ruralguru/ClockRadio_Motherboard/README.md

# ClockRadion_Motherboard
Clock Radio Power Audio Controller board
