ruralguru/ClockRadio_Motherboard/Documents/schematic_generation/Design_Tables.xlsx

Sheet: I2C_Addresses
Table Of I2C Addresses
UID | Priority (1:High) | Board | Ref Des | Purpose | Speed (kHz) | Addr Mask (8 bit) | Address (7 bit) / Hex
1 |  | Display | U301 | LED0 | 1000 | 1aaaaaaW | 1110111 | 77
2 |  | Display | U401 | LED1 | 1000 | 1aaaaaaW | 1111000 | 78
3 |  | Display | U501 | LED2 | 1000 | 1aaaaaaW | 1111010 | 7A
4 |  | Display | U601 | LED3 | 1000 | 1aaaaaaW | 1111011 | 7B
5 |  | Display | U701 | LED4 | 1000 | 1aaaaaaW | 1111100 | 7C
6 |  | Display | U801 | LED5 | 1000 | 1aaaaaaW | 1111101 | 7D
7 |  | Display | U201 | LEDDP | 1000 | 1aaaaaaW | 1111110 | 7E
8 |  | PhysInt | U2 | LEDPI | 1000 | 1aaaaaaW | 1111111 | 7F
9 |  | Amb | TBD | LUX | 400 | 0010100W | 0101001 | 29
10 |  | Amb | SHT35 | Humidity | 1000 | 100010aW | 1000101 | 45
11 |  | Amb | STS35 | Ambient Temp | 1000 | 100101aW | 1001011 | 4B
12 |  | Amb | ICP-10111 | Pressure | 400 | 1100011W | 1100011 | 63
13 |  | Amb | VCNL4200 | Proximity | 400 | 1010001W | 1010001 | 51
14 |  | Main | U25 | PCB Temperature | 3400 | 1001100W | 1001100 | 4C
15 |  | Main | U26 | RTC | 400 | 1101000W | 1101000 | 68
16 |  | Main | U28 | Amplifier | 400 | 001101aW | 0011010 | 1A
17 |  | Main | U301 | V6P0 PI Vsns | 2560 | 100aaaaW | 1000000 | 40
18 |  | Main | U701 | V6P0 Amb Vsns | 2560 | 100aaaaW | 1000001 | 41
19 |  | Main | U11 | V6P0 Disp Vsns | 2560 | 100aaaaW | 1000010 | 42
20 |  | Main | U14 | V12P0 Vsns | 2560 | 100aaaaW | 1000100 | 44
21 |  | Main | U17 | V3P3 I2C Vsvs | 2560 | 100aaaaW | 1000110 | 46
22 |  | Main | U19 | V3P3 Amp Vsns | 2560 | 100aaaaW | 1001000 | 48
23 |  | Main | U21 | VDD Amp Vsns | 2560 | 100aaaaW | 1001001 | 49
24 |  | Main | U23 | V3P3 BT Vsns | 2560 | 100aaaaW | 1001010 | 4A
25 |  | Main | U24 | IO Expander | 400 | a11xxxaW | 0111110 | 3E

Sheet: Physical_Interface_tether
Physical Interface Tether Visual ICD
Pin 1 | Pin 3 | Pin 5 | Pin 7
ANALOG. PI_POT | SYS_EN_N | STBY | GND
Pin 2 | Pin 4 | Pin 6 | Pin 8
I2C SCL | I2C SDA | ANALOG. PI_5WAY | V6P0_PI
Physical Interface Rev 2
Pin 1 | Pin 3 | Pin 5 | Pin 7 | Pin 9
STBY | GND | ANALOG. PI_5WAY | I2C SCL | DET. PI_N
Pin 2 | Pin 4 | Pin 6 | Pin 8 | Pin 10
V6P0_PI | GND | I2C SDA | SYS_EN_N | ANALOG. PI_POT
Visual ICD Legend
POWER | GND | Semi- Static
Data | Analog | CLK

Sheet: Display_tether
Display Tether Visual ICD
Pin 1 | Pin 3 | Pin 5 | Pin 7 | Pin 9
V6P0_DISP | GND | DISP_INT | I2C SCL | DET. DISP_N
Pin 2 | Pin 4 | Pin 6 | Pin 8 | Pin 10
V6P0_DISP | GND | I2C SDA | EN. DISP_OUT | CLK_DISP
Visual ICD Legend
POWER | GND | Semi- Static
Data | Analog | CLK

Sheet: Ambient_tether
Ambient Tether Visual ICD
Pin 1 | Pin 3 | Pin 5 | Pin 7 | Pin 9
V6P0_AMB | GND | INT. AMB_LUX_N | I2C SCL | DET. AMB_N
Pin 2 | Pin 4 | Pin 6 | Pin 8 | Pin 10
V6P0_AMB | GND | I2C SDA | INT. AMB_TEMP_N | INT. AMB_AIR_N
POWER | GND | Semi- Static
Data | Analog | CLK

Sheet: Power Estimates
V24P0 AMP Power Sense Estimates |  |  |  |  |  |  |  |  |  |  | V5P0 MCU Power Sense Estimates |  |  |  |  |  |  |  |  |  |  | V3P3 AMP Power Sense Estimates
Min OR Max | Input Voltage (V) | Output Voltage (V) | Resistor Voltage (V) | Input Current (A) | Load Current (A) | Supply Efficiency (%) | Sense Resistance (Ω) | Input Power (W) | Load Power (W) | Resistor Power (W) | Min OR Max | Input Voltage (V) | Output Voltage (V) | Resistor Voltage (V) | Input Current (A) | Load Current (A) | Supply Efficiency (%) | Sense Resistance (Ω) | Input Power (W) | Load Power (W) | Resistor Power (W) | Min OR Max | Input Voltage (V) | Output Voltage (V) | Resistor Voltage (V) | Input Current (A) | Load Current (A) | Supply Efficiency (%) | Sense Resistance (Ω) | Input Power (W) | Load Power (W) | Resistor Power (W)
Min | 30 | 24 | 0.001 | 0.020 | 0.01 | 40% | 0.10 | 0.60 | 0.24 | 1e-05 | Min | 12 | 5 | 0.00 | 0.104 | 0.10 | 40% | 0.00 | 1.25 | 0.50 | 0.00 | Min | 12 | 3.3 | 0.0001 | 0.0004583472222 | 0.001 | 60% | 0.10 | 0.01 | 0.0033 | 1e-07
Est | 30 | 24 | 0.29 | 2.539 | 2.92 | 93% | 0.10 | 76.18 | 70.00 | 0.851 | Est | 12 | 5 | 0.00 | 0.231 | 0.50 | 90% | 0.00 | 2.78 | 2.50 | 0.00 | Est | 12 | 3.3 | 0.008 | 0.026 | 0.08 | 85% | 0.10 | 0.31 | 0.26 | 0.001
Max | 30 | 24 | 0.54 | 4.80 | 5.40 | 92% | 0.10 | 144.04 | 129.60 | 2.92 | Max | 12 | 5 | 0.00 | 0.49 | 1.00 | 85% | 0.00 | 5.88 | 5.00 | 0.00 | Max | 12 | 3.3 | 0.010 | 0.03 | 0.10 | 90% | 0.10 | 0.37 | 0.33 | 0.001
V12P0 SYS Power Sense Estimates |  |  |  |  |  |  |  |  |  |  | V6P0 Disp Tether Power Sense Estimates |  |  |  |  |  |  |  |  |  |  | V3P3 I2C Power Sense Estimates
Min OR Max | Input Voltage (V) | Output Voltage (V) | Resistor Voltage (V) | Input Current (A) | Load Current (A) | Supply Efficiency (%) | Sense Resistance (Ω) | Input Power (W) | Load Power (W) | Resistor Power (W) | Min OR Max | Input Voltage (V) | Output Voltage (V) | Resistor Voltage (V) | Input Current (A) | Load Current (A) | Supply Efficiency (%) | Sense Resistance (Ω) | Input Power (W) | Load Power (W) | Resistor Power (W) | Min OR Max | Input Voltage (V) | Output Voltage (V) | Resistor Voltage (V) | Input Current (A) | Load Current (A) | Supply Efficiency (%) | Sense Resistance (Ω) | Input Power (W) | Load Power (W) | Resistor Power (W)
Min | 30 | 12 | 0.01 | 0.100 | 0.10 | 40% | 0.10 | 3.00 | 1.20 | 0.001 | Min | 12 | 6 | 0.01 | 0.125 | 0.10 | 40% | 0.10 | 1.50 | 0.60 | 0.001 | Min | 12 | 3.3 | 0.0001 | 0.0004583472222 | 0.001 | 60% | 0.10 | 0.01 | 0.0033 | 1e-07
Est | 30 | 12 | 0.15 | 0.688 | 1.53 | 90% | 0.10 | 20.63 | 18.34 | 0.233 | Est | 12 | 6 | 0.04 | 0.229 | 0.40 | 88% | 0.10 | 2.75 | 2.40 | 0.016 | Est | 12 | 3.3 | 0.008 | 0.026 | 0.08 | 85% | 0.10 | 0.31 | 0.26 | 0.001
Max | 30 | 12 | 0.54 | 2.56 | 5.40 | 88% | 0.10 | 76.95 | 64.80 | 2.92 | Max | 12 | 6 | 0.08 | 0.47 | 0.75 | 80% | 0.10 | 5.70 | 4.50 | 0.06 | Max | 12 | 3.3 | 0.010 | 0.03 | 0.10 | 90% | 0.10 | 0.37 | 0.33 | 0.001
V6P0 Disp Tether Power Sense Estimates |  |  |  |  |  |  |  |  |  |  | V6P0 Ambient Tether Power Sense Estimates |  |  |  |  |  |  |  |  |  |  | V3P3 Bluetooth Power Sense Estimates
Min OR Max | Input Voltage (V) | Output Voltage (V) | Resistor Voltage (V) | Input Current (A) | Load Current (A) | Supply Efficiency (%) | Sense Resistance (Ω) | Input Power (W) | Load Power (W) | Resistor Power (W) | Min OR Max | Input Voltage (V) | Output Voltage (V) | Resistor Voltage (V) | Input Current (A) | Load Current (A) | Supply Efficiency (%) | Sense Resistance (Ω) | Input Power (W) | Load Power (W) | Resistor Power (W) | Min OR Max | Input Voltage (V) | Output Voltage (V) | Resistor Voltage (V) | Input Current (A) | Load Current (A) | Supply Efficiency (%) | Sense Resistance (Ω) | Input Power (W) | Load Power (W) | Resistor Power (W)
Min | 12 | 6 | 0.01 | 0.125 | 0.10 | 40% | 0.10 | 1.50 | 0.60 | 0.001 | Min | 12 | 6 | 0.01 | 0.125 | 0.10 | 40% | 0.10 | 1.50 | 0.60 | 0.001 | Min | 12 | 3.3 | 0.0001 | 0.0004583472222 | 0.001 | 60% | 0.10 | 0.01 | 0.0033 | 1e-07
Est | 12 | 6 | 0.12 | 0.703 | 1.20 | 87% | 0.10 | 8.44 | 7.20 | 0.144 | Est | 12 | 6 | 0.05 | 0.286 | 0.50 | 88% | 0.10 | 3.44 | 3.00 | 0.025 | Est | 12 | 3.3 | 0.008 | 0.026 | 0.08 | 85% | 0.10 | 0.31 | 0.26 | 0.001
Max | 12 | 6 | 0.20 | 1.38 | 2.00 | 75% | 0.10 | 16.53 | 12.00 | 0.40 | Max | 12 | 6 | 0.08 | 0.47 | 0.75 | 80% | 0.10 | 5.70 | 4.50 | 0.06 | Max | 12 | 3.3 | 0.010 | 0.03 | 0.10 | 90% | 0.10 | 0.37 | 0.33 | 0.001
Input Power Estimates
Min Max | Input Voltage (V) |  | Input Current (A) |  | Input Power (W) |  | Input Resistance (Ω)
Min | 30 |  | 0.12 |  | 3.60 |  | 249.82
Est | 30 |  | 3.23 |  | 96.82 |  | 9.30
Max | 30 |  | 7.37 |  | 220.99 |  | 4.07
