ruralguru/ClockRadio_Motherboard/Documents/Block_Diagram/clockradio_main.pdf

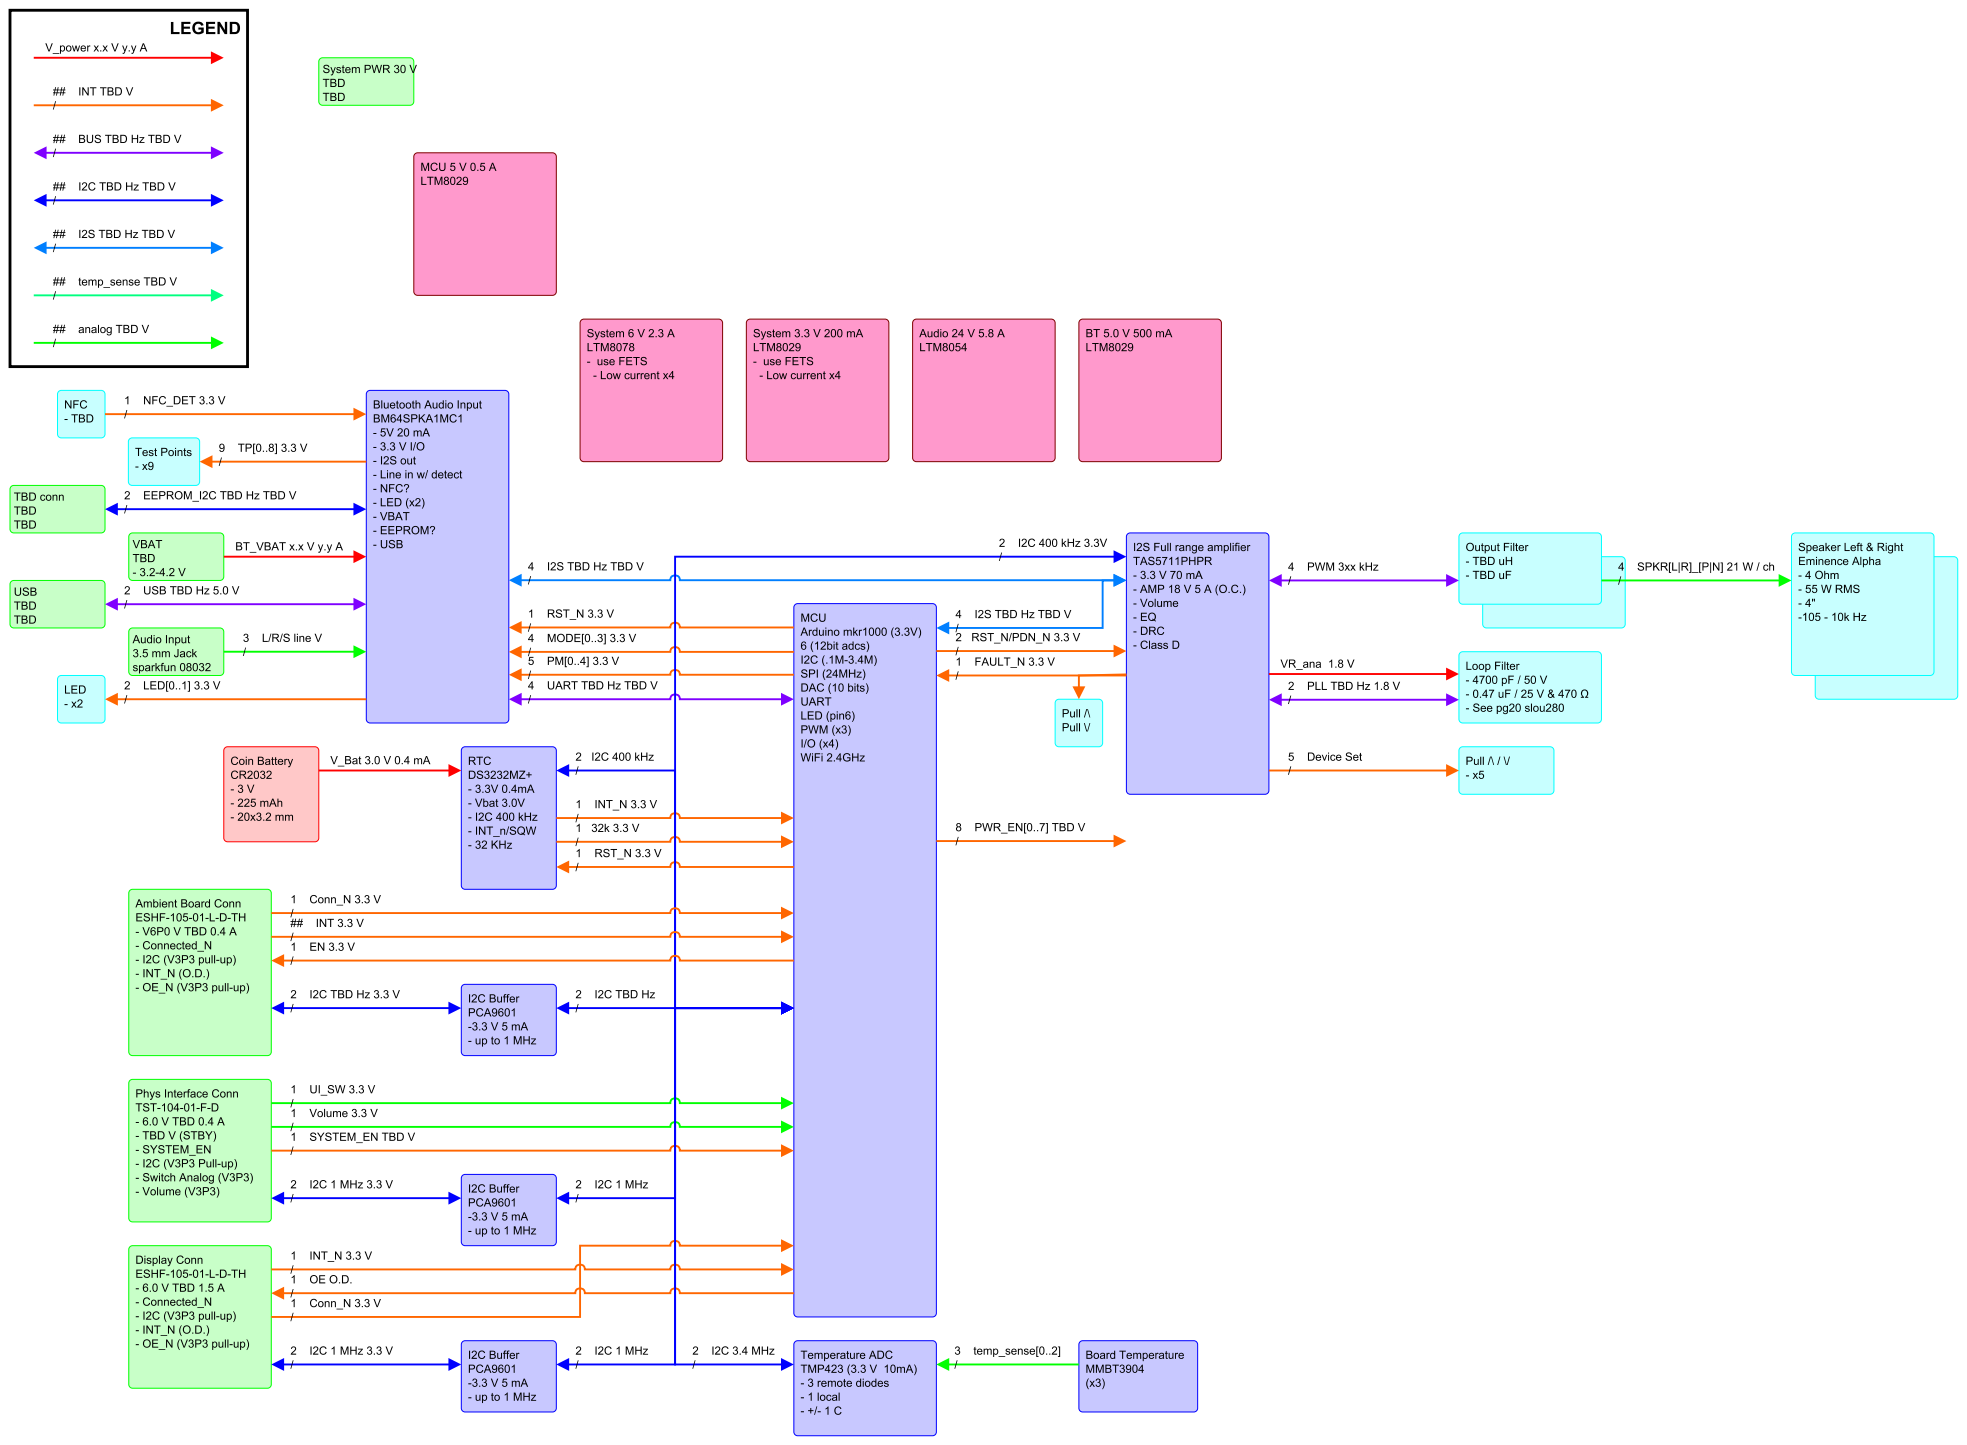
[picture p1: page 1]
