ruralguru/ClockRadio_Motherboard/3p5mm_jack.kicad_sch

## KiCad design 3p5mm_jack.kicad_sch (2022-05-10)

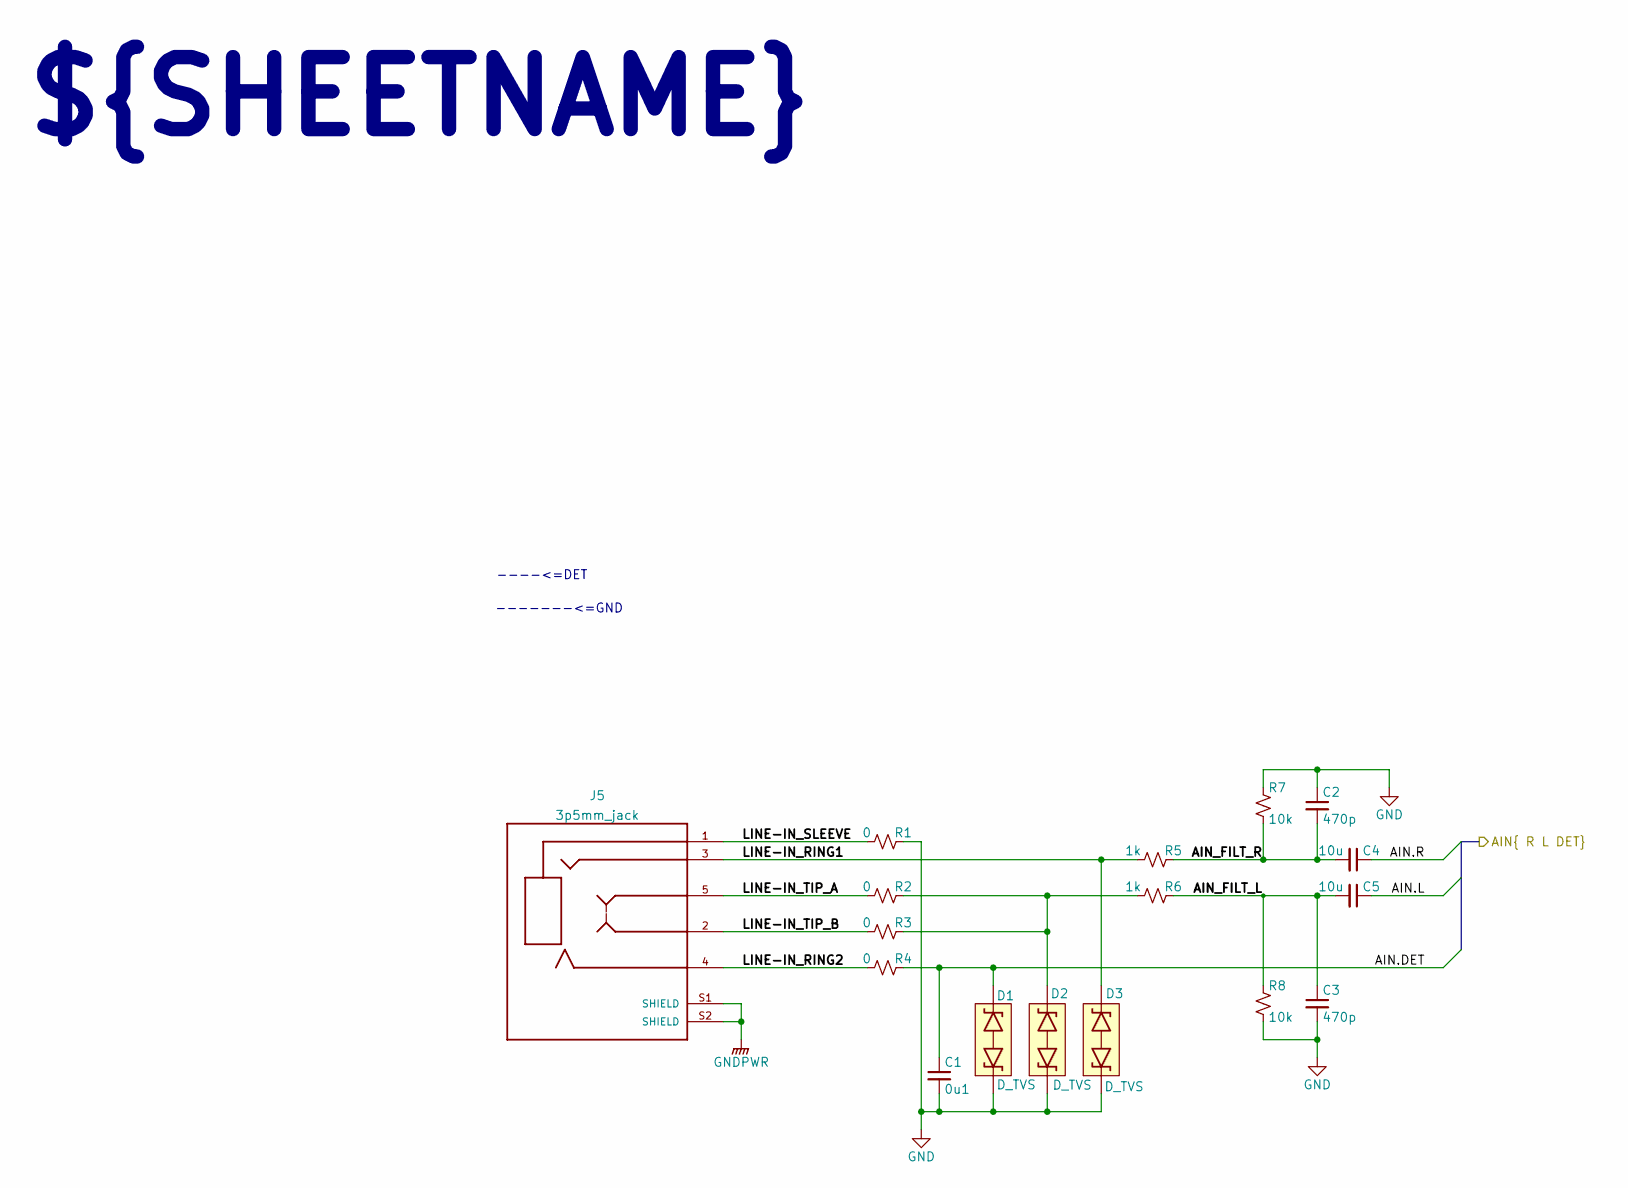
[picture p2: schematic 3p5mm_jack.kicad_sch]

Parts:
C1: 0u1; C_0603_1608Metric_Pad1.08x0.95mm_HandSolder; MPN C0603C104J5RACTU
C2, C3: 470p; C_0603_1608Metric_Pad1.08x0.95mm_HandSolder; MPN CC0603KPX7R9BB471
C4, C5: 10u; C_0805_2012Metric_Pad1.18x1.45mm_HandSolder; MPN EMK212BB7106KG-T
D1, D2, D3: D_TVS; D_SOD-962; MPN SPE0572
J5: 3p5mm_jack; CUI_SJ-3541AS-SMT-TR-67; MPN SJ-3541AS-SMT-TR-67
R1, R2, R3, R4: 0; R_0603_1608Metric_Pad0.98x0.95mm_HandSolder; MPN RC0603FR-130RL
R5, R6: 1k; R_0603_1608Metric_Pad0.98x0.95mm_HandSolder; MPN AC0603FR-101KL
R7, R8: 10k; R_0603_1608Metric_Pad0.98x0.95mm_HandSolder; MPN AC0603FR-1310KL

Connections:
AIN.DET: C1.1, D1.2 (A2), R4.1
AIN.L: C5.1
AIN.R: C4.1
AIN_FILT_L: C3.1, C5.2, R6.1, R8.1
AIN_FILT_R: C2.2, C4.2, R5.1, R7.2
GND: C1.2, C2.1, C3.2, D1.1 (A1), D2.1 (A1), D3.1 (A1), R1.1, R7.1, R8.2
GNDPWR: J5.S1 (SHIELD), J5.S2 (SHIELD)
LINE-IN_RING1: D3.2 (A2), J5.3, R5.2
LINE-IN_RING2: J5.4, R4.2
LINE-IN_SLEEVE: J5.1, R1.2
LINE-IN_TIP_A: J5.5, R2.2
LINE-IN_TIP_B: J5.2, R3.2
unnamed: D2.2 (A2), R2.1, R3.1, R6.2

Notes on the sheet:
-------<=GND
${SHEETNAME}
----<=DET
