ruralguru/ClockRadio_Motherboard/AMP_PWR_GND.kicad_sch

## KiCad design AMP_PWR_GND.kicad_sch (2022-05-10)

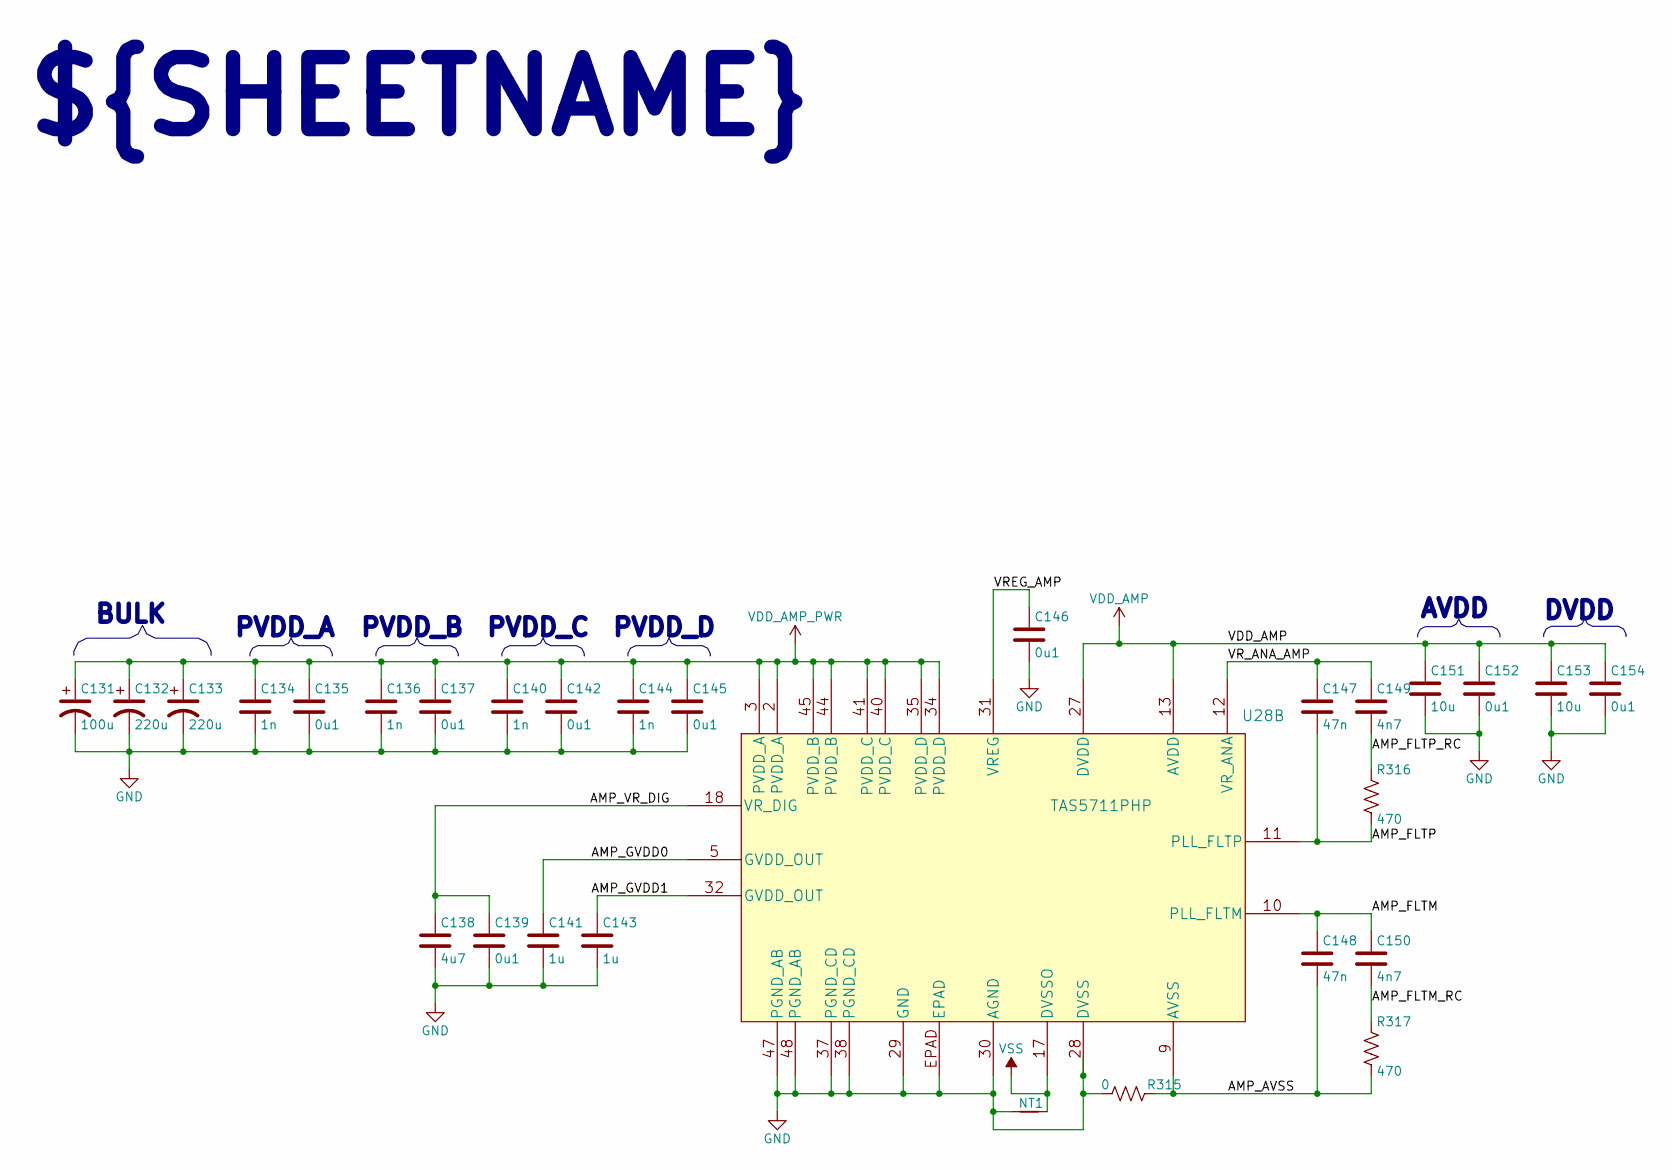
[picture p3: schematic AMP_PWR_GND.kicad_sch]

Parts:
C131: 100u; CP_Radial_D12.5mm_P5.00mm; MPN UPJ1J101MHD6
C132, C133: 220u; CP_Radial_D10.0mm_P5.00mm; MPN B41858C6227M
C134, C136, C140, C144: 1n; C_0603_1608Metric_Pad1.08x0.95mm_HandSolder; MPN C0603C102J5RACTU
C135, C137, C139, C142, C145, C146, C152, C154: 0u1; C_0603_1608Metric_Pad1.08x0.95mm_HandSolder; MPN C0603C104J5RACTU
C138: 4u7; C_1206_3216Metric_Pad1.33x1.80mm_HandSolder; MPN CL31B475KBHNFNE
C141, C143: 1u; C_0805_2012Metric_Pad1.18x1.45mm_HandSolder; MPN CL21B105KBFNFNE
C147, C148: 47n; C_0603_1608Metric_Pad1.08x0.95mm_HandSolder; MPN CL10B473KB8NNNL
C149, C150: 4n7; C_0603_1608Metric_Pad1.08x0.95mm_HandSolder; MPN CC0603KRX7R9BB472
C151, C153: 10u; C_0805_2012Metric_Pad1.18x1.45mm_HandSolder; MPN EMK212BB7106KG-T
NT1: VSSO; NetTie-2_SMD_Pad2.0mm
R315: 0; R_0603_1608Metric_Pad0.98x0.95mm_HandSolder; MPN RC0603FR-130RL
R316, R317: 470; R_0603_1608Metric_Pad0.98x0.95mm_HandSolder; MPN RC0603FR-07470RL
U28: TAS5711PHP; QFP48_EP; MPN TAS5711PHPR

Connections:
AMP_AVSS: C148.2, R315.1, R317.1, U28.9 (AVSS)
AMP_FLTM: C148.1, C150.1, U28.10 (PLL_FLTM)
AMP_FLTM_RC: C150.2, R317.2
AMP_FLTP: C147.2, R316.1, U28.11 (PLL_FLTP)
AMP_FLTP_RC: C149.2, R316.2
AMP_GVDD0: C141.1, U28.5 (GVDD_OUT)
AMP_GVDD1: C143.1, U28.32 (GVDD_OUT)
AMP_VR_DIG: C138.1, C139.1, U28.18 (VR_DIG)
GND: C131.2, C132.2, C133.2, C134.2, C135.2, C136.2, C137.2, C138.2, C139.2, C140.2, C141.2, C142.2, C143.2, C144.2, C145.2, C146.2, C151.2, C152.2, C153.2, C154.2, NT1.1, R315.2, U28.28 (DVSS), U28.29 (GND), U28.30 (AGND), U28.37 (PGND_CD), U28.38 (PGND_CD), U28.47 (PGND_AB), U28.48 (PGND_AB), U28.EPAD
VDD_AMP: C151.1, C152.1, C153.1, C154.1, U28.13 (AVDD), U28.27 (DVDD)
VDD_AMP_PWR: C131.1, C132.1, C133.1, C134.1, C135.1, C136.1, C137.1, C140.1, C142.1, C144.1, C145.1, U28.2 (PVDD_A), U28.3 (PVDD_A), U28.34 (PVDD_D), U28.35 (PVDD_D), U28.40 (PVDD_C), U28.41 (PVDD_C), U28.44 (PVDD_B), U28.45 (PVDD_B)
VREG_AMP: C146.1, U28.31 (VREG)
VR_ANA_AMP: C147.1, C149.1, U28.12 (VR_ANA)
VSS: NT1.2, U28.17 (DVSSO)

Notes on the sheet:
BULK
PVDD_D
PVDD_A
${SHEETNAME}
PVDD_C
PVDD_B
AVDD
DVDD
