ruralguru/ClockRadio_Motherboard/Amplifier.kicad_sch

## KiCad design Amplifier.kicad_sch (2022-05-10)

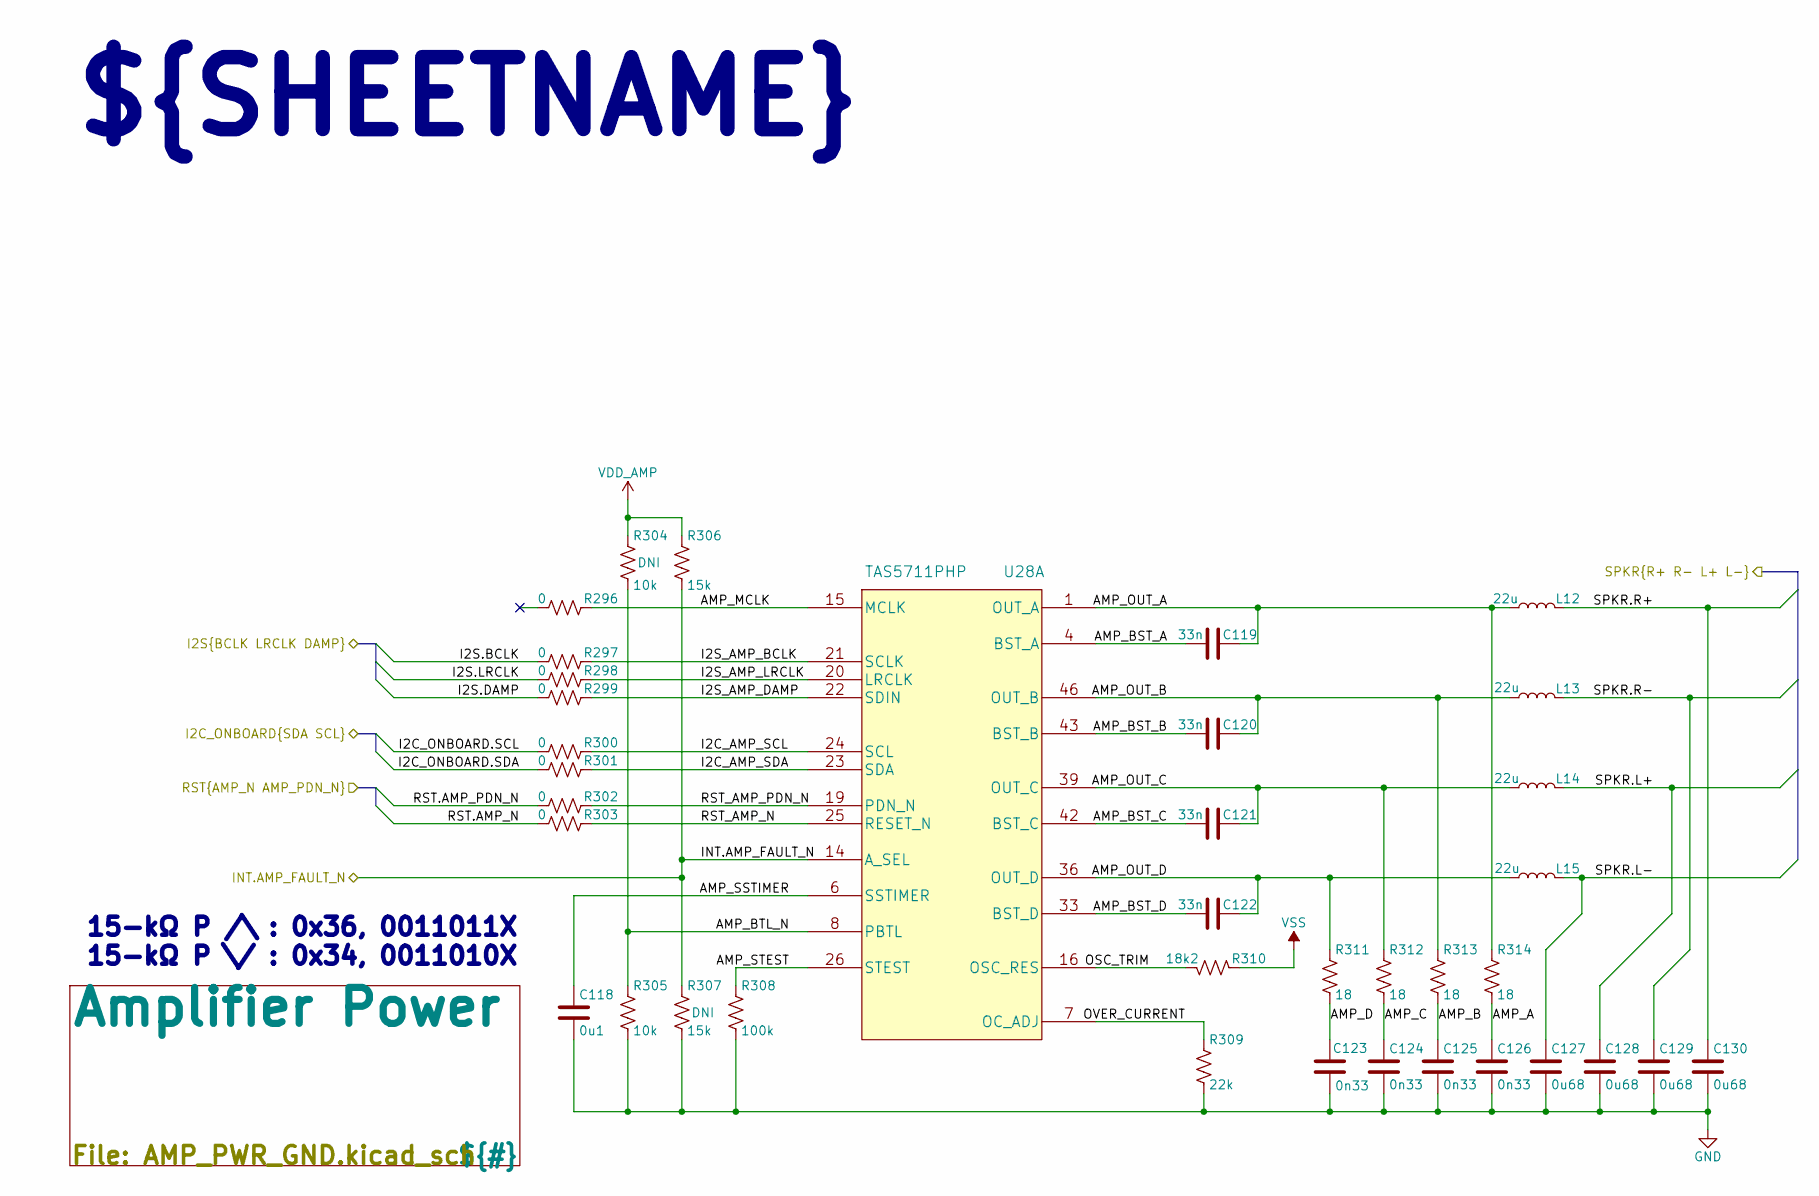
[picture p4: schematic Amplifier.kicad_sch]

Parts:
C118: 0u1; C_0603_1608Metric_Pad1.08x0.95mm_HandSolder; MPN C0603C104J5RACTU
C119, C120, C121, C122: 33n; C_0603_1608Metric_Pad1.08x0.95mm_HandSolder; MPN CC0603JRX7R9BB333
C123, C124, C125, C126: 0n33; C_0805_2012Metric_Pad1.18x1.45mm_HandSolder; MPN C0805C331G5GACTU
C127, C128, C129, C130: 0u68; C_1206_3216Metric_Pad1.33x1.80mm_HandSolder; MPN C1206C684K5RACTU
L12, L13, L14, L15: 22u; L_Radial_D7.5mm_P3.50mm_Fastron_07P; MPN DR0608-223L
R296, R297, R298, R299, R300, R301, R302, R303: 0; R_0603_1608Metric_Pad0.98x0.95mm_HandSolder; MPN RC0603FR-130RL
R304, R305: 10k; R_0603_1608Metric_Pad0.98x0.95mm_HandSolder; MPN AC0603FR-1310KL
R306, R307: 15k; R_0603_1608Metric_Pad0.98x0.95mm_HandSolder; MPN RC0603FR-1015KL
R308: 100k; R_0603_1608Metric_Pad0.98x0.95mm_HandSolder; MPN RC0603FR-10100KL
R309: 22k; R_0603_1608Metric_Pad0.98x0.95mm_HandSolder; MPN RT0603FRE1322KL
R310: 18k2; R_0603_1608Metric_Pad0.98x0.95mm_HandSolder; MPN AC0603FR-134K99L
R311, R312, R313, R314: 18; R_0603_1608Metric_Pad0.98x0.95mm_HandSolder; MPN AC0603FR-0718RL
U28: TAS5711PHP; QFP48_EP; MPN TAS5711PHPR

Connections:
AMP_A: C126.1, R314.1
AMP_B: C125.1, R313.1
AMP_BST_A: C119.2, U28.4 (BST_A)
AMP_BST_B: C120.2, U28.43 (BST_B)
AMP_BST_C: C121.2, U28.42 (BST_C)
AMP_BST_D: C122.2, U28.33 (BST_D)
AMP_BTL_N: R304.1, R305.2, U28.8 (PBTL)
AMP_C: C124.1, R312.1
AMP_D: C123.1, R311.1
AMP_MCLK: R296.2, U28.15 (MCLK)
AMP_OUT_A: C119.1, L12.1, R314.2, U28.1 (OUT_A)
AMP_OUT_B: C120.1, L13.1, R313.2, U28.46 (OUT_B)
AMP_OUT_C: C121.1, L14.1, R312.2, U28.39 (OUT_C)
AMP_OUT_D: C122.1, L15.1, R311.2, U28.36 (OUT_D)
AMP_SSTIMER: C118.1, U28.6 (SSTIMER)
AMP_STEST: R308.2, U28.26 (STEST)
GND: C118.2, C123.2, C124.2, C125.2, C126.2, C127.2, C128.2, C129.2, C130.2, R305.1, R307.1, R308.1, R309.1
I2C_AMP_SCL: R300.2, U28.24 (SCL)
I2C_AMP_SDA: R301.2, U28.23 (SDA)
I2C_ONBOARD.SCL: R300.1
I2C_ONBOARD.SDA: R301.1
I2S.BCLK: R297.1
I2S.DAMP: R299.1
I2S.LRCLK: R298.1
I2S_AMP_BCLK: R297.2, U28.21 (SCLK)
I2S_AMP_DAMP: R299.2, U28.22 (SDIN)
I2S_AMP_LRCLK: R298.2, U28.20 (LRCLK)
INT.AMP_FAULT_N: R306.1, R307.2, U28.14 (A_SEL)
OSC_TRIM: R310.1, U28.16 (OSC_RES)
OVER_CURRENT: R309.2, U28.7 (OC_ADJ)
RST.AMP_N: R303.1
RST.AMP_PDN_N: R302.1
RST_AMP_N: R303.2, U28.25 (RESET_N)
RST_AMP_PDN_N: R302.2, U28.19 (PDN_N)
SPKR.L+: C128.1, L14.2
SPKR.L-: C127.1, L15.2
SPKR.R+: C130.1, L12.2
SPKR.R-: C129.1, L13.2
VDD_AMP: R304.2, R306.2
VSS: R310.2

Notes on the sheet:
${SHEETNAME}
15-kΩ P /\ : 0x36, 0011011X 15-kΩ P \/ : 0x34, 0011010X
