ruralguru/ClockRadio_Motherboard/Bluetooth.kicad_sch

## KiCad design Bluetooth.kicad_sch (2022-05-10)

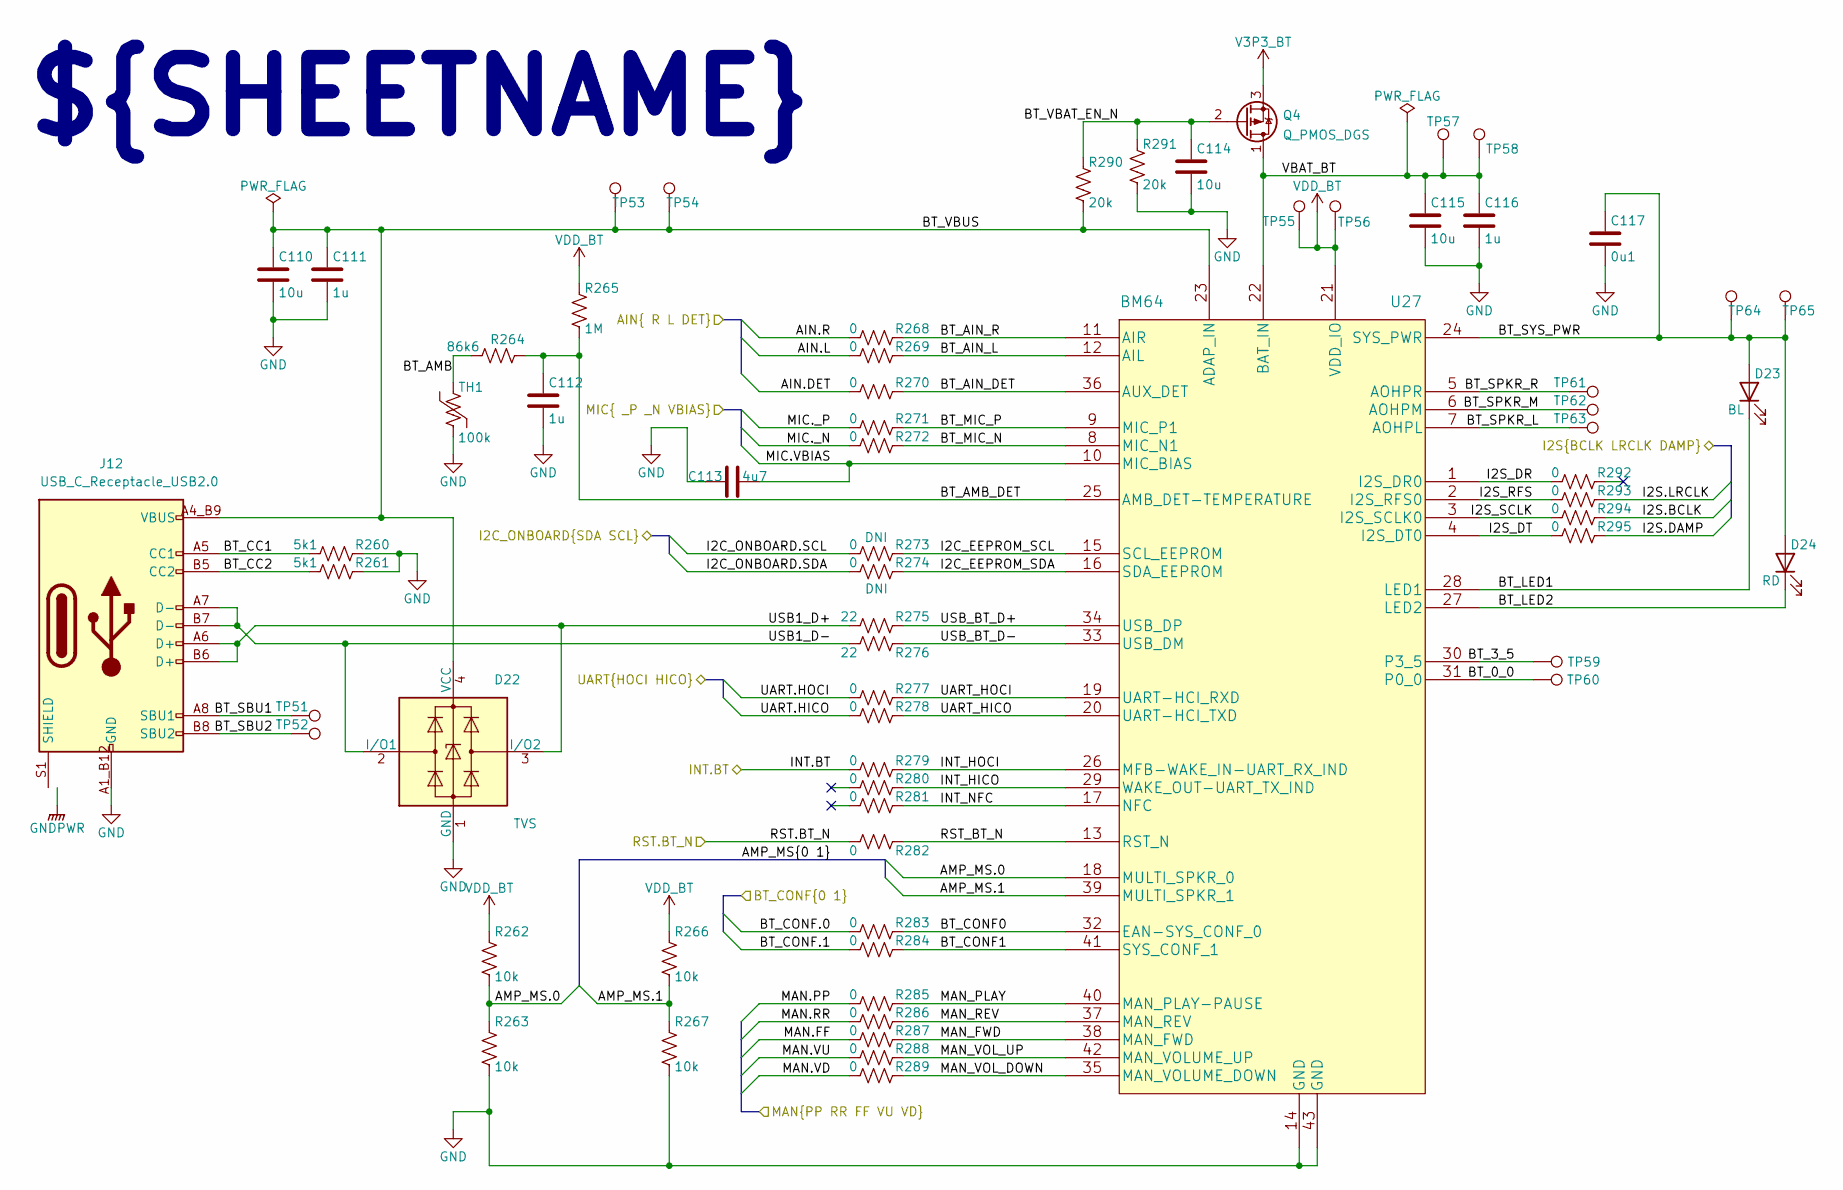
[picture p5: schematic Bluetooth.kicad_sch]

Parts:
C110, C114, C115: 10u; C_0805_2012Metric_Pad1.18x1.45mm_HandSolder; MPN EMK212BB7106KG-T
C111, C112, C116: 1u; C_0805_2012Metric_Pad1.18x1.45mm_HandSolder; MPN CL21B105KBFNFNE
C113: 4u7; C_1206_3216Metric_Pad1.33x1.80mm_HandSolder; MPN CL31B475KBHNFNE
C117: 0u1; C_0603_1608Metric_Pad1.08x0.95mm_HandSolder; MPN C0603C104J5RACTU
D22: TVS; SOT-143; MPN PRTR5V0U2X,215
D23: BL; LED_0603_1608Metric_Pad1.05x0.95mm_HandSolder; MPN 150060BS75000
D24: RD; LED_0603_1608Metric_Pad1.05x0.95mm_HandSolder; MPN 150060SS75000
J12: USB_C_Receptacle_USB2.0; GCT_USB4500-03-1; MPN USB4500-03-1-A
Q4: Q_PMOS_DGS; SOT-23; MPN PMV50UPE,215
R260, R261: 5k1; R_0603_1608Metric_Pad0.98x0.95mm_HandSolder; MPN AC0603FR-075K1L
R262, R263, R266, R267: 10k; R_0603_1608Metric_Pad0.98x0.95mm_HandSolder; MPN AC0603FR-1310KL
R264: 86k6; R_0603_1608Metric_Pad0.98x0.95mm_HandSolder; MPN AC0603FR-0786K6L
R265: 1M; R_0603_1608Metric_Pad0.98x0.95mm_HandSolder; MPN RC0603FR-101ML
R268, R269, R270, R271, R272, R273, R274, R277, R278, R279, R280, R281, R282, R283, R284, R285, R286, R287, R288, R289, R292, R293, R294, R295: 0; R_0603_1608Metric_Pad0.98x0.95mm_HandSolder; MPN RC0603FR-130RL
R275, R276: 22; R_0603_1608Metric_Pad0.98x0.95mm_HandSolder; MPN RC0603FR-1322RL
R290, R291: 20k; R_0603_1608Metric_Pad0.98x0.95mm_HandSolder; MPN RC0603FR-0720KL
TH1: 100k; R_0402_1005Metric_Pad0.72x0.64mm_HandSolder; MPN NCP15WF104F03RC
TP51, TP52, TP53, TP54, TP55, TP56, TP57, TP58, TP59, TP60, TP61, TP62, TP63, TP64, TP65: TestPoint; TestPoint_Pad_D2.0mm
U27: BM64; MPN BM64SPKA1MC1-0001AA

Connections:
AIN.DET: R270.1
AIN.L: R269.1
AIN.R: R268.1
AMP_MS.0: R262.1, R263.2, U27.18 (MULTI_SPKR_0)
AMP_MS.1: R266.1, R267.2, U27.39 (MULTI_SPKR_1)
BT_0_0: TP60.1, U27.31 (P0_0)
BT_3_5: TP59.1, U27.30 (P3_5)
BT_AIN_DET: R270.2, U27.36 (AUX_DET)
BT_AIN_L: R269.2, U27.12 (AIL)
BT_AIN_R: R268.2, U27.11 (AIR)
BT_AMB: R264.1, TH1.1
BT_AMB_DET: C112.1, R264.2, R265.1, U27.25 (AMB_DET-TEMPERATURE)
BT_CC1: J12.A5 (CC1), R260.1
BT_CC2: J12.B5 (CC2), R261.1
BT_CONF0: R283.2, U27.32 (EAN-SYS_CONF_0)
BT_CONF1: R284.2, U27.41 (SYS_CONF_1)
BT_CONF.0: R283.1
BT_CONF.1: R284.1
BT_LED1: D23.1 (K), U27.28 (LED1)
BT_LED2: D24.1 (K), U27.27 (LED2)
BT_MIC_N: R272.2, U27.8 (MIC_N1)
BT_MIC_P: R271.2, U27.9 (MIC_P1)
BT_SBU1: J12.A8 (SBU1), TP51.1
BT_SBU2: J12.B8 (SBU2), TP52.1
BT_SPKR_L: TP63.1, U27.7 (AOHPL)
BT_SPKR_M: TP62.1, U27.6 (AOHPM)
BT_SPKR_R: TP61.1, U27.5 (AOHPR)
BT_SYS_PWR: C117.1, D23.2 (A), D24.2 (A), TP64.1, TP65.1, U27.24 (SYS_PWR)
BT_VBAT_EN_N: C114.1, Q4.2 (G), R290.2, R291.2
BT_VBUS: C110.1, C111.1, D22.4 (VCC), J12.A4_B9 (VBUS), J12.B4_A9 (VBUS), R290.1, TP53.1, TP54.1, U27.23 (ADAP_IN)
GND: C110.2, C111.2, C112.2, C113.1, C114.2, C115.2, C116.2, C117.2, D22.1 (GND), J12.A1_B12 (GND), J12.B1_A12 (GND), R260.2, R261.2, R263.1, R267.1, R291.1, TH1.2, U27.14 (GND), U27.43 (GND)
I2C_EEPROM_SCL: R273.2, U27.15 (SCL_EEPROM)
I2C_EEPROM_SDA: R274.2, U27.16 (SDA_EEPROM)
I2C_ONBOARD.SCL: R273.1
I2C_ONBOARD.SDA: R274.1
I2S.BCLK: R294.2
I2S.DAMP: R295.2
I2S.LRCLK: R293.2
I2S_DR: R292.1, U27.1 (I2S_DR0)
I2S_DT: R295.1, U27.4 (I2S_DT0)
I2S_RFS: R293.1, U27.2 (I2S_RFS0)
I2S_SCLK: R294.1, U27.3 (I2S_SCLK0)
INT.BT: R279.1
INT_HICO: R280.2, U27.29 (WAKE_OUT-UART_TX_IND)
INT_HOCI: R279.2, U27.26 (MFB-WAKE_IN-UART_RX_IND)
INT_NFC: R281.2, U27.17 (NFC)
MAN.FF: R287.1
MAN.PP: R285.1
MAN.RR: R286.1
MAN.VD: R289.1
MAN.VU: R288.1
MAN_FWD: R287.2, U27.38 (MAN_FWD)
MAN_PLAY: R285.2, U27.40 (MAN_PLAY-PAUSE)
MAN_REV: R286.2, U27.37 (MAN_REV)
MAN_VOL_DOWN: R289.2, U27.35 (MAN_VOLUME_DOWN)
MAN_VOL_UP: R288.2, U27.42 (MAN_VOLUME_UP)
MIC.VBIAS: C113.2, U27.10 (MIC_BIAS)
MIC._N: R272.1
MIC._P: R271.1
unnamed: J12.S1 (SHIELD), J12.S2 (SHIELD), J12.S3 (SHIELD), J12.S4 (SHIELD)
RST.BT_N: R282.1
RST_BT_N: R282.2, U27.13 (RST_N)
UART.HICO: R278.1
UART.HOCI: R277.1
UART_HICO: R278.2, U27.20 (UART-HCI_TXD)
UART_HOCI: R277.2, U27.19 (UART-HCI_RXD)
USB1_D+: D22.3 (I/O2), J12.A6 (D+), J12.B6 (D+), R275.1
USB1_D-: D22.2 (I/O1), J12.A7 (D-), J12.B7 (D-), R276.1
USB_BT_D+: R275.2, U27.34 (USB_DP)
USB_BT_D-: R276.2, U27.33 (USB_DM)
V3P3_BT: Q4.3 (S)
VBAT_BT: C115.1, C116.1, Q4.1 (D), TP57.1, TP58.1, U27.22 (BAT_IN)
VDD_BT: R262.2, R265.2, R266.2, TP55.1, TP56.1, U27.21 (VDD_IO)

Notes on the sheet:
${SHEETNAME}
