ruralguru/ClockRadio_Motherboard/Conn_Top.kicad_sch

## KiCad design Conn_Top.kicad_sch (2022-05-10)

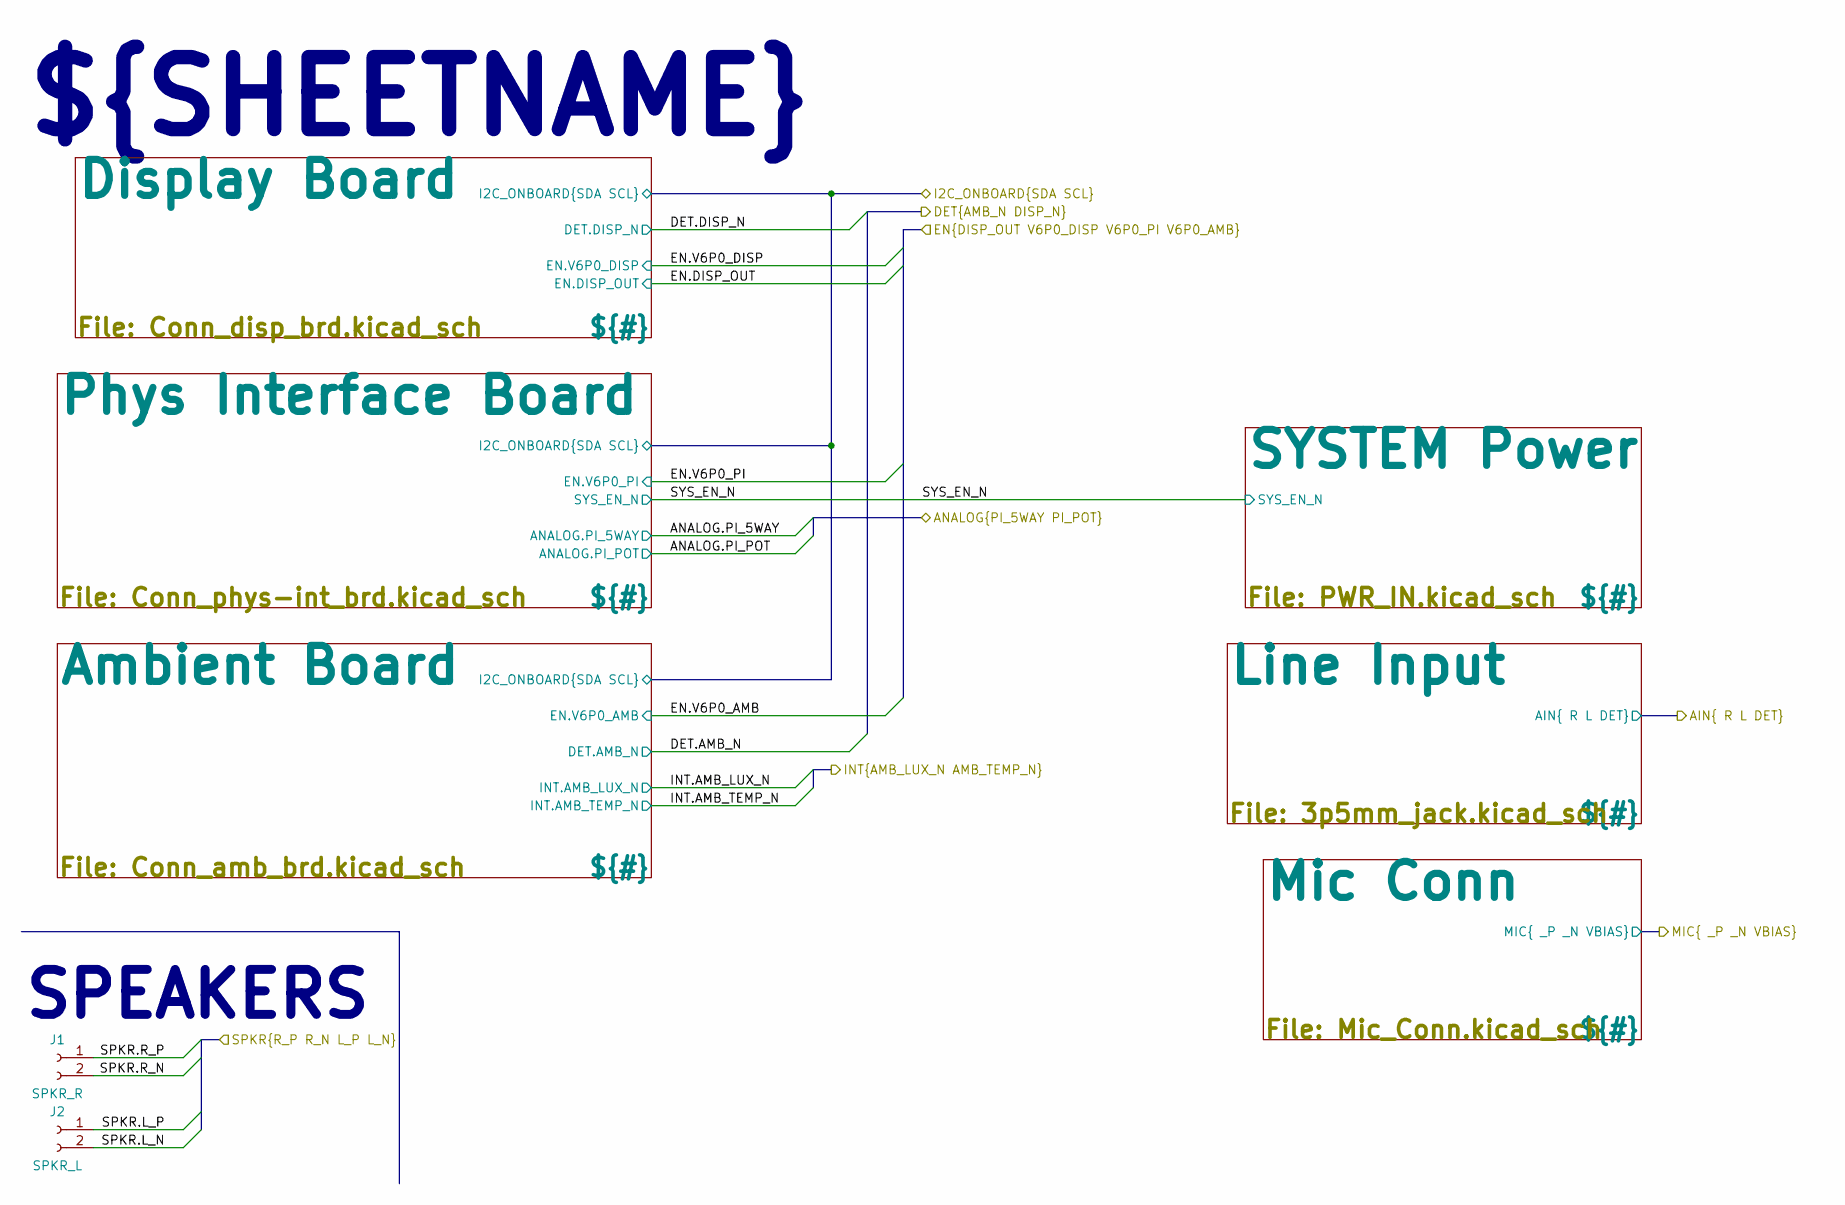
[picture p6: schematic Conn_Top.kicad_sch]

Parts:
J1: SPKR_R; PinHeader_1x02_P2.54mm_Vertical
J2: SPKR_L; PinHeader_1x02_P2.54mm_Vertical

Connections:
SPKR.L_N: J2.2
SPKR.L_P: J2.1
SPKR.R_N: J1.2
SPKR.R_P: J1.1

Notes on the sheet:
${SHEETNAME}
SPEAKERS
