ruralguru/ClockRadio_Motherboard/Conn_amb_brd.kicad_sch

## KiCad design Conn_amb_brd.kicad_sch (2022-05-10)

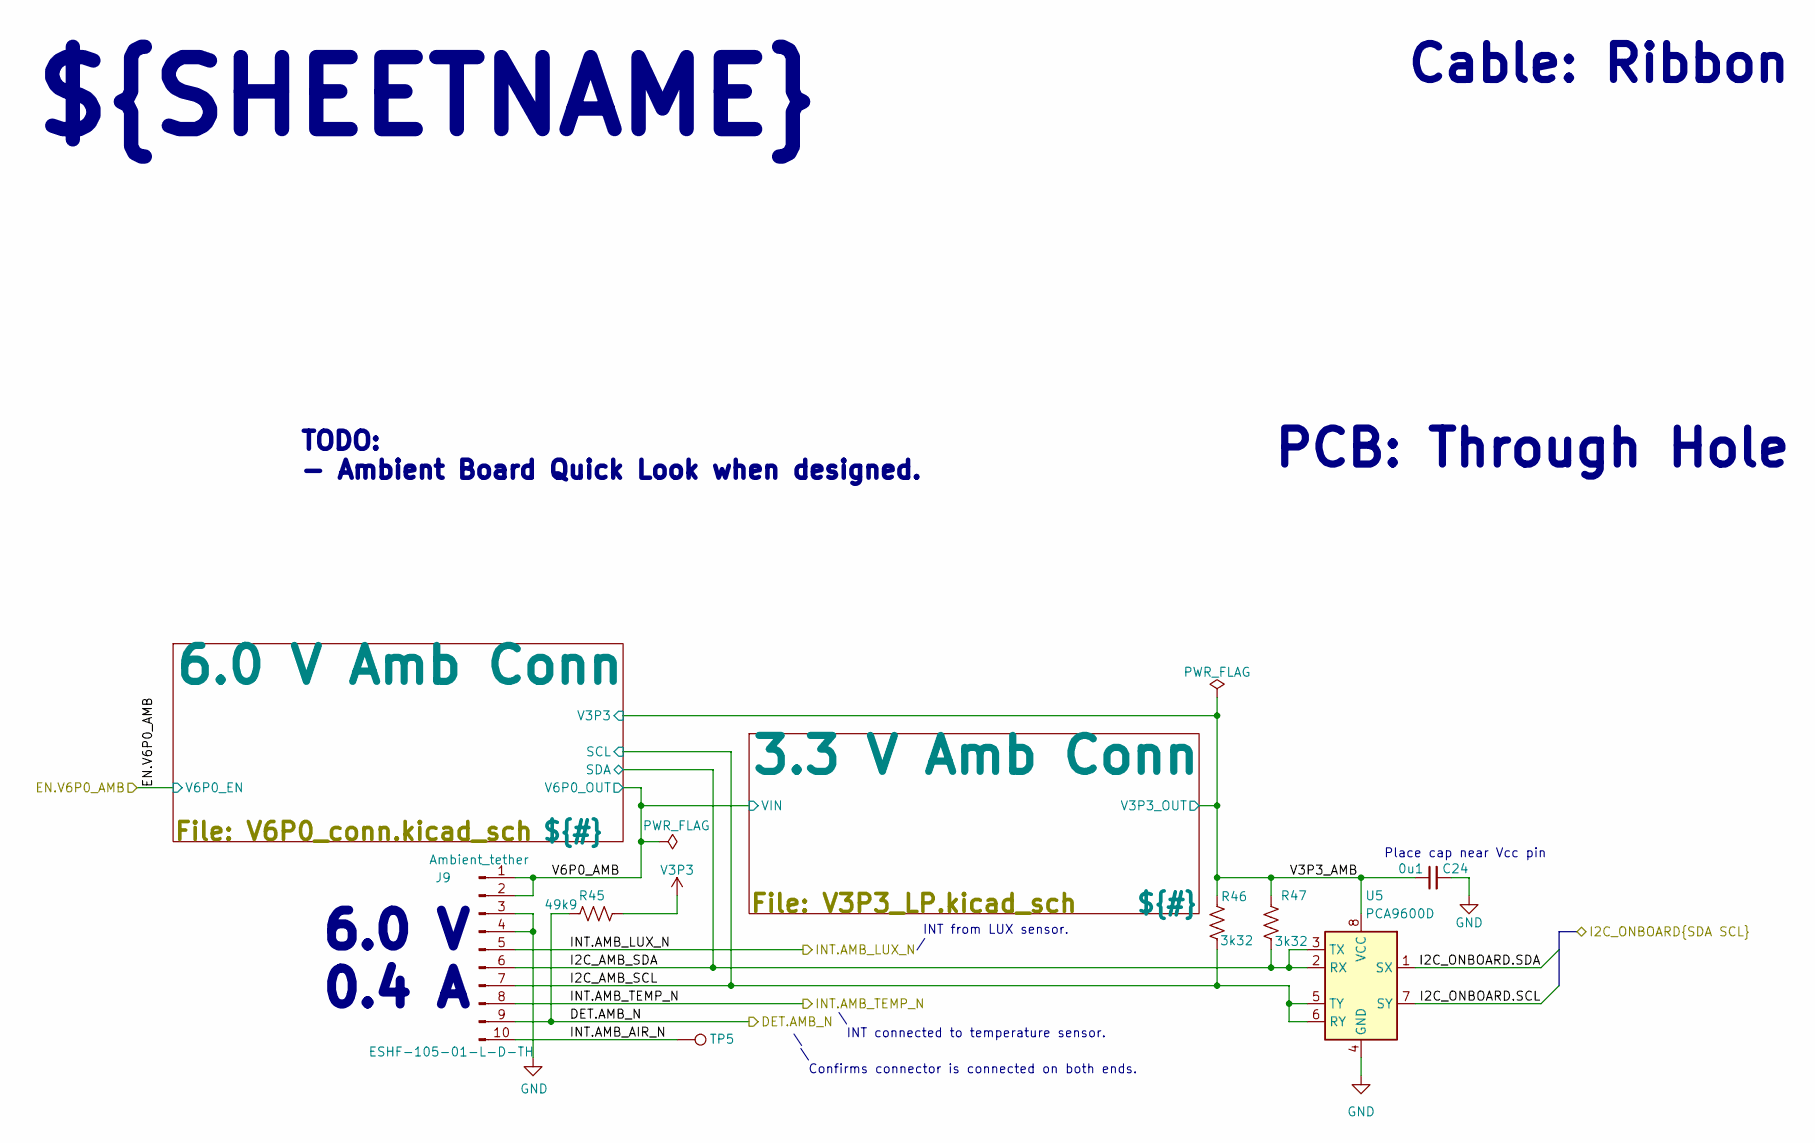
[picture p7: schematic Conn_amb_brd.kicad_sch]

Parts:
C24: 0u1; C_0603_1608Metric_Pad1.08x0.95mm_HandSolder; MPN C0603C104J5RACTU
J9: Ambient_tether; ESHF-105-01-L-D; MPN ESHF-105-01-L-D-TH
R45: 49k9; R_0603_1608Metric_Pad0.98x0.95mm_HandSolder; MPN CRCW060349K9FKEB
R46, R47: 3k32; R_0603_1608Metric_Pad0.98x0.95mm_HandSolder; MPN AC0603FR-073K32L
TP5: TestPoint; TestPoint_Pad_D2.0mm
U5: PCA9600D; SO-8_3.9x4.9mm_P1.27mm; MPN PCA9600D,118

Connections:
DET.AMB_N: J9.9, R45.1
GND: C24.2, J9.3, J9.4, U5.4 (GND)
I2C_AMB_SCL: J9.7, R46.1, U5.5 (TY), U5.6 (RY)
I2C_AMB_SDA: J9.6, R47.1, U5.2 (RX), U5.3 (TX)
I2C_ONBOARD.SCL: U5.7 (SY)
I2C_ONBOARD.SDA: U5.1 (SX)
INT.AMB_AIR_N: J9.10, TP5.1
INT.AMB_LUX_N: J9.5
INT.AMB_TEMP_N: J9.8
V3P3: R45.2
V3P3_AMB: C24.1, R46.2, R47.2, U5.8 (VCC)
V6P0_AMB: J9.1, J9.2

Notes on the sheet:
\ \ Confirms connector is connected on both ends.
Cable: Ribbon
PCB: Through Hole
Place cap near Vcc pin
6.0 V 0.4 A
${SHEETNAME}
INT from LUX sensor. /
\ INT connected to temperature sensor.
TODO: - Ambient Board Quick Look when designed.
