ruralguru/ClockRadio_Motherboard/Conn_disp_brd.kicad_sch

## KiCad design Conn_disp_brd.kicad_sch (2022-05-10)

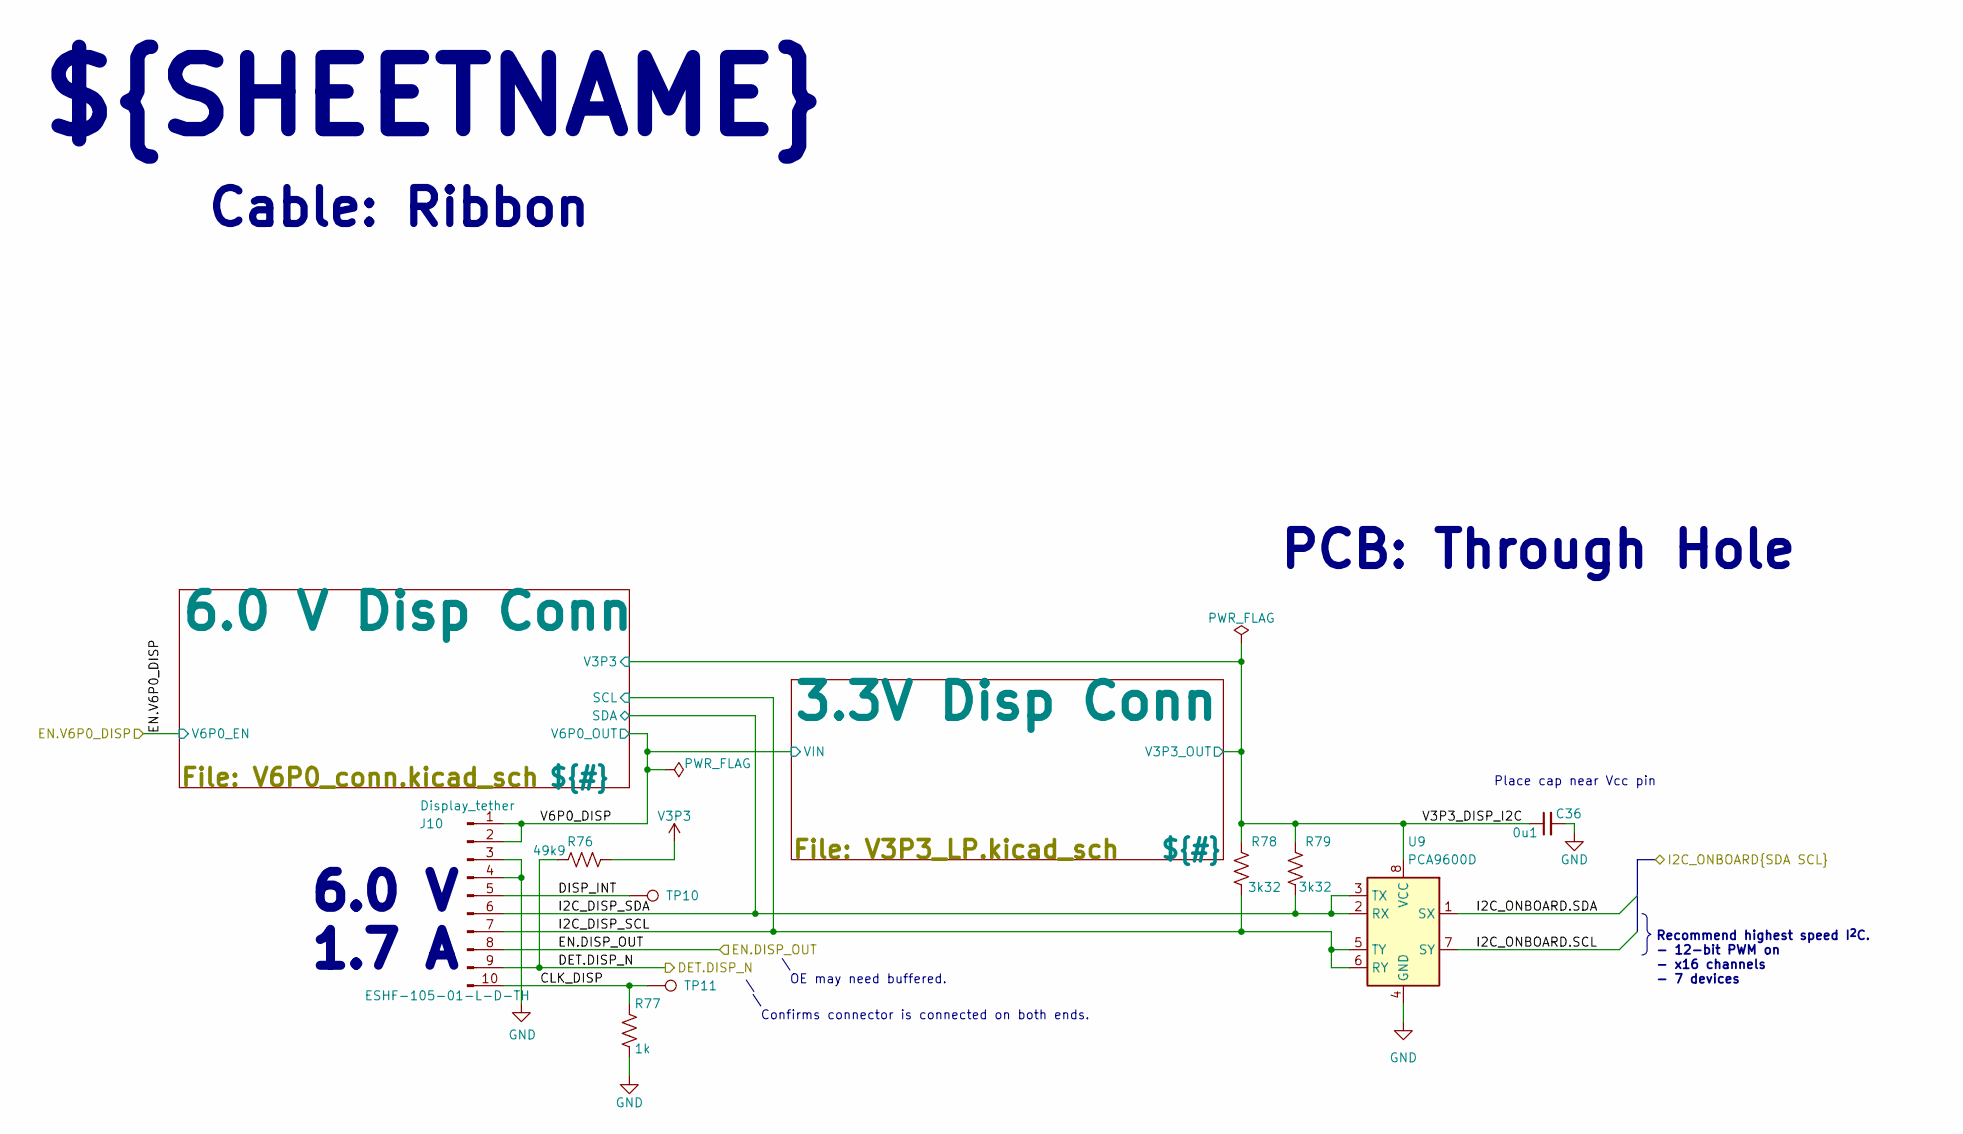
[picture p8: schematic Conn_disp_brd.kicad_sch]

Parts:
C36: 0u1; C_0603_1608Metric_Pad1.08x0.95mm_HandSolder; MPN C0603C104J5RACTU
J10: Display_tether; ESHF-105-01-L-D; MPN ESHF-105-01-L-D-TH
R76: 49k9; R_0603_1608Metric_Pad0.98x0.95mm_HandSolder; MPN CRCW060349K9FKEB
R77: 1k; R_0603_1608Metric_Pad0.98x0.95mm_HandSolder; MPN AC0603FR-101KL
R78, R79: 3k32; R_0603_1608Metric_Pad0.98x0.95mm_HandSolder; MPN AC0603FR-073K32L
TP10, TP11: TestPoint; TestPoint_Pad_D2.0mm
U9: PCA9600D; SO-8_3.9x4.9mm_P1.27mm; MPN PCA9600D,118

Connections:
CLK_DISP: J10.10, R77.2, TP11.1
DET.DISP_N: J10.9, R76.1
DISP_INT: J10.5, TP10.1
EN.DISP_OUT: J10.8
GND: C36.2, J10.3, J10.4, R77.1, U9.4 (GND)
I2C_DISP_SCL: J10.7, R78.1, U9.5 (TY), U9.6 (RY)
I2C_DISP_SDA: J10.6, R79.1, U9.2 (RX), U9.3 (TX)
I2C_ONBOARD.SCL: U9.7 (SY)
I2C_ONBOARD.SDA: U9.1 (SX)
V3P3: R76.2
V3P3_DISP_I2C: C36.1, R78.2, R79.2, U9.8 (VCC)
V6P0_DISP: J10.1, J10.2

Notes on the sheet:
Place cap near Vcc pin
Recommend highest speed I^{2}C. - 12-bit PWM on - x16 channels - 7 devices
${SHEETNAME}
\ OE may need buffered.
Cable: Ribbon
6.0 V 1.7 A
PCB: Through Hole
\ \ Confirms connector is connected on both ends.
