ruralguru/ClockRadio_Motherboard/Conn_phys-int_brd.kicad_sch

## KiCad design Conn_phys-int_brd.kicad_sch (2022-05-10)

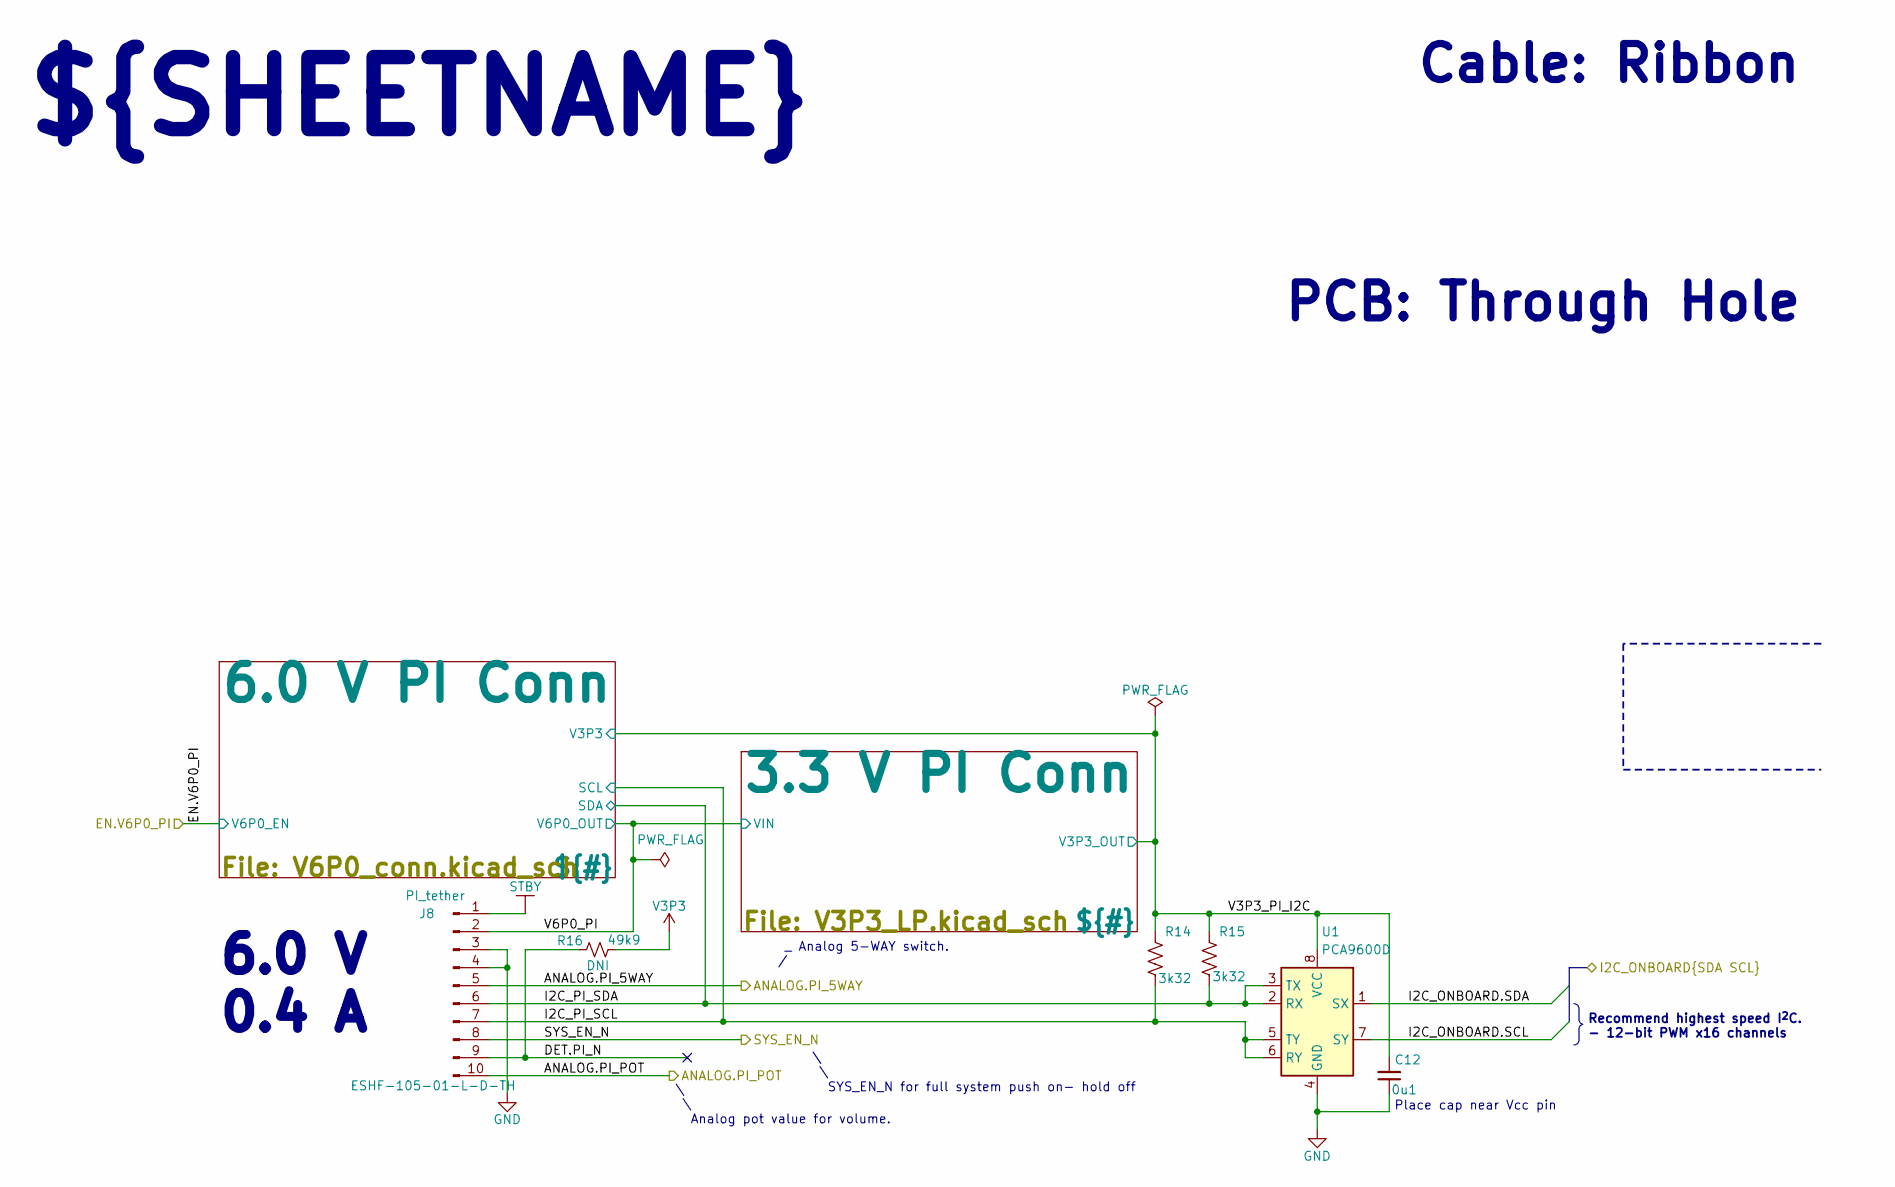
[picture p9: schematic Conn_phys-int_brd.kicad_sch]

Parts:
C12: 0u1; C_0603_1608Metric_Pad1.08x0.95mm_HandSolder; MPN C0603C104J5RACTU
J8: PI_tether; ESHF-105-01-L-D; MPN ESHF-105-01-L-D-TH
R14, R15: 3k32; R_0603_1608Metric_Pad0.98x0.95mm_HandSolder; MPN AC0603FR-073K32L
R16: 49k9; R_0603_1608Metric_Pad0.98x0.95mm_HandSolder; MPN RC0603FR-130RL
U1: PCA9600D; SO-8_3.9x4.9mm_P1.27mm; MPN PCA9600D,118

Connections:
ANALOG.PI_5WAY: J8.5
ANALOG.PI_POT: J8.10
DET.PI_N: J8.9, R16.1
GND: C12.1, J8.3, J8.4, U1.4 (GND)
I2C_ONBOARD.SCL: U1.7 (SY)
I2C_ONBOARD.SDA: U1.1 (SX)
I2C_PI_SCL: J8.7, R14.1, U1.5 (TY), U1.6 (RY)
I2C_PI_SDA: J8.6, R15.1, U1.2 (RX), U1.3 (TX)
STBY: J8.1
SYS_EN_N: J8.8
V3P3: R16.2
V3P3_PI_I2C: C12.2, R14.2, R15.2, U1.8 (VCC)
V6P0_PI: J8.2

Notes on the sheet:
${SHEETNAME}
_ Analog 5-WAY switch. /
6.0 V 0.4 A
Place cap near Vcc pin
Cable: Ribbon
\ \ SYS_EN_N for full system push on- hold off
\ \ Analog pot value for volume.
PCB: Through Hole
Recommend highest speed I^{2}C. - 12-bit PWM x16 channels
