ruralguru/ClockRadio_Motherboard/IO.kicad_sch

## KiCad design IO.kicad_sch (2022-05-10)

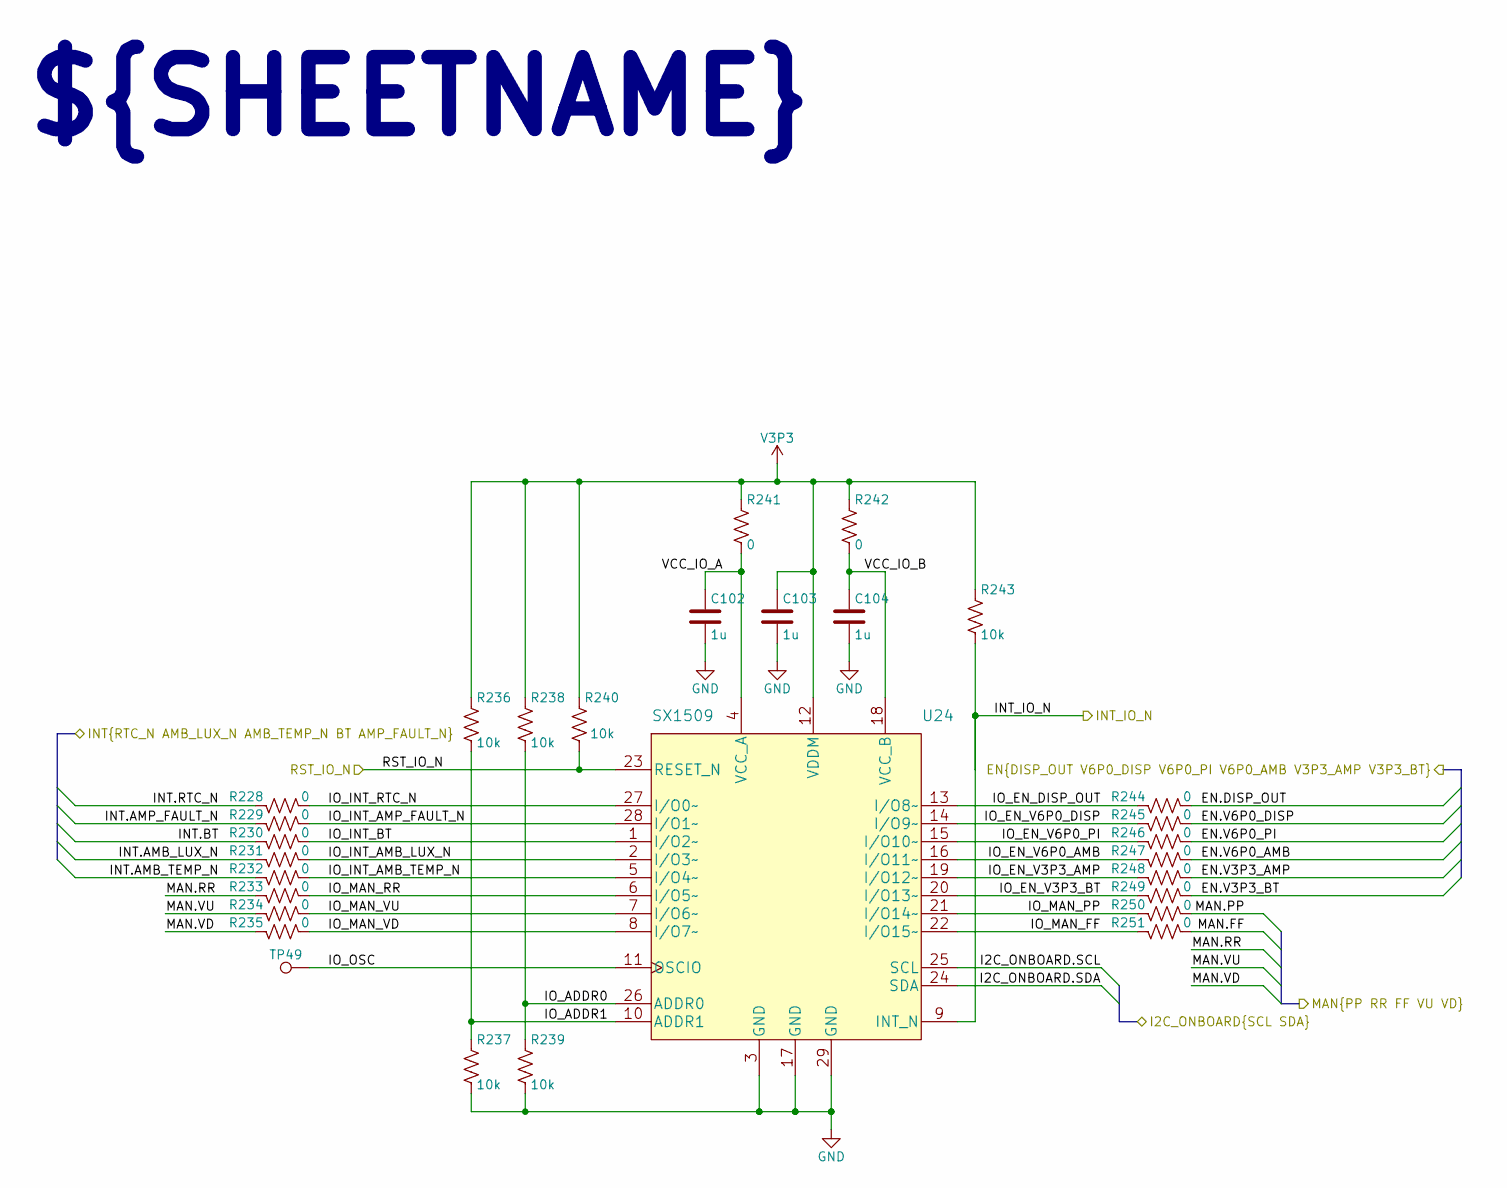
[picture p10: schematic IO.kicad_sch]

Parts:
C102, C103, C104: 1u; C_0805_2012Metric_Pad1.18x1.45mm_HandSolder; MPN CL21B105KBFNFNE
R228, R229, R230, R231, R232, R233, R234, R235, R241, R242, R244, R245, R246, R247, R248, R249, R250, R251: 0; R_0603_1608Metric_Pad0.98x0.95mm_HandSolder; MPN RC0603FR-130RL
R236, R237, R238, R239, R240, R243: 10k; R_0603_1608Metric_Pad0.98x0.95mm_HandSolder; MPN AC0603FR-1310KL
TP49: TestPoint; TestPoint_Pad_D2.0mm
U24: SX1509; QFN-28; MPN SX1509QBIULTRT

Connections:
EN.DISP_OUT: R244.1
EN.V3P3_AMP: R248.1
EN.V3P3_BT: R249.1
EN.V6P0_AMB: R247.1
EN.V6P0_DISP: R245.1
EN.V6P0_PI: R246.1
GND: C102.2, C103.2, C104.2, R237.1, R239.1, U24.3 (GND), U24.17 (GND), U24.29 (GND)
I2C_ONBOARD.SCL: U24.25 (SCL)
I2C_ONBOARD.SDA: U24.24 (SDA)
INT.AMB_LUX_N: R231.2
INT.AMB_TEMP_N: R232.2
INT.AMP_FAULT_N: R229.2
INT.BT: R230.2
INT.RTC_N: R228.2
INT_IO_N: R243.1, U24.9 (INT_N)
IO_ADDR0: R238.1, R239.2, U24.26 (ADDR0)
IO_ADDR1: R236.1, R237.2, U24.10 (ADDR1)
IO_EN_DISP_OUT: R244.2, U24.13 (I/O8~)
IO_EN_V3P3_AMP: R248.2, U24.19 (I/O12~)
IO_EN_V3P3_BT: R249.2, U24.20 (I/O13~)
IO_EN_V6P0_AMB: R247.2, U24.16 (I/O11~)
IO_EN_V6P0_DISP: R245.2, U24.14 (I/O9~)
IO_EN_V6P0_PI: R246.2, U24.15 (I/O10~)
IO_INT_AMB_LUX_N: R231.1, U24.2 (I/O3~)
IO_INT_AMB_TEMP_N: R232.1, U24.5 (I/O4~)
IO_INT_AMP_FAULT_N: R229.1, U24.28 (I/O1~)
IO_INT_BT: R230.1, U24.1 (I/O2~)
IO_INT_RTC_N: R228.1, U24.27 (I/O0~)
IO_MAN_FF: R251.2, U24.22 (I/O15~)
IO_MAN_PP: R250.2, U24.21 (I/O14~)
IO_MAN_RR: R233.1, U24.6 (I/O5~)
IO_MAN_VD: R235.1, U24.8 (I/O7~)
IO_MAN_VU: R234.1, U24.7 (I/O6~)
IO_OSC: TP49.1, U24.11 (OSCIO)
MAN.FF: R251.1
MAN.PP: R250.1
MAN.RR: R233.2
MAN.VD: R235.2
MAN.VU: R234.2
RST_IO_N: R240.1, U24.23 (RESET_N)
V3P3: C103.1, R236.2, R238.2, R240.2, R241.2, R242.2, R243.2, U24.12 (VDDM)
VCC_IO_A: C102.1, R241.1, U24.4 (VCC_A)
VCC_IO_B: C104.1, R242.1, U24.18 (VCC_B)

Notes on the sheet:
${SHEETNAME}
