ruralguru/ClockRadio_Motherboard/MCU.kicad_sch

## KiCad design MCU.kicad_sch (2022-05-10)

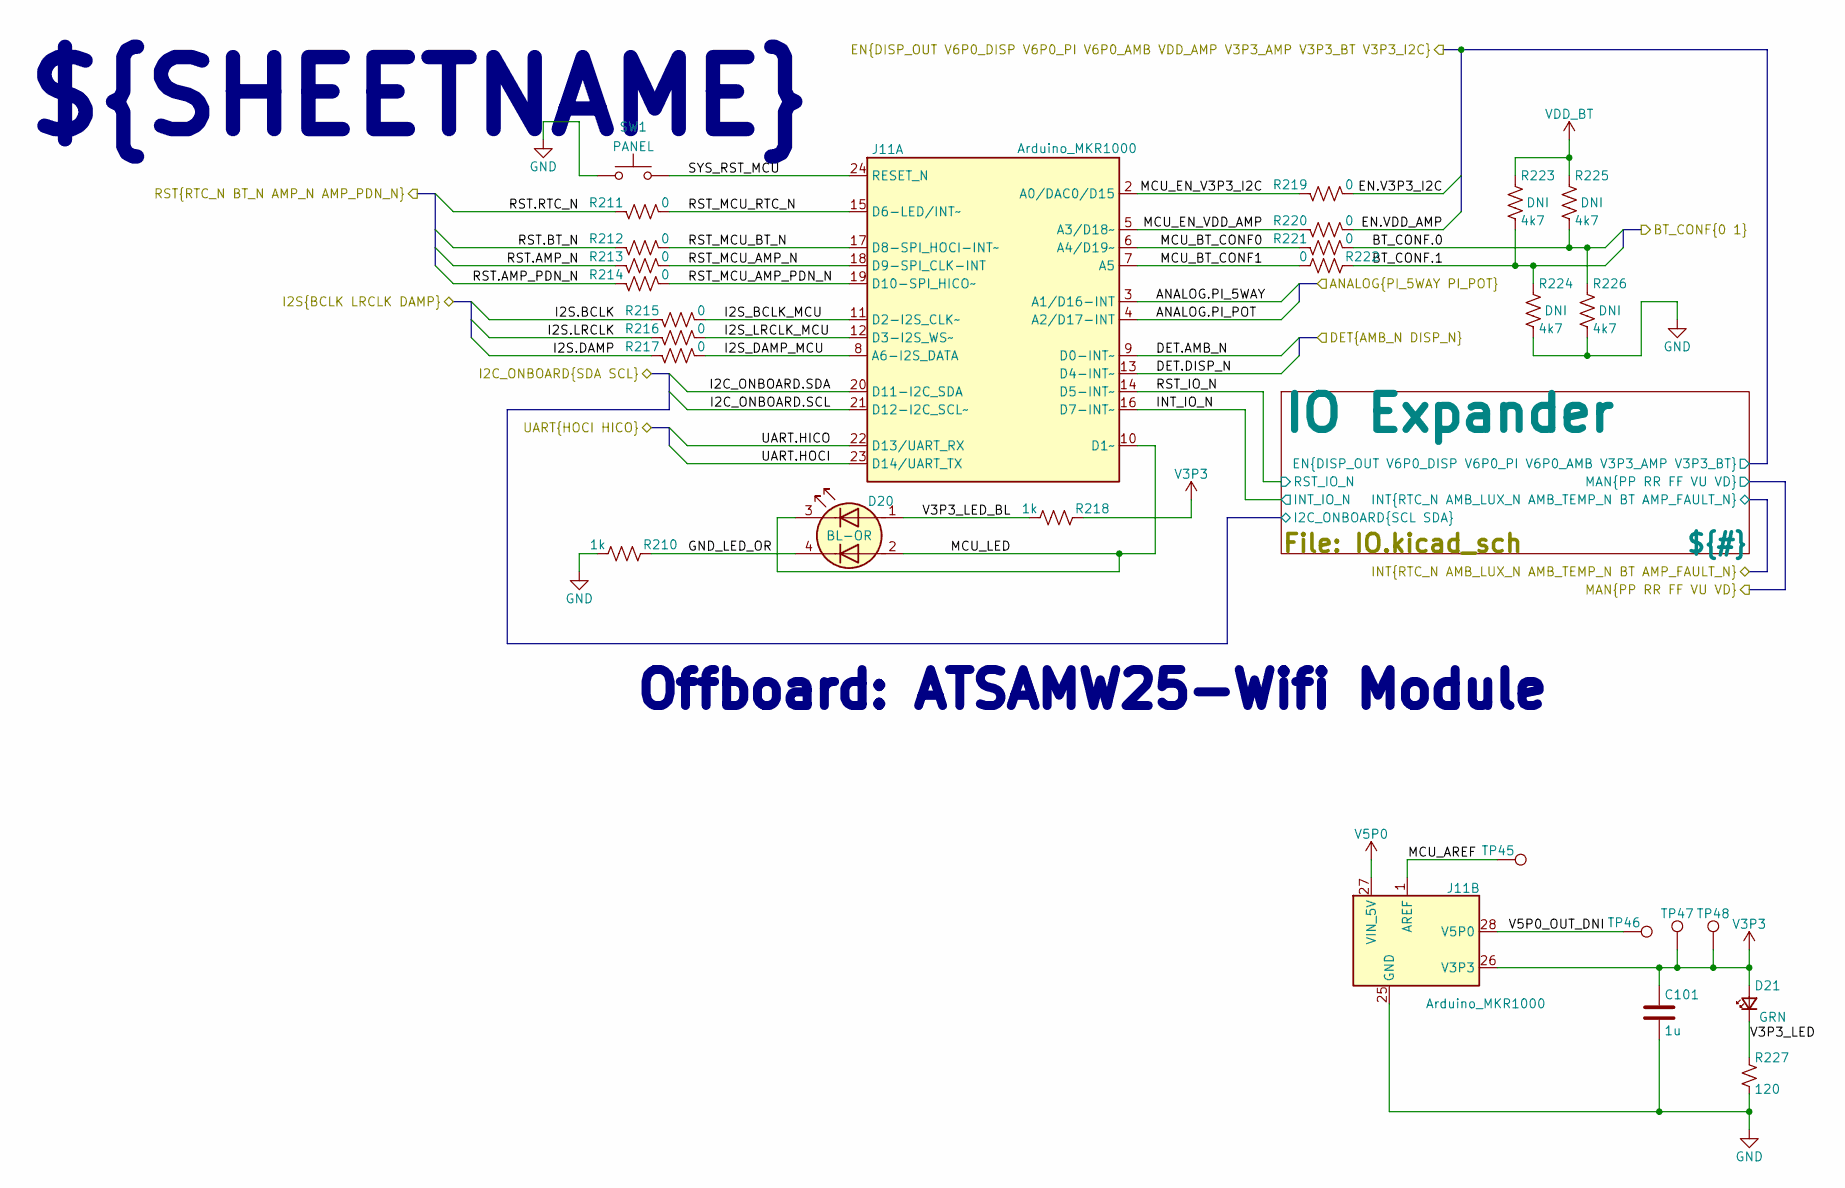
[picture p11: schematic MCU.kicad_sch]

Parts:
C101: 1u; C_0805_2012Metric_Pad1.18x1.45mm_HandSolder; MPN CL21B105KBFNFNE
D20: BL-OR; Double_LED_0603_1608Metric_Castellated; MPN LTST-C195TBKFKT
D21: GRN; LED_0603_1608Metric_Pad1.05x0.95mm_HandSolder; MPN 150060VS55040
J11: Arduino_MKR1000; MKR1000
R210, R218: 1k; R_0603_1608Metric_Pad0.98x0.95mm_HandSolder; MPN AC0603FR-101KL
R211, R212, R213, R214, R215, R216, R217, R219, R220, R221, R222: 0; R_0603_1608Metric_Pad0.98x0.95mm_HandSolder; MPN RC0603FR-130RL
R223, R224, R225, R226: 4k7; R_0603_1608Metric_Pad0.98x0.95mm_HandSolder; MPN AC0603FR-104K7L
R227: 120; R_0603_1608Metric_Pad0.98x0.95mm_HandSolder; MPN RC0603FR-10120RL
SW1: PANEL; SW_SPST_EVQ9P; MPN EVQ-9P701P
TP45, TP46, TP47, TP48: TestPoint; TestPoint_Pad_D2.0mm

Connections:
ANALOG.PI_5WAY: J11.3 (A1/D16-INT)
ANALOG.PI_POT: J11.4 (A2/D17-INT)
BT_CONF.0: R221.1, R225.1, R226.2
BT_CONF.1: R222.2, R223.1, R224.2
DET.AMB_N: J11.9 (D0-INT~)
DET.DISP_N: J11.13 (D4-INT~)
EN.V3P3_I2C: R219.1
EN.VDD_AMP: R220.1
GND: C101.2, J11.25 (GND), R210.1, R224.1, R226.1, R227.2, SW1.1
GND_LED_OR: D20.4 (K2), R210.2
I2C_ONBOARD.SCL: J11.21 (D12-I2C_SCL~)
I2C_ONBOARD.SDA: J11.20 (D11-I2C_SDA)
I2S.BCLK: R215.2
I2S.DAMP: R217.2
I2S.LRCLK: R216.2
I2S_BCLK_MCU: J11.11 (D2-I2S_CLK~), R215.1
I2S_DAMP_MCU: J11.8 (A6-I2S_DATA), R217.1
I2S_LRCLK_MCU: J11.12 (D3-I2S_WS~), R216.1
INT_IO_N: J11.16 (D7-INT~)
MCU_AREF: J11.1 (AREF), TP45.1
MCU_BT_CONF0: J11.6 (A4/D19~), R221.2
MCU_BT_CONF1: J11.7 (A5), R222.1
MCU_EN_V3P3_I2C: J11.2 (A0/DAC0/D15), R219.2
MCU_EN_VDD_AMP: J11.5 (A3/D18~), R220.2
MCU_LED: D20.2 (A2), D20.3 (K1), J11.10 (D1~)
RST.AMP_N: R213.2
RST.AMP_PDN_N: R214.2
RST.BT_N: R212.2
RST.RTC_N: R211.2
RST_IO_N: J11.14 (D5-INT~)
RST_MCU_AMP_N: J11.18 (D9-SPI_CLK-INT), R213.1
RST_MCU_AMP_PDN_N: J11.19 (D10-SPI_HICO~), R214.1
RST_MCU_BT_N: J11.17 (D8-SPI_HOCI-INT~), R212.1
RST_MCU_RTC_N: J11.15 (D6-LED/INT~), R211.1
SYS_RST_MCU: J11.24 (RESET_N), SW1.2
UART.HICO: J11.22 (D13/UART_RX)
UART.HOCI: J11.23 (D14/UART_TX)
V3P3: C101.1, D21.2 (A), J11.26 (V3P3), R218.2, TP47.1, TP48.1
V3P3_LED: D21.1 (K), R227.1
V3P3_LED_BL: D20.1 (A1), R218.1
V5P0: J11.27 (VIN_5V)
V5P0_OUT_DNI: J11.28 (V5P0), TP46.1
VDD_BT: R223.2, R225.2

Notes on the sheet:
Offboard: ATSAMW25-Wifi Module
${SHEETNAME}
