ruralguru/ClockRadio_Motherboard/MECH_GRAPHIC.kicad_sch

## KiCad design MECH_GRAPHIC.kicad_sch (2022-05-10)

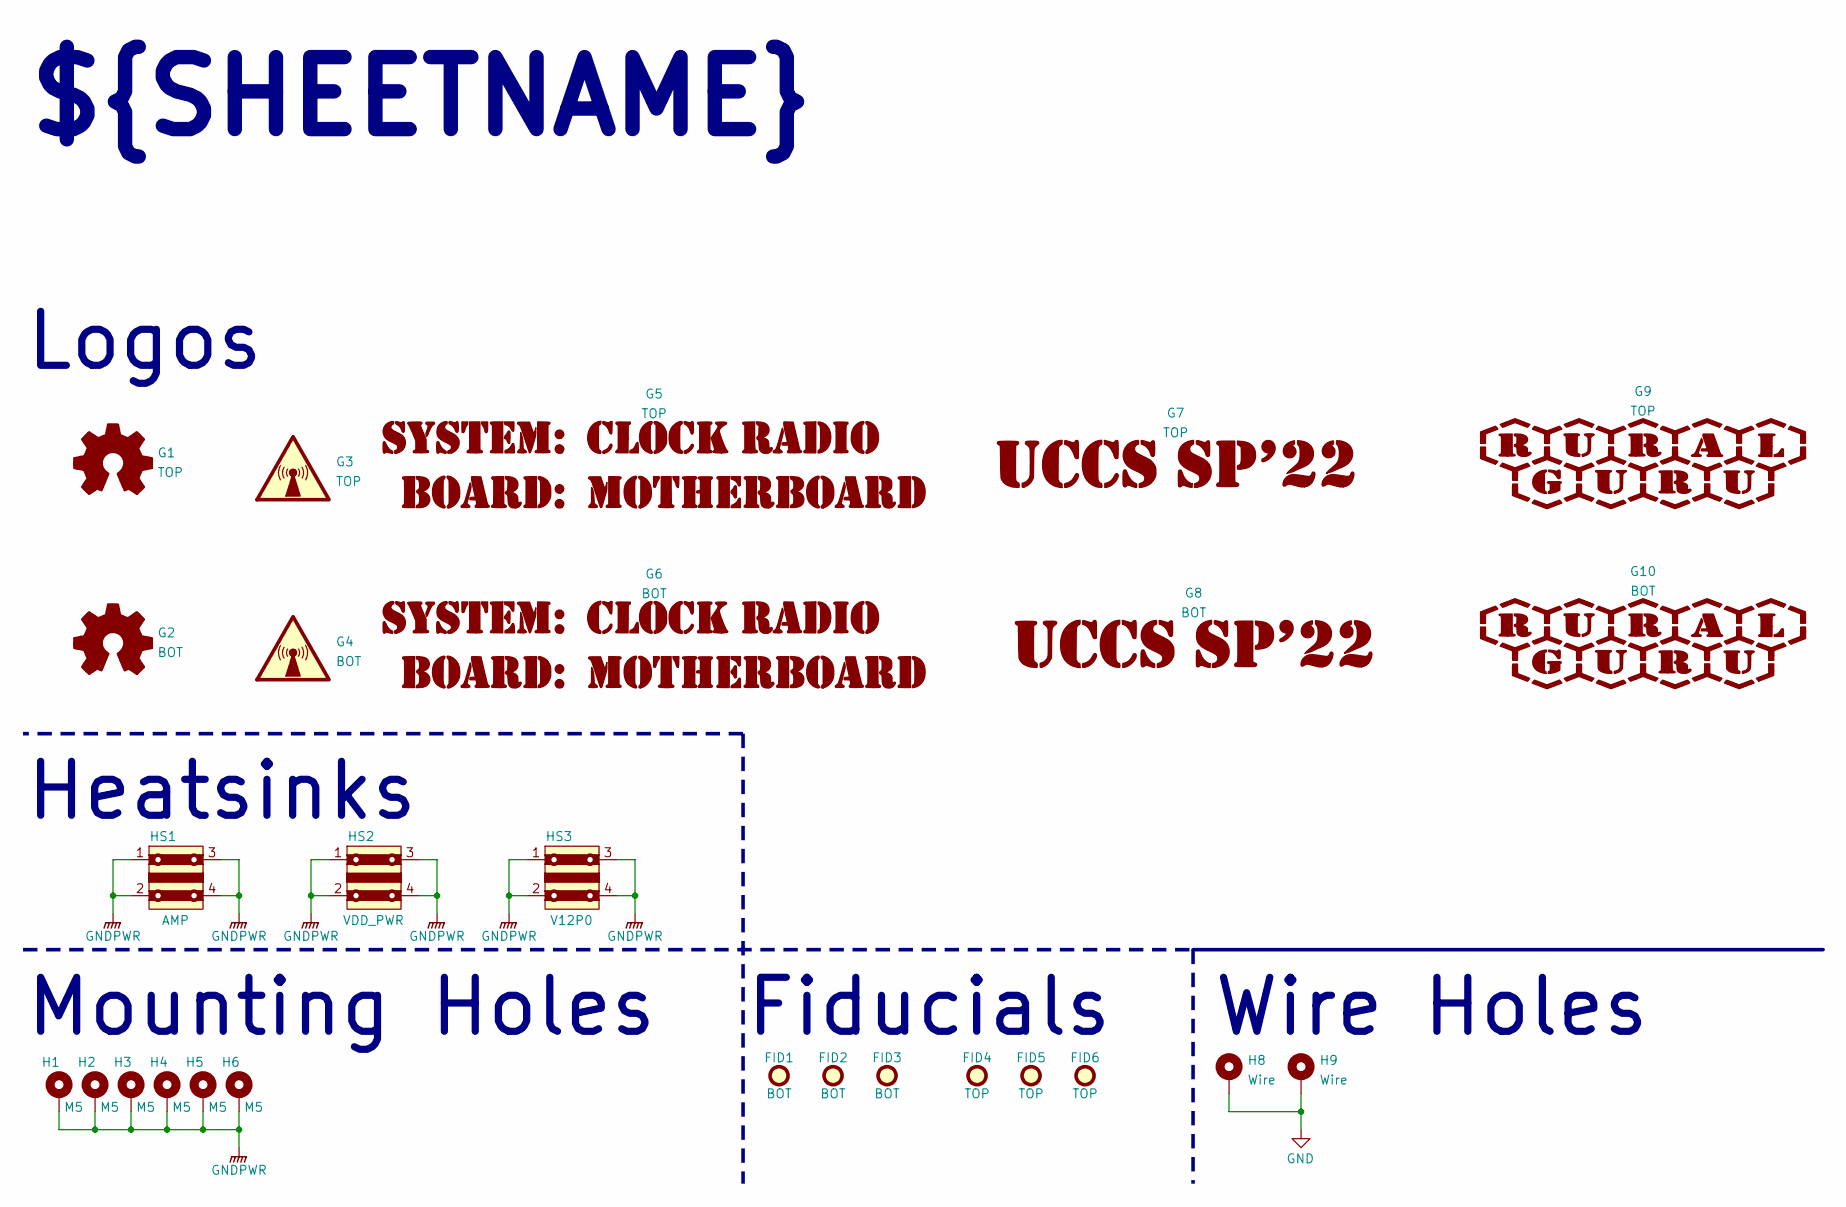
[picture p12: schematic MECH_GRAPHIC.kicad_sch]

Parts:
FID1, FID2, FID3: BOT; Fiducial_0.5mm_Mask1mm
FID4, FID5, FID6: TOP; Fiducial_0.5mm_Mask1mm
G1: TOP; OSHW-Symbol_8.9x8mm_SilkScreen
G2: BOT; OSHW-Symbol_8.9x8mm_SilkScreen
G3: TOP; RF_0p5
G4: BOT; RF_0p5
G5: TOP; ACR_Motherboard_2xp33
G6: BOT; ACR_Motherboard_2xp33
G7: TOP; UCCS_1
G8: BOT; UCCS_1
G9: TOP; RuralguruProjects_HEX_1500
G10: BOT; RuralguruProjects_HEX_1500
H1, H2, H3, H4, H5, H6: M5; MountingHole_5.3mm_M5_Pad_Via
H8, H9: Wire; MountingHole_2.2mm_M2_Pad
HS1: AMP; -; MPN LTN20069
HS2: VDD_PWR; -; MPN LTN20069
HS3: V12P0; -; MPN LTN20069

Connections:
GND: H8.1, H9.1
GNDPWR: H1.1, H2.1, H3.1, H4.1, H5.1, H6.1, HS1.1, HS1.2, HS1.3, HS1.4, HS2.1, HS2.2, HS2.3, HS2.4, HS3.1, HS3.2, HS3.3, HS3.4

Notes on the sheet:
${SHEETNAME}
Mounting Holes
Fiducials
Wire Holes
Heatsinks
Logos
