ruralguru/ClockRadio_Motherboard/Mic_Conn.kicad_sch

## KiCad design Mic_Conn.kicad_sch (2022-05-10)

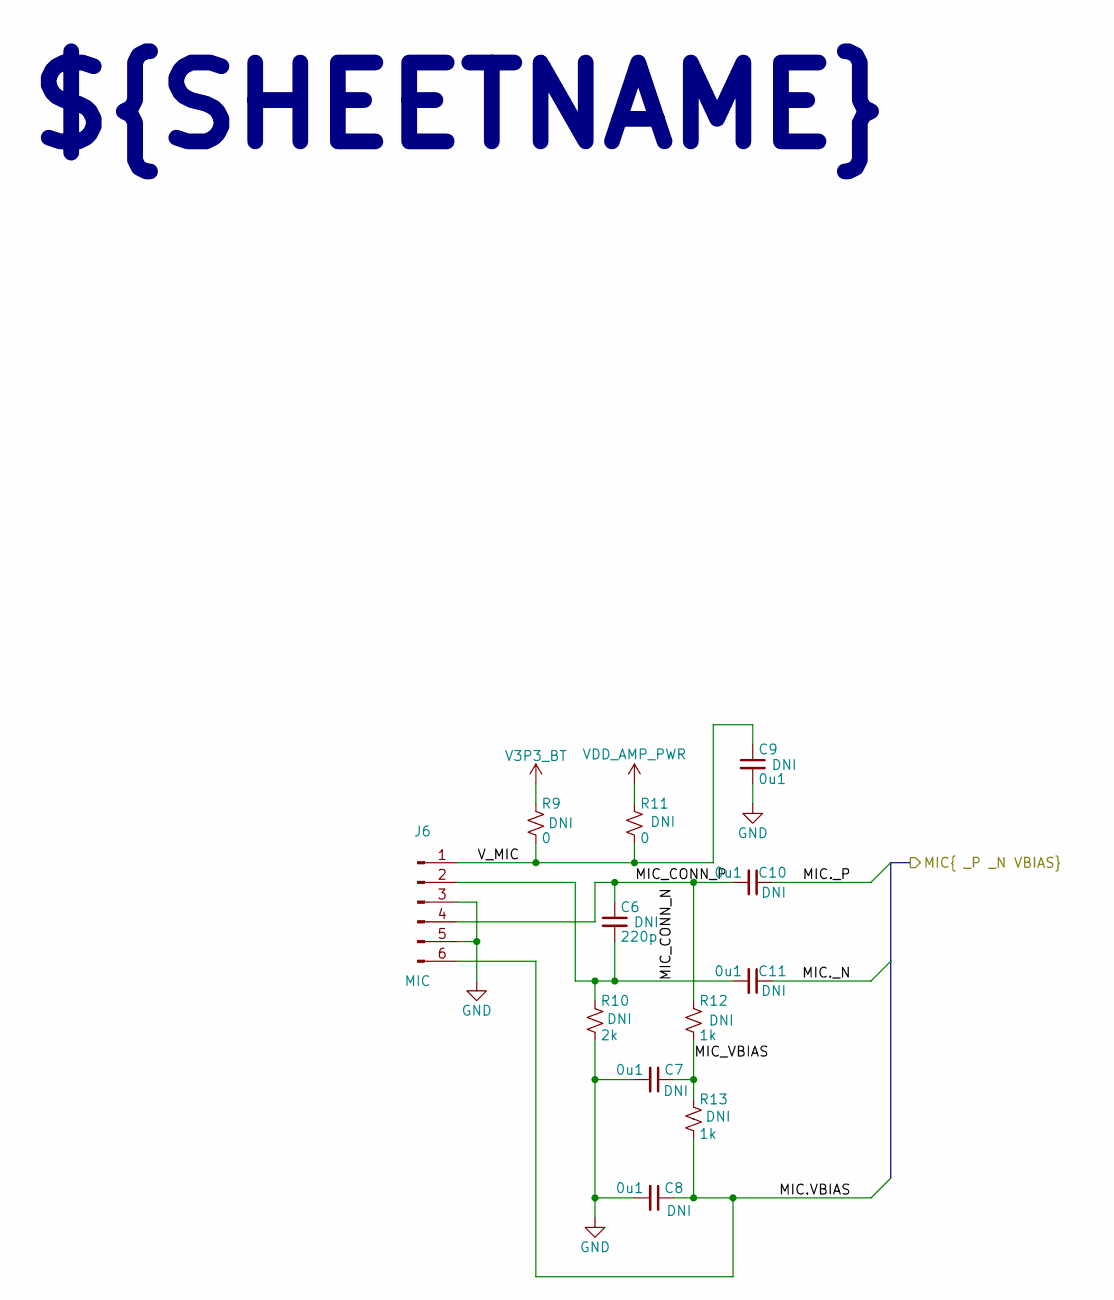
[picture p13: schematic Mic_Conn.kicad_sch]

Parts:
C6: 220p; C_0603_1608Metric_Pad1.08x0.95mm_HandSolder; MPN C0603C221K5RAC
C7, C8, C9, C10, C11: 0u1; C_0603_1608Metric_Pad1.08x0.95mm_HandSolder; MPN C0603C104J5RACTU
J6: MIC; PinHeader_2x03_P2.00mm_Vertical; MPN TMMH-103-01-T-D
R9, R11: 0; R_0603_1608Metric_Pad0.98x0.95mm_HandSolder; MPN RC0603FR-130RL
R10: 2k; R_0603_1608Metric_Pad0.98x0.95mm_HandSolder; MPN RC0603FR-072KL
R12, R13: 1k; R_0603_1608Metric_Pad0.98x0.95mm_HandSolder; MPN AC0603FR-101KL

Connections:
GND: C7.2, C8.2, C9.2, J6.3, J6.5, R10.2
MIC.VBIAS: C8.1, J6.6, R13.2
MIC._N: C11.1
MIC._P: C10.1
MIC_CONN_N: C6.2, C11.2, J6.2, R10.1
MIC_CONN_P: C6.1, C10.2, J6.4, R12.1
MIC_VBIAS: C7.1, R12.2, R13.1
V3P3_BT: R9.1
VDD_AMP_PWR: R11.1
V_MIC: C9.1, J6.1, R9.2, R11.2

Notes on the sheet:
${SHEETNAME}
