ruralguru/ClockRadio_Motherboard/PWR_IN.kicad_sch

## KiCad design PWR_IN.kicad_sch (2022-05-10)

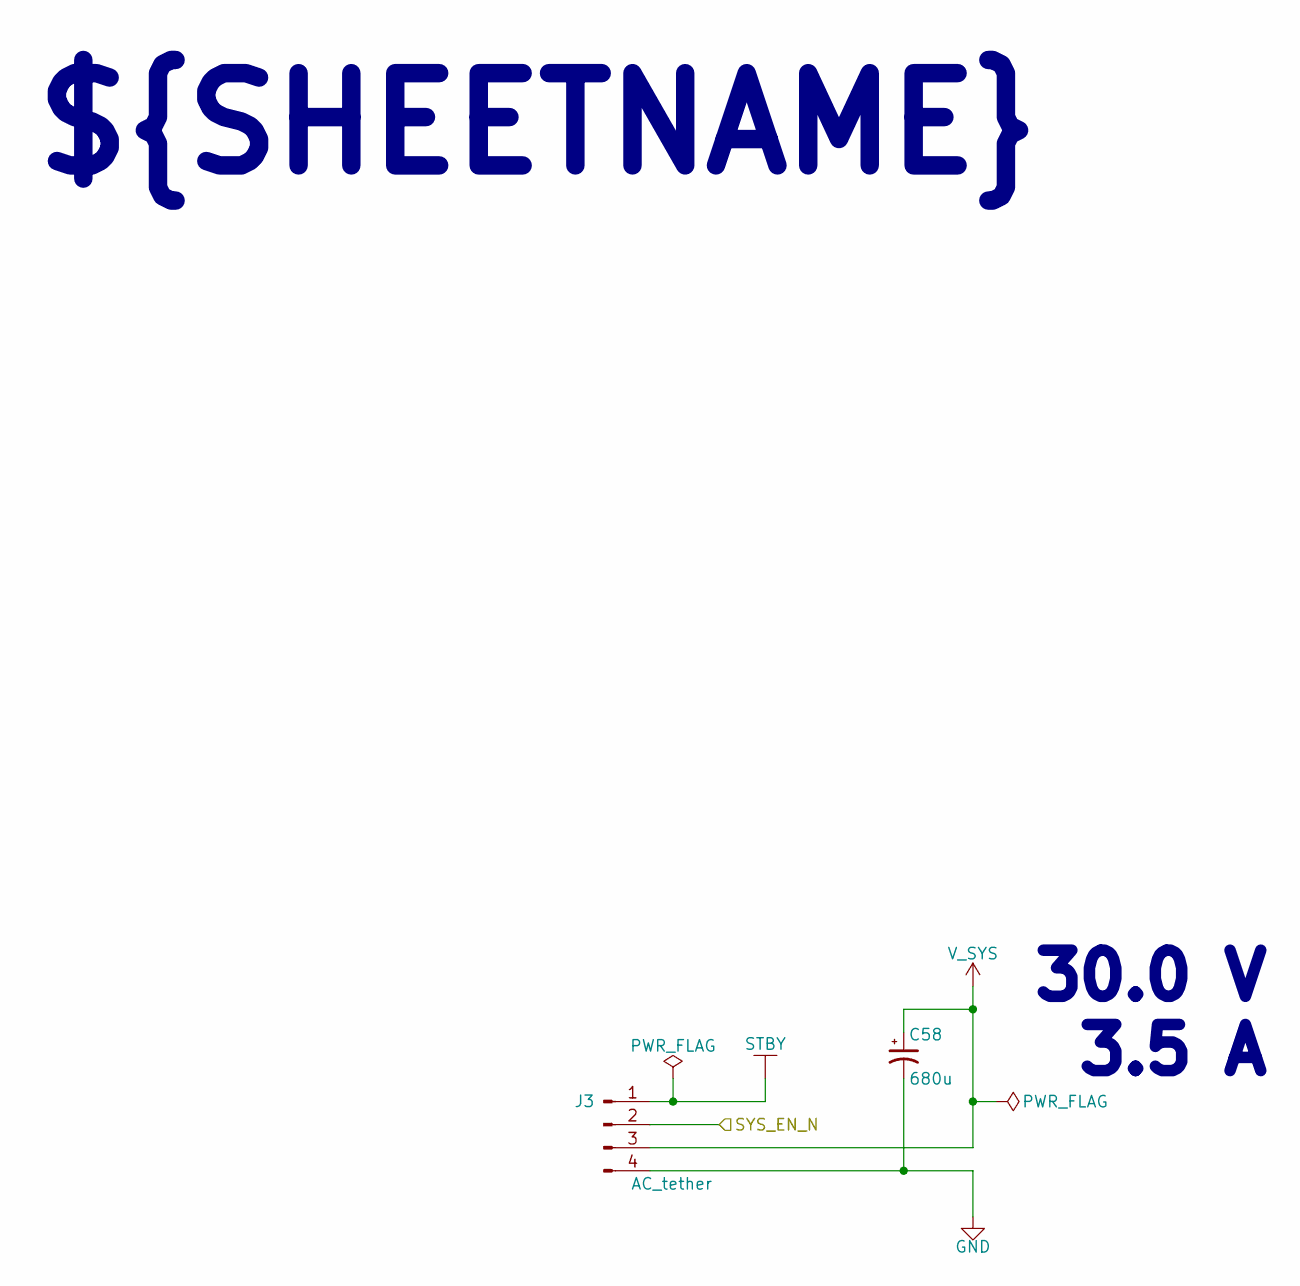
[picture p14: schematic PWR_IN.kicad_sch]

Parts:
C58: 680u; CP_Radial_D12.5mm_P5.00mm; MPN UPW1H681MHD
J3: AC_tether; UMPT-04-12.5-x-V-S-W-xR; MPN UMPT-04-12.5-L-V-S-W-TR

Connections:
GND: C58.2, J3.4
STBY: J3.1
SYS_EN_N: J3.2
V_SYS: C58.1, J3.3

Notes on the sheet:
${SHEETNAME}
30.0 V 3.5 A
