ruralguru/ClockRadio_Motherboard/Power_top.kicad_sch

## KiCad design Power_top.kicad_sch (2022-05-10)

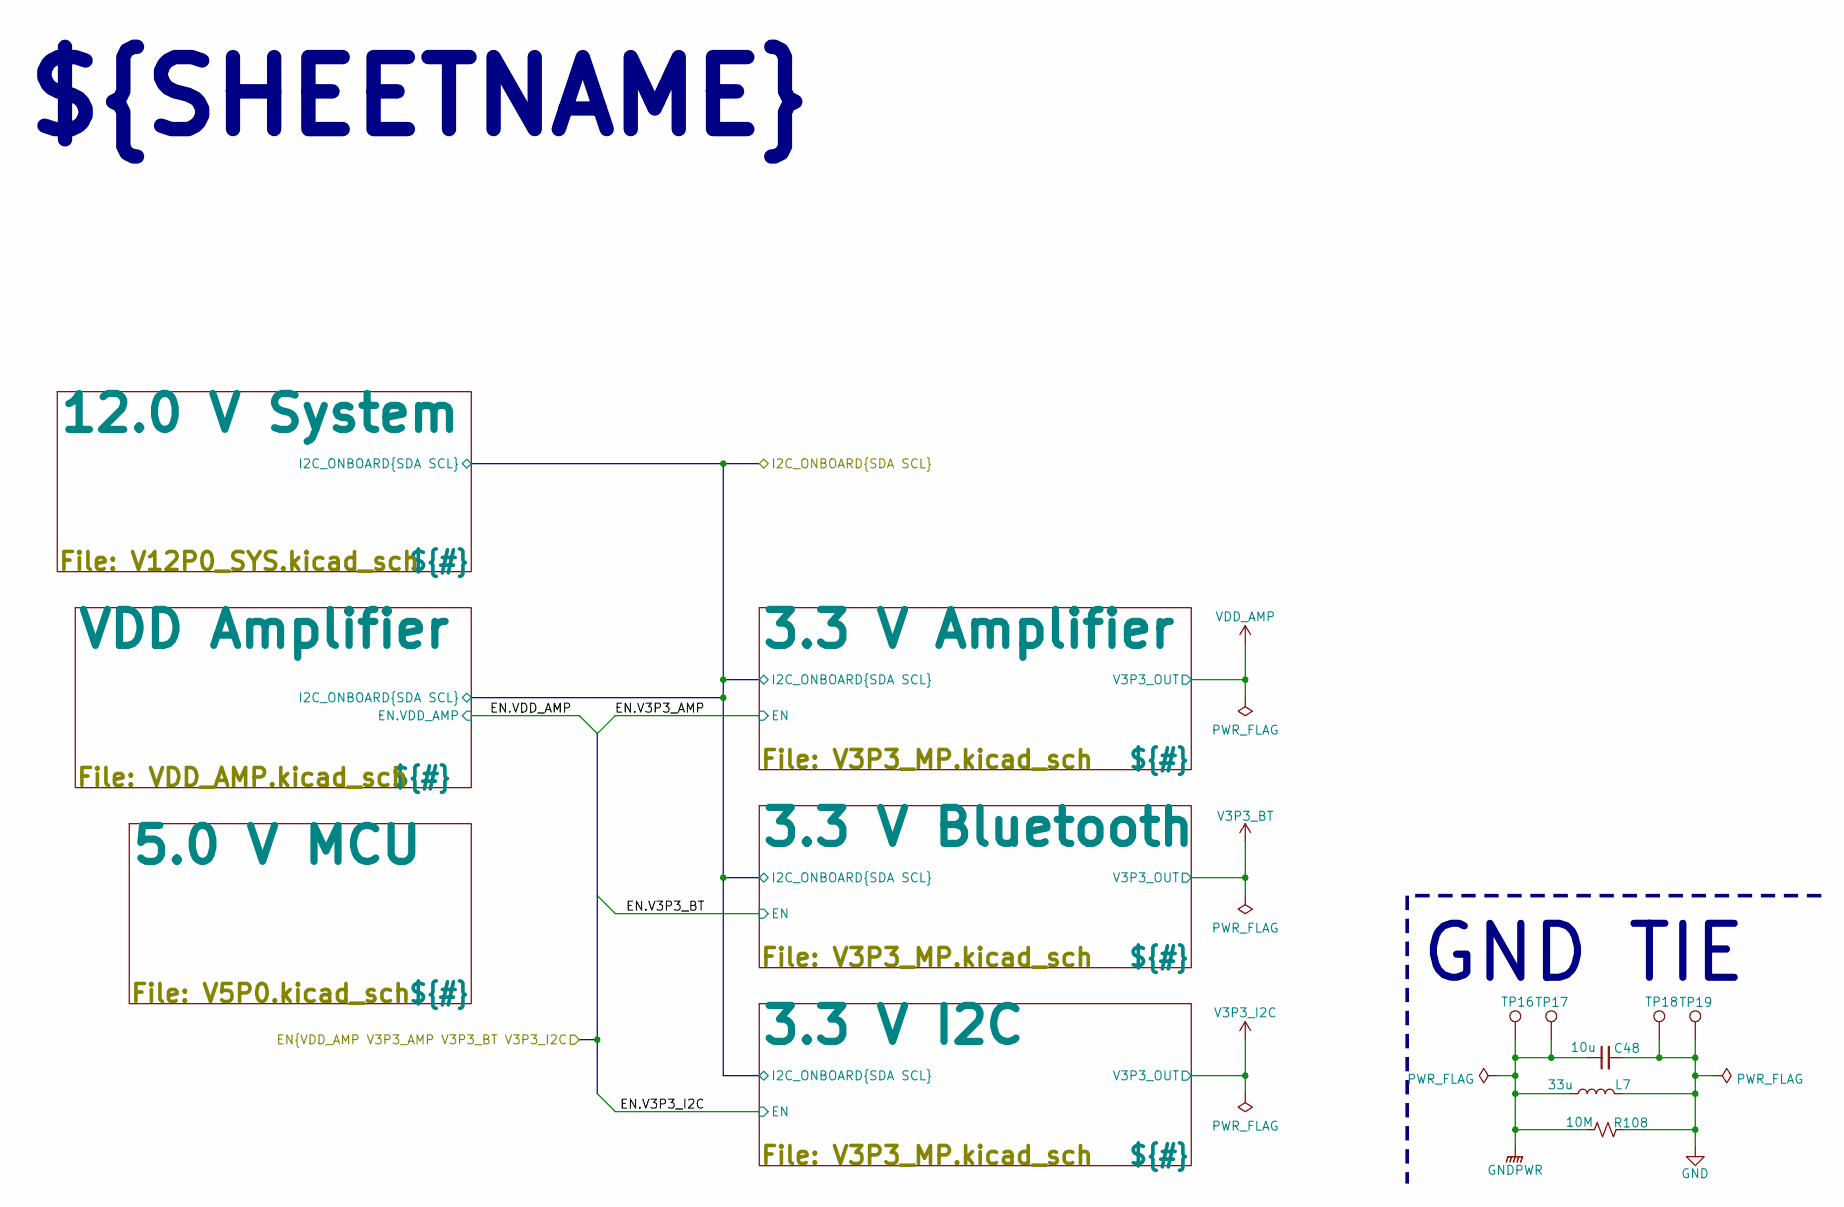
[picture p15: schematic Power_top.kicad_sch]

Parts:
C48: 10u; C_0805_2012Metric_Pad1.18x1.45mm_HandSolder; MPN EMK212BB7106KG-T
L7: 33u; L_Coilcraft_LPS5030; MPN LPS5030-333MRC
R108: 10M; R_0603_1608Metric_Pad0.98x0.95mm_HandSolder; MPN RC0603FR-1010ML
TP16, TP17, TP18, TP19: TestPoint; TestPoint_Pad_D2.0mm

Connections:
GND: C48.2, L7.2, R108.1, TP18.1, TP19.1
GNDPWR: C48.1, L7.1, R108.2, TP16.1, TP17.1

Notes on the sheet:
${SHEETNAME}
GND TIE
