ruralguru/ClockRadio_Motherboard/RTC.kicad_sch

## KiCad design RTC.kicad_sch (2022-05-10)

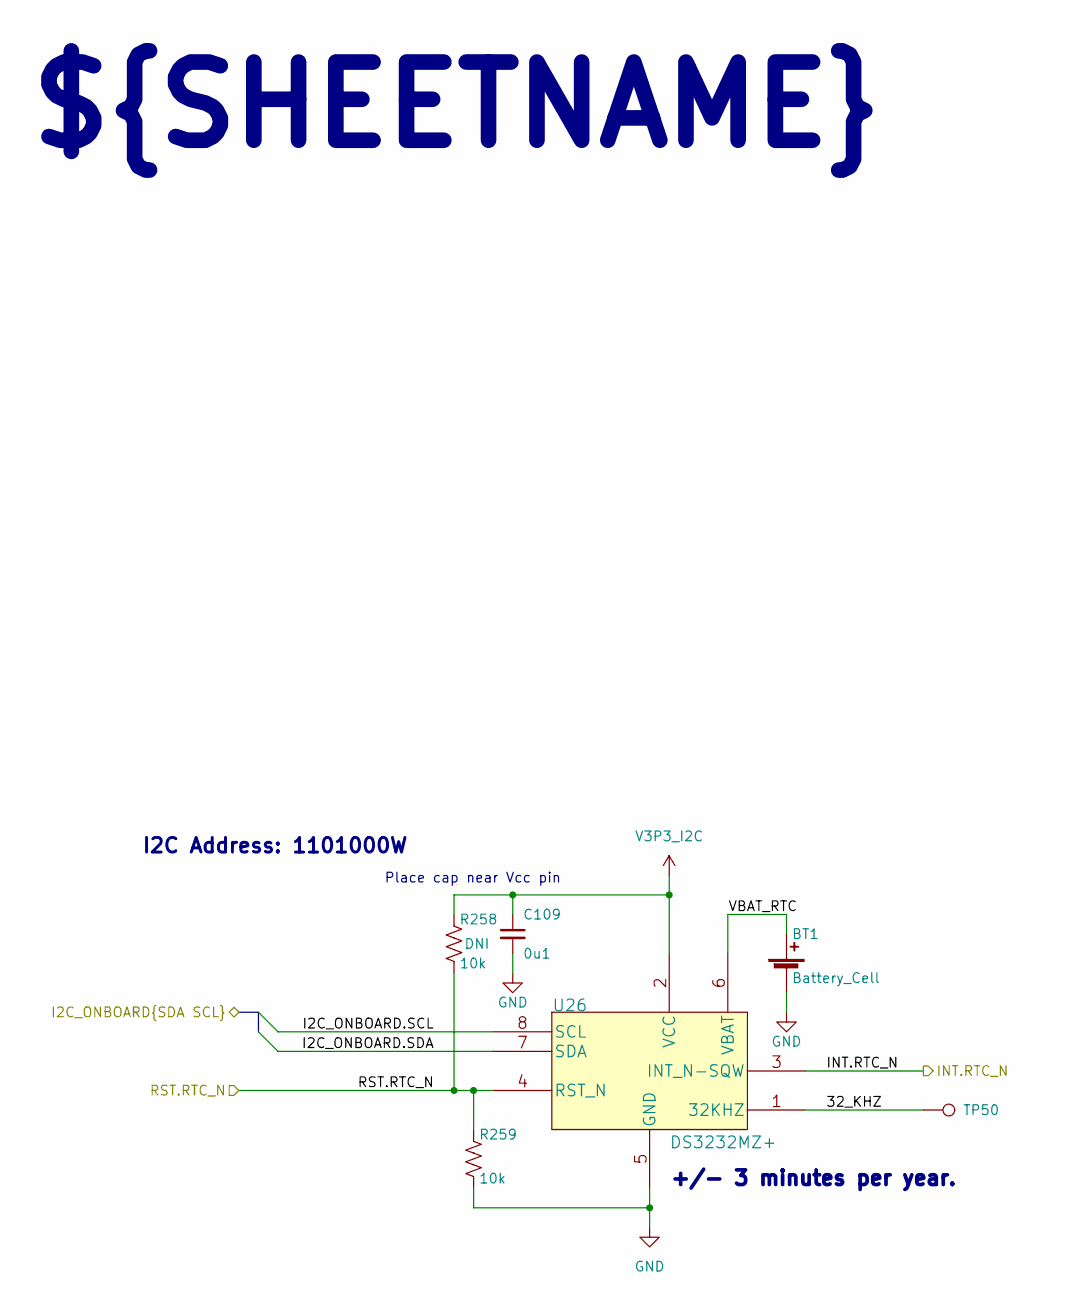
[picture p16: schematic RTC.kicad_sch]

Parts:
BT1: Battery_Cell; BatteryHolder_MPD_BC2003_1x2032; MPN BAT-HLD-001
C109: 0u1; C_0603_1608Metric_Pad1.08x0.95mm_HandSolder; MPN C0603C104J5RACTU
R258, R259: 10k; R_0603_1608Metric_Pad0.98x0.95mm_HandSolder; MPN AC0603FR-1310KL
TP50: TestPoint; TestPoint_Pad_D2.0mm
U26: DS3232MZ+; SO-8_3.9x4.9mm_P1.27mm; MPN DS3232MZ+

Connections:
32_KHZ: TP50.1, U26.1 (32KHZ)
GND: BT1.2 (-), C109.2, R259.1, U26.5 (GND)
I2C_ONBOARD.SCL: U26.8 (SCL)
I2C_ONBOARD.SDA: U26.7 (SDA)
INT.RTC_N: U26.3 (INT_N-SQW)
RST.RTC_N: R258.1, R259.2, U26.4 (RST_N)
V3P3_I2C: C109.1, R258.2, U26.2 (VCC)
VBAT_RTC: BT1.1 (+), U26.6 (VBAT)

Notes on the sheet:
${SHEETNAME}
Place cap near Vcc pin
+/- 3 minutes per year.
I2C Address: 1101000W
