ruralguru/ClockRadio_Motherboard/Tsns.kicad_sch

## KiCad design Tsns.kicad_sch (2022-05-10)

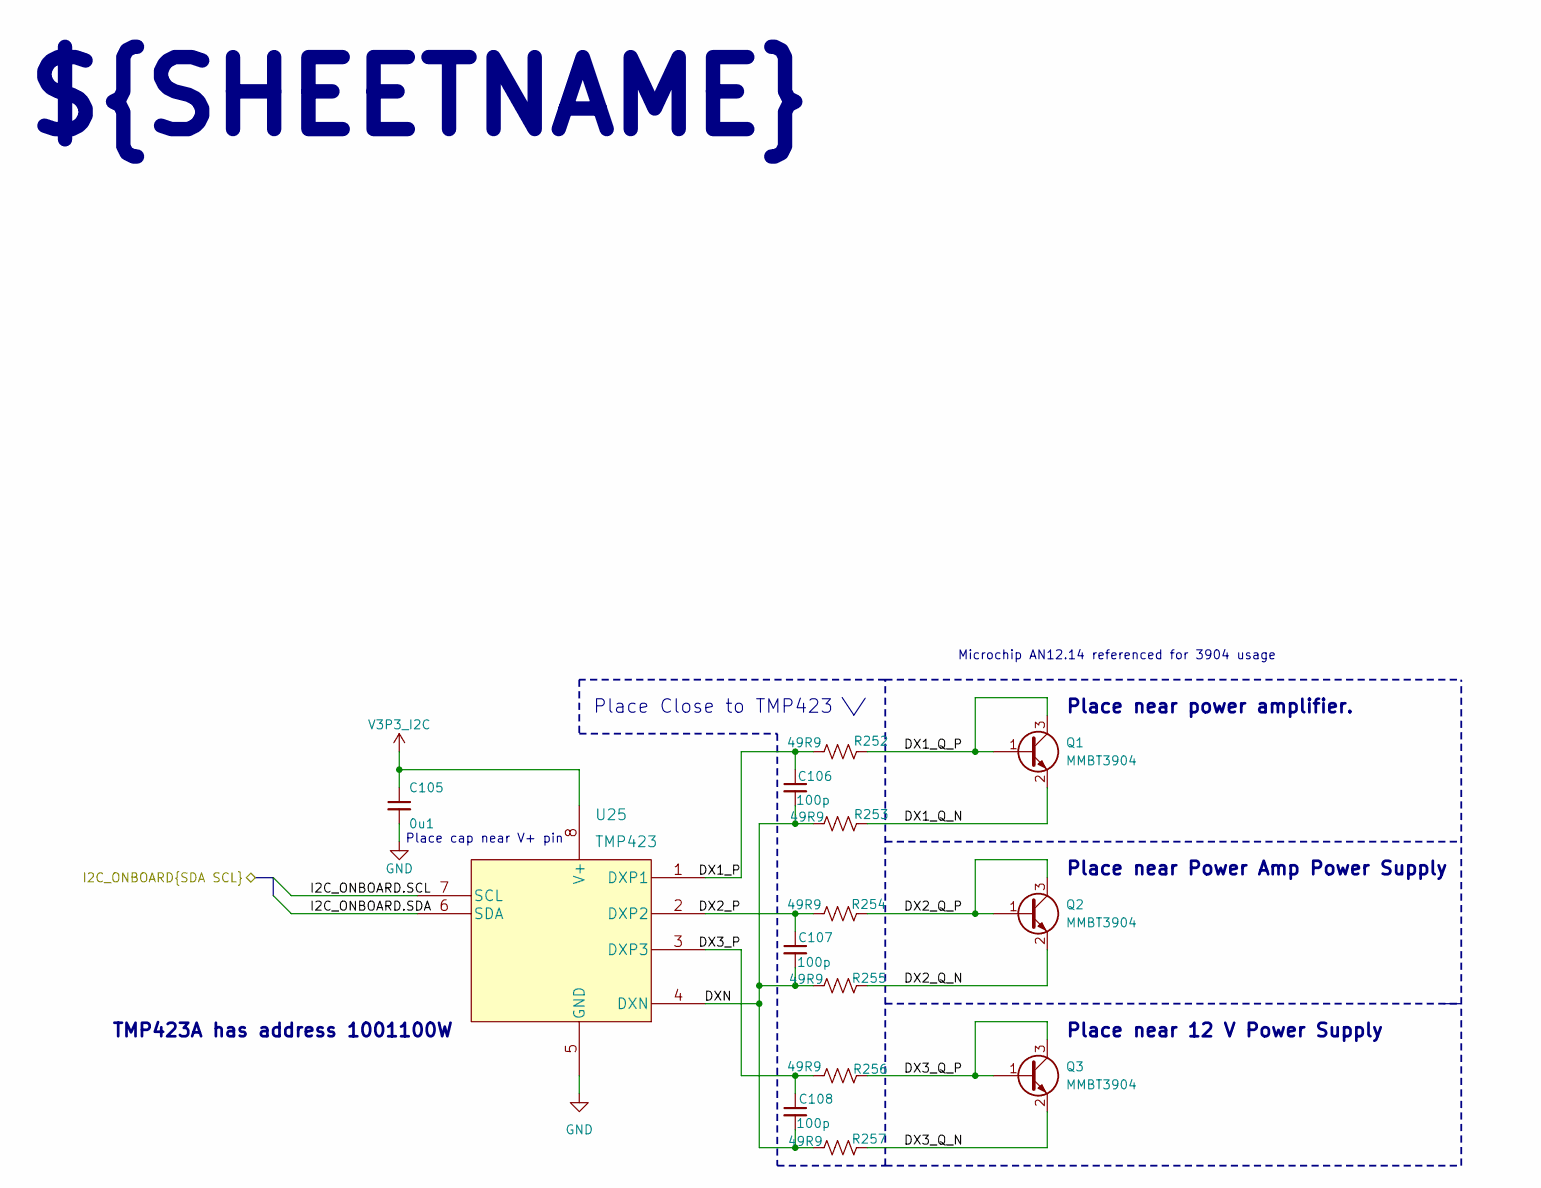
[picture p17: schematic Tsns.kicad_sch]

Parts:
C105: 0u1; C_0603_1608Metric_Pad1.08x0.95mm_HandSolder; MPN C0603C104J5RACTU
C106, C107, C108: 100p; C_0603_1608Metric_Pad1.08x0.95mm_HandSolder; MPN CC0603JRNPO7BN101
Q1, Q2, Q3: MMBT3904; DFN-3; MPN MMBT3904LP-7B
R252, R253, R254, R255, R256, R257: 49R9; R_0603_1608Metric_Pad0.98x0.95mm_HandSolder; MPN RT0603DRE0749R9L
U25: TMP423; SO-8_3x3mm_P0.65mm; MPN TMP423AQDCNTQ1

Connections:
DX1_P: C106.1, R252.1, U25.1 (DXP1)
DX1_Q_N: Q1.2 (E), R253.2
DX1_Q_P: Q1.1 (B), Q1.3 (C), R252.2
DX2_P: C107.1, R254.1, U25.2 (DXP2)
DX2_Q_N: Q2.2 (E), R255.2
DX2_Q_P: Q2.1 (B), Q2.3 (C), R254.2
DX3_P: C108.1, R256.1, U25.3 (DXP3)
DX3_Q_N: Q3.2 (E), R257.2
DX3_Q_P: Q3.1 (B), Q3.3 (C), R256.2
DXN: C106.2, C107.2, C108.2, R253.1, R255.1, R257.1, U25.4 (DXN)
GND: C105.2, U25.5 (GND)
I2C_ONBOARD.SCL: U25.7 (SCL)
I2C_ONBOARD.SDA: U25.6 (SDA)
V3P3_I2C: C105.1, U25.8 (V+)

Notes on the sheet:
Place cap near V+ pin
${SHEETNAME}
Place near 12 V Power Supply
Place near Power Amp Power Supply
Microchip AN12.14 referenced for 3904 usage
TMP423A has address 1001100W
Place near power amplifier.
Place Close to TMP423 \/
