ruralguru/ClockRadio_Motherboard/V3P3_LP.kicad_sch

## KiCad design V3P3_LP.kicad_sch (2022-05-10)

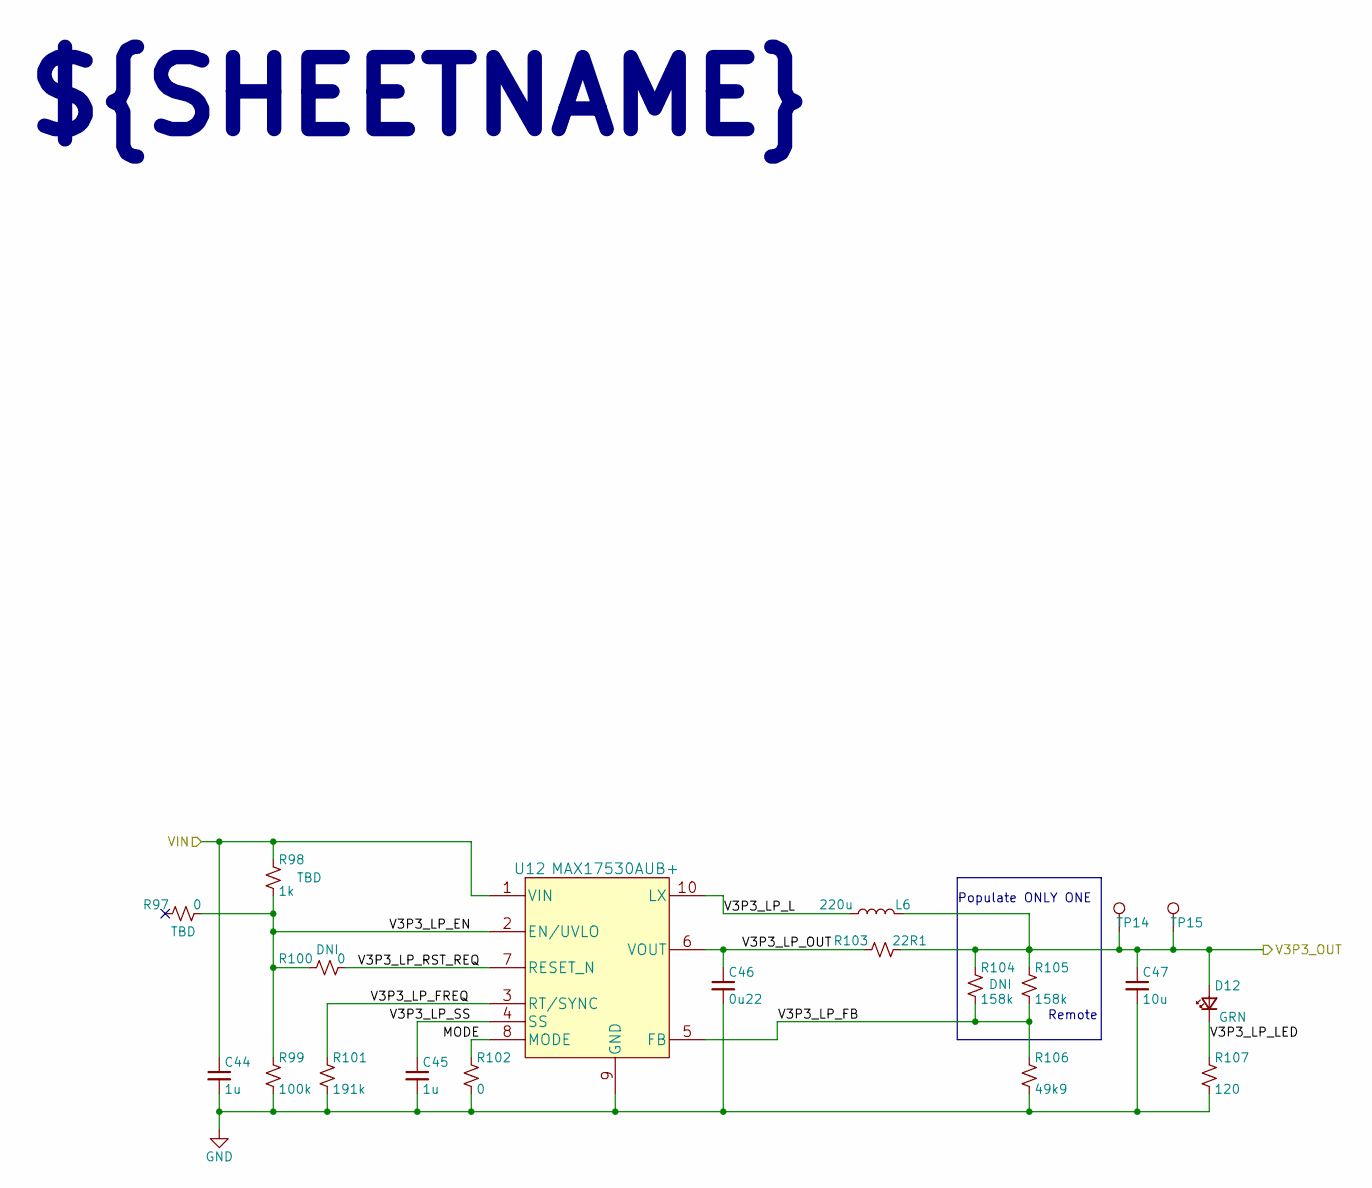
[picture p18: schematic V3P3_LP.kicad_sch]

Parts:
C44, C45: 1u; C_0805_2012Metric_Pad1.18x1.45mm_HandSolder; MPN CL21B105KBFNFNE
C46: 0u22; C_0603_1608Metric_Pad1.08x0.95mm_HandSolder; MPN CL10B224KO8NFNC
C47: 10u; C_0805_2012Metric_Pad1.18x1.45mm_HandSolder; MPN EMK212BB7106KG-T
D12: GRN; LED_0603_1608Metric_Pad1.05x0.95mm_HandSolder; MPN 150060VS55040
L6: 220u; L_Coilcraft_LPS3314; MPN LPS3314-224MRC
R97, R100, R102: 0; R_0603_1608Metric_Pad0.98x0.95mm_HandSolder; MPN RC0603FR-130RL
R98: 1k; R_0603_1608Metric_Pad0.98x0.95mm_HandSolder; MPN AC0603FR-101KL
R99: 100k; R_0603_1608Metric_Pad0.98x0.95mm_HandSolder; MPN RC0603FR-10100KL
R101: 191k; R_0603_1608Metric_Pad0.98x0.95mm_HandSolder; MPN AC0603FR-07191KL
R103: 22R1; R_0603_1608Metric_Pad0.98x0.95mm_HandSolder; MPN RC0603FR-0722R1L
R104, R105: 158k; R_0603_1608Metric_Pad0.98x0.95mm_HandSolder; MPN AC0603FR-07158KL
R106: 49k9; R_0603_1608Metric_Pad0.98x0.95mm_HandSolder; MPN CRCW060349K9FKEB
R107: 120; R_0603_1608Metric_Pad0.98x0.95mm_HandSolder; MPN RC0603FR-10120RL
TP14, TP15: TestPoint; TestPoint_Pad_D2.0mm
U12: MAX17530AUB+; uMAX; MPN MAX17530AUB+

Connections:
GND: C44.2, C45.2, C46.2, C47.2, R99.2, R101.2, R102.2, R106.2, R107.2, U12.9 (GND)
MODE: R102.1, U12.8 (MODE)
V3P3_LP_EN: R97.2, R98.2, R99.1, R100.1, U12.2 (EN/UVLO)
V3P3_LP_FB: R104.2, R105.2, R106.1, U12.5 (FB)
V3P3_LP_FREQ: R101.1, U12.3 (RT/SYNC)
V3P3_LP_L: L6.1, U12.10 (LX)
V3P3_LP_LED: D12.1 (K), R107.1
V3P3_LP_OUT: C46.1, R103.1, U12.6 (VOUT)
V3P3_LP_RST_REQ: R100.2, U12.7 (RESET_N)
V3P3_LP_SS: C45.1, U12.4 (SS)
V3P3_OUT: C47.1, D12.2 (A), L6.2, R103.2, R104.1, R105.1, TP14.1, TP15.1
VIN: C44.1, R98.1, U12.1 (VIN)

Notes on the sheet:
${SHEETNAME}
Populate ONLY ONE
Remote
