ruralguru/ClockRadio_Motherboard/V3P3_MP.kicad_sch

## KiCad design V3P3_MP.kicad_sch (2022-05-10)

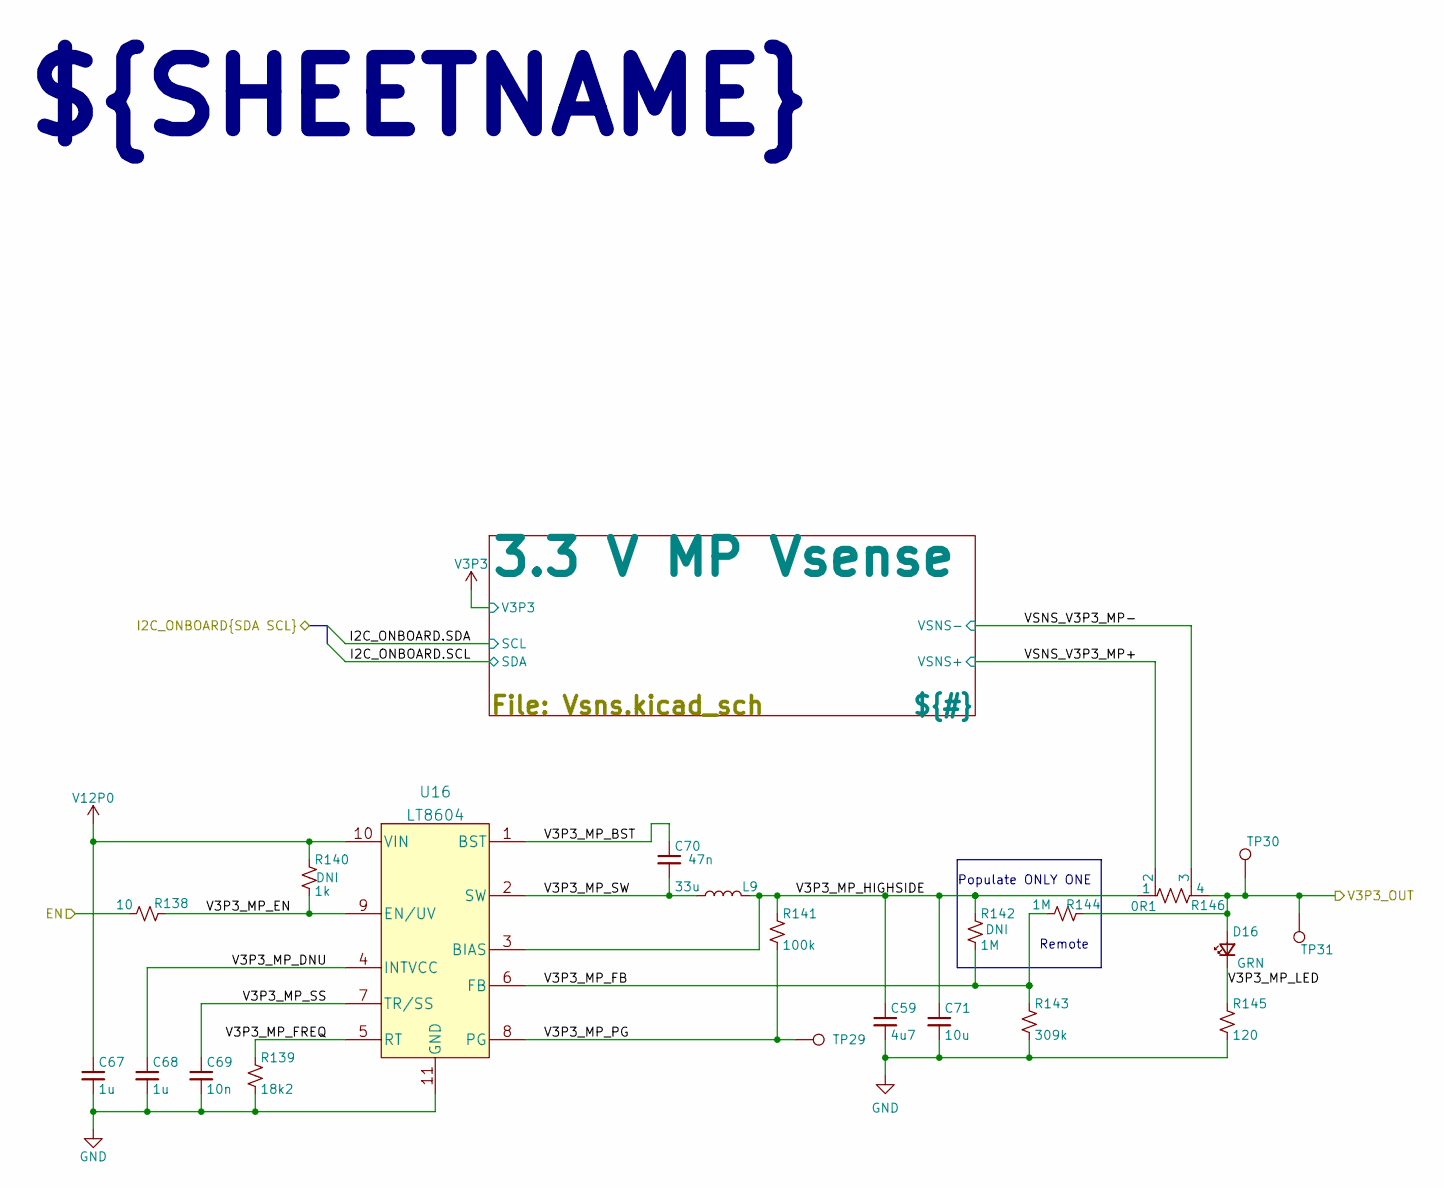
[picture p19: schematic V3P3_MP.kicad_sch]

Parts:
C59: 4u7; C_1206_3216Metric_Pad1.33x1.80mm_HandSolder; MPN CL31B475KBHNFNE
C67, C68: 1u; C_0805_2012Metric_Pad1.18x1.45mm_HandSolder; MPN CL21B105KBFNFNE
C69: 10n; C_0603_1608Metric_Pad1.08x0.95mm_HandSolder; MPN CC0603KRX7R8BB103
C70: 47n; C_0603_1608Metric_Pad1.08x0.95mm_HandSolder; MPN CL10B473KB8NNNL
C71: 10u; C_0805_2012Metric_Pad1.18x1.45mm_HandSolder; MPN EMK212BB7106KG-T
D16: GRN; LED_0603_1608Metric_Pad1.05x0.95mm_HandSolder; MPN 150060VS55040
L9: 33u; L_Coilcraft_LPS5030; MPN LPS5030-333MRC
R138: 10; R_0603_1608Metric_Pad0.98x0.95mm_HandSolder; MPN CR0603-FX-10R0ELF
R139: 18k2; R_0603_1608Metric_Pad0.98x0.95mm_HandSolder; MPN AC0603FR-134K99L
R140: 1k; R_0603_1608Metric_Pad0.98x0.95mm_HandSolder; MPN AC0603FR-101KL
R141: 100k; R_0603_1608Metric_Pad0.98x0.95mm_HandSolder; MPN RC0603FR-10100KL
R142, R144: 1M; R_0603_1608Metric_Pad0.98x0.95mm_HandSolder; MPN RC0603FR-101ML
R143: 309k; R_0603_1608Metric_Pad0.98x0.95mm_HandSolder; MPN RC0603FR-07309KL
R145: 120; R_0603_1608Metric_Pad0.98x0.95mm_HandSolder; MPN RC0603FR-10120RL
R146: 0R1; WSL3637
TP29, TP30, TP31: TestPoint; TestPoint_Pad_D2.0mm
U16: LT8604; DFN300x200x75; MPN LT8604EDDBM#TRPBF

Connections:
EN: R138.2
GND: C59.2, C67.2, C68.2, C69.2, C71.2, R139.2, R143.2, R145.2, U16.11 (GND)
V3P3_MP_BST: C70.1, U16.1 (BST)
V3P3_MP_DNU: C68.1, U16.4 (INTVCC)
V3P3_MP_EN: R138.1, R140.2, U16.9 (EN/UV)
V3P3_MP_FB: R142.2, R143.1, R144.2, U16.6 (FB)
V3P3_MP_FREQ: R139.1, U16.5 (RT)
V3P3_MP_HIGHSIDE: C59.1, C71.1, L9.2, R141.1, R142.1, R146.1, U16.3 (BIAS)
V3P3_MP_LED: D16.1 (K), R145.1
V3P3_MP_PG: R141.2, TP29.1, U16.8 (PG)
V3P3_MP_SS: C69.1, U16.7 (TR/SS)
V3P3_MP_SW: C70.2, L9.1, U16.2 (SW)
V3P3_OUT: D16.2 (A), R144.1, R146.4, TP30.1, TP31.1
V12P0: C67.1, R140.1, U16.10 (VIN)
VSNS_V3P3_MP+: R146.2
VSNS_V3P3_MP-: R146.3

Notes on the sheet:
${SHEETNAME}
Remote
Populate ONLY ONE
