ruralguru/ClockRadio_Motherboard/V5P0.kicad_sch

## KiCad design V5P0.kicad_sch (2022-05-10)

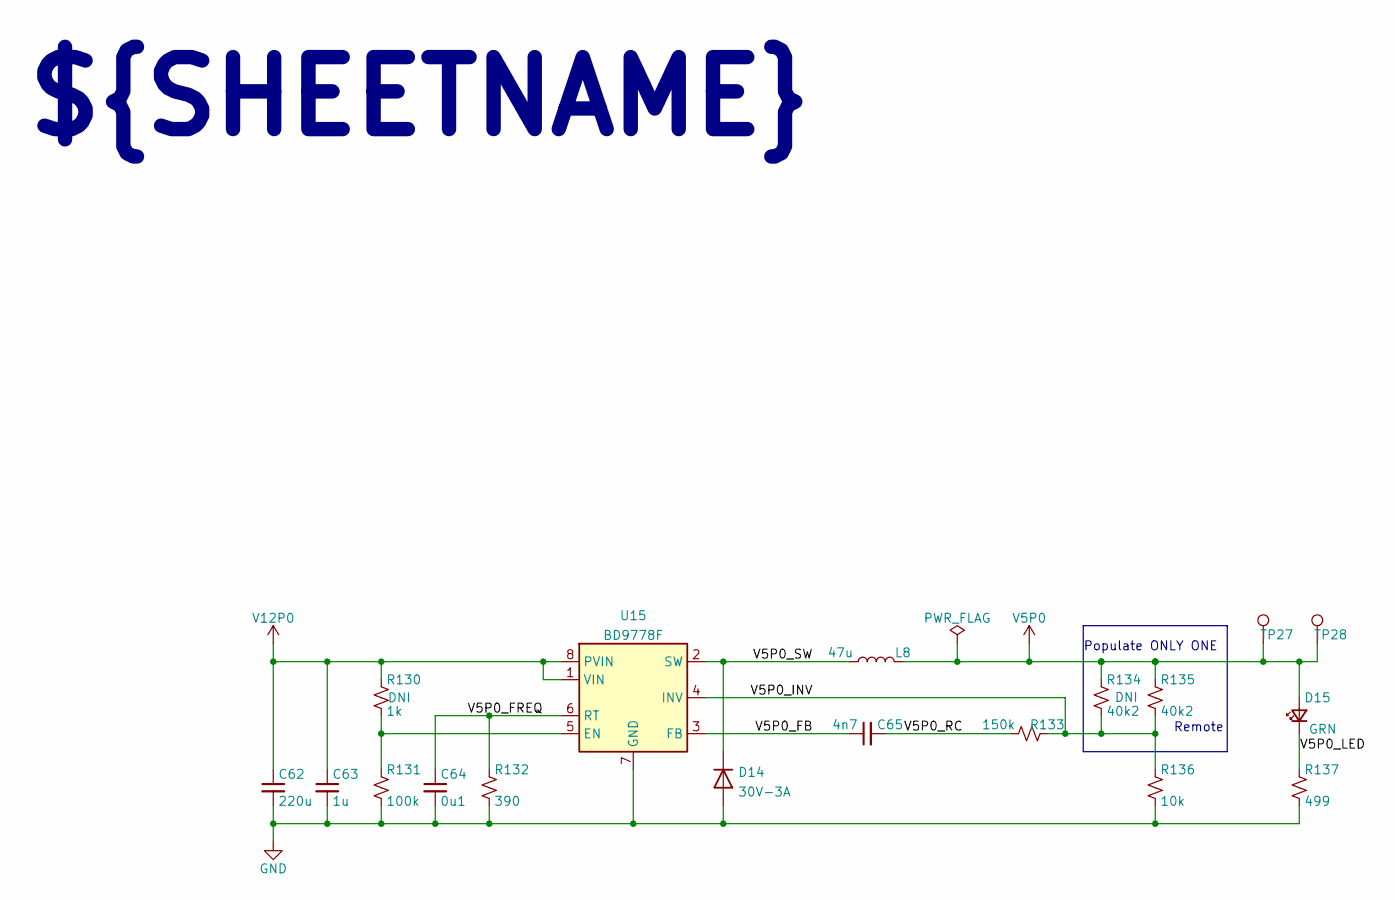
[picture p20: schematic V5P0.kicad_sch]

Parts:
C62: 220u; CP_Radial_D10.0mm_P5.00mm; MPN B41858C6227M
C63: 1u; C_0805_2012Metric_Pad1.18x1.45mm_HandSolder; MPN CL21B105KBFNFNE
C64: 0u1; C_0603_1608Metric_Pad1.08x0.95mm_HandSolder; MPN C0603C104J5RACTU
C65: 4n7; C_0603_1608Metric_Pad1.08x0.95mm_HandSolder; MPN CC0603KRX7R9BB472
D14: 30V-3A; D_TUMD2; MPN CUHS20S30,H3F
D15: GRN; LED_0603_1608Metric_Pad1.05x0.95mm_HandSolder; MPN 150060VS55040
L8: 47u; MSS1583-154KEB; MPN MSS1583-224KED
R130: 1k; R_0603_1608Metric_Pad0.98x0.95mm_HandSolder; MPN AC0603FR-101KL
R131: 100k; R_0603_1608Metric_Pad0.98x0.95mm_HandSolder; MPN RC0603FR-10100KL
R132: 390; R_0603_1608Metric_Pad0.98x0.95mm_HandSolder; MPN RT0603DRE07390RL
R133: 150k; R_0603_1608Metric_Pad0.98x0.95mm_HandSolder; MPN CRCW0603150KFKEAC
R134, R135: 40k2; R_0603_1608Metric_Pad0.98x0.95mm_HandSolder; MPN RT0603DRE0740K2L
R136: 10k; R_0603_1608Metric_Pad0.98x0.95mm_HandSolder; MPN AC0603FR-1310KL
R137: 499; R_0603_1608Metric_Pad0.98x0.95mm_HandSolder; MPN RT0603FRE07499RL
TP27, TP28: TestPoint; TestPoint_Pad_D2.0mm
U15: BD9778F; SSOP-8_3.9x5.05mm_P1.27mm; MPN BD9778F-E2

Connections:
GND: C62.2, C63.2, C64.2, D14.2 (A), R131.2, R132.2, R136.2, R137.2, U15.7 (GND)
unnamed: R130.2, R131.1, U15.5 (EN)
V5P0: D15.2 (A), L8.2, R134.1, R135.1, TP27.1, TP28.1
V5P0_FB: C65.1, U15.3 (FB)
V5P0_FREQ: C64.1, R132.1, U15.6 (RT)
V5P0_INV: R133.1, R134.2, R135.2, R136.1, U15.4 (INV)
V5P0_LED: D15.1 (K), R137.1
V5P0_RC: C65.2, R133.2
V5P0_SW: D14.1 (K), L8.1, U15.2 (SW)
V12P0: C62.1, C63.1, R130.1, U15.1 (VIN), U15.8 (PVIN)

Notes on the sheet:
${SHEETNAME}
Populate ONLY ONE
Remote
