ruralguru/ClockRadio_Motherboard/V6P0_conn.kicad_sch

## KiCad design V6P0_conn.kicad_sch (2022-05-10)

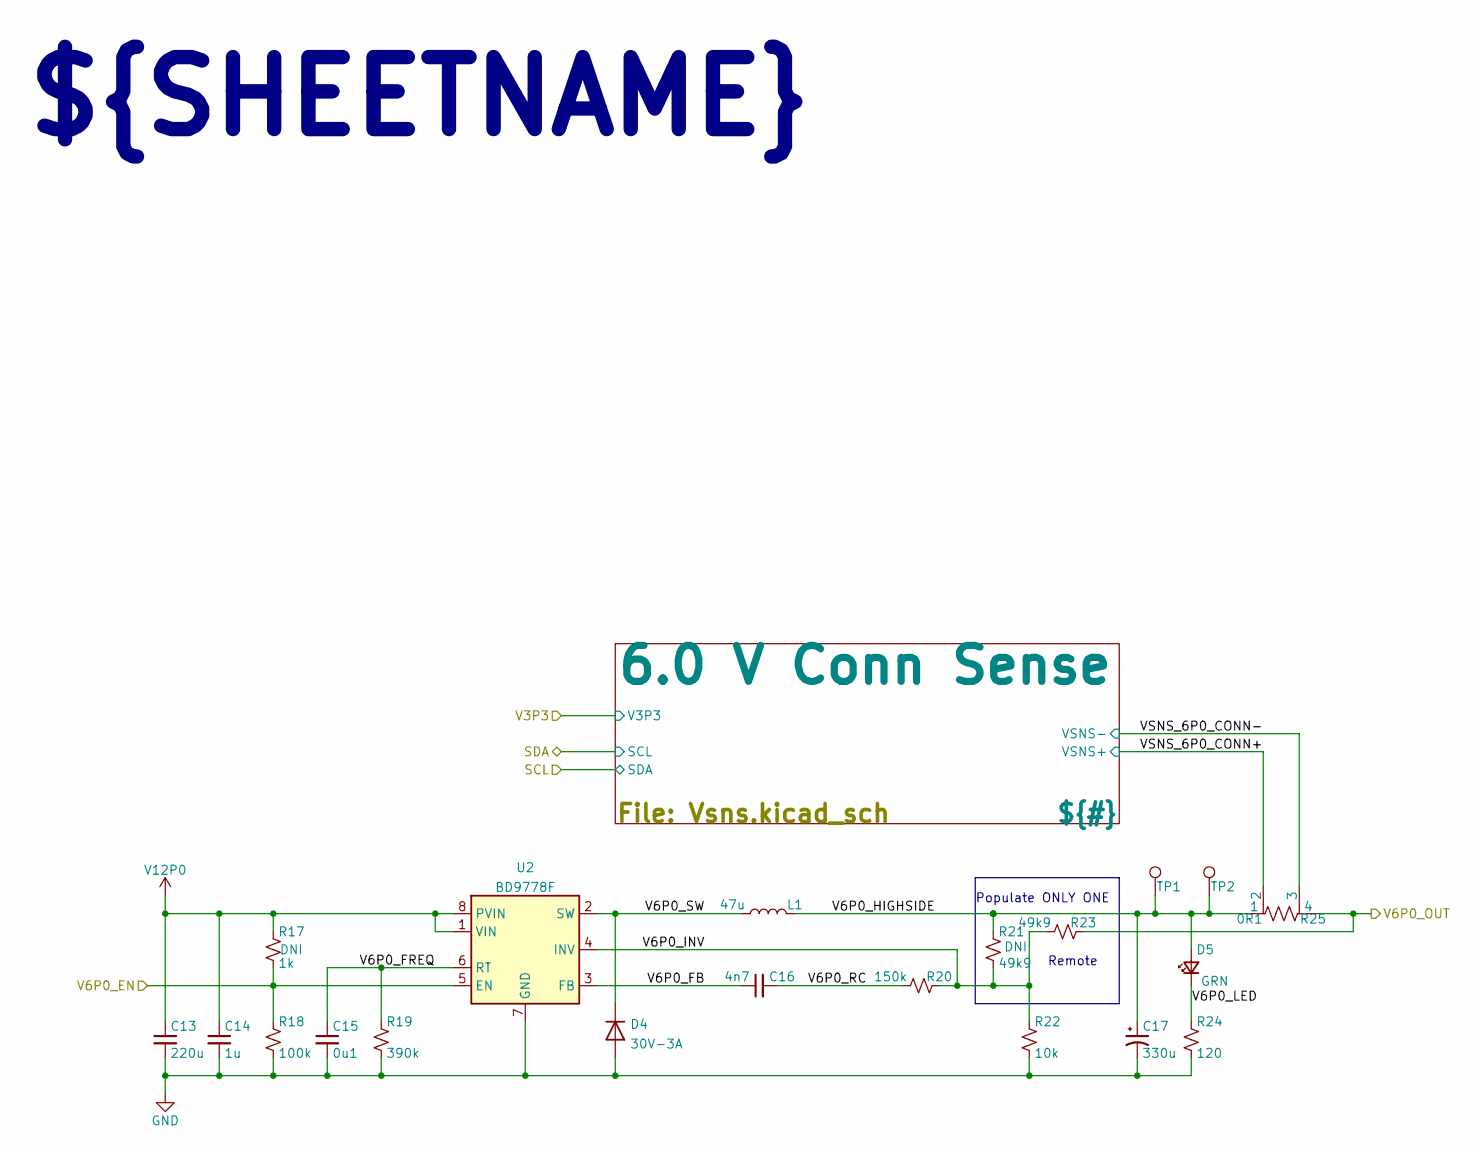
[picture p21: schematic V6P0_conn.kicad_sch]

Parts:
C13: 220u; CP_Radial_D10.0mm_P5.00mm; MPN B41858C6227M
C14: 1u; C_0805_2012Metric_Pad1.18x1.45mm_HandSolder; MPN CL21B105KBFNFNE
C15: 0u1; C_0603_1608Metric_Pad1.08x0.95mm_HandSolder; MPN C0603C104J5RACTU
C16: 4n7; C_0603_1608Metric_Pad1.08x0.95mm_HandSolder; MPN CC0603KRX7R9BB472
C17: 330u; CP_Radial_D10.0mm_P3.50mm; MPN UHE1E331MPD6
D4: 30V-3A; D_TUMD2; MPN CUHS20S30,H3F
D5: GRN; LED_0603_1608Metric_Pad1.05x0.95mm_HandSolder; MPN 150060VS55040
L1: 47u; MSS1583-154KEB; MPN MSS1583-224KED
R17: 1k; R_0603_1608Metric_Pad0.98x0.95mm_HandSolder; MPN AC0603FR-101KL
R18: 100k; R_0603_1608Metric_Pad0.98x0.95mm_HandSolder; MPN RC0603FR-10100KL
R19: 390k; R_0603_1608Metric_Pad0.98x0.95mm_HandSolder; MPN CRG0603F390K
R20: 150k; R_0603_1608Metric_Pad0.98x0.95mm_HandSolder; MPN CRCW0603150KFKEAC
R21, R23: 49k9; R_0603_1608Metric_Pad0.98x0.95mm_HandSolder; MPN CRCW060349K9FKEB
R22: 10k; R_0603_1608Metric_Pad0.98x0.95mm_HandSolder; MPN AC0603FR-1310KL
R24: 120; R_0603_1608Metric_Pad0.98x0.95mm_HandSolder; MPN RC0603FR-10120RL
R25: 0R1; WSL3637
TP1, TP2: TestPoint; TestPoint_Pad_D2.0mm
U2: BD9778F; SSOP-8_3.9x5.05mm_P1.27mm; MPN BD9778F-E2

Connections:
GND: C13.2, C14.2, C15.2, C17.2, D4.2 (A), R18.2, R19.2, R22.2, R24.2, U2.7 (GND)
V6P0_EN: R17.2, R18.1, U2.5 (EN)
V6P0_FB: C16.1, U2.3 (FB)
V6P0_FREQ: C15.1, R19.1, U2.6 (RT)
V6P0_HIGHSIDE: C17.1, D5.2 (A), L1.2, R21.1, R25.1, TP1.1, TP2.1
V6P0_INV: R20.1, R21.2, R22.1, R23.2, U2.4 (INV)
V6P0_LED: D5.1 (K), R24.1
V6P0_OUT: R23.1, R25.4
V6P0_RC: C16.2, R20.2
V6P0_SW: D4.1 (K), L1.1, U2.2 (SW)
V12P0: C13.1, C14.1, R17.1, U2.1 (VIN), U2.8 (PVIN)
VSNS_6P0_CONN+: R25.2
VSNS_6P0_CONN-: R25.3

Notes on the sheet:
${SHEETNAME}
Populate ONLY ONE
Remote
