ruralguru/ClockRadio_Motherboard/V12P0_SYS.kicad_sch

## KiCad design V12P0_SYS.kicad_sch (2022-05-10)

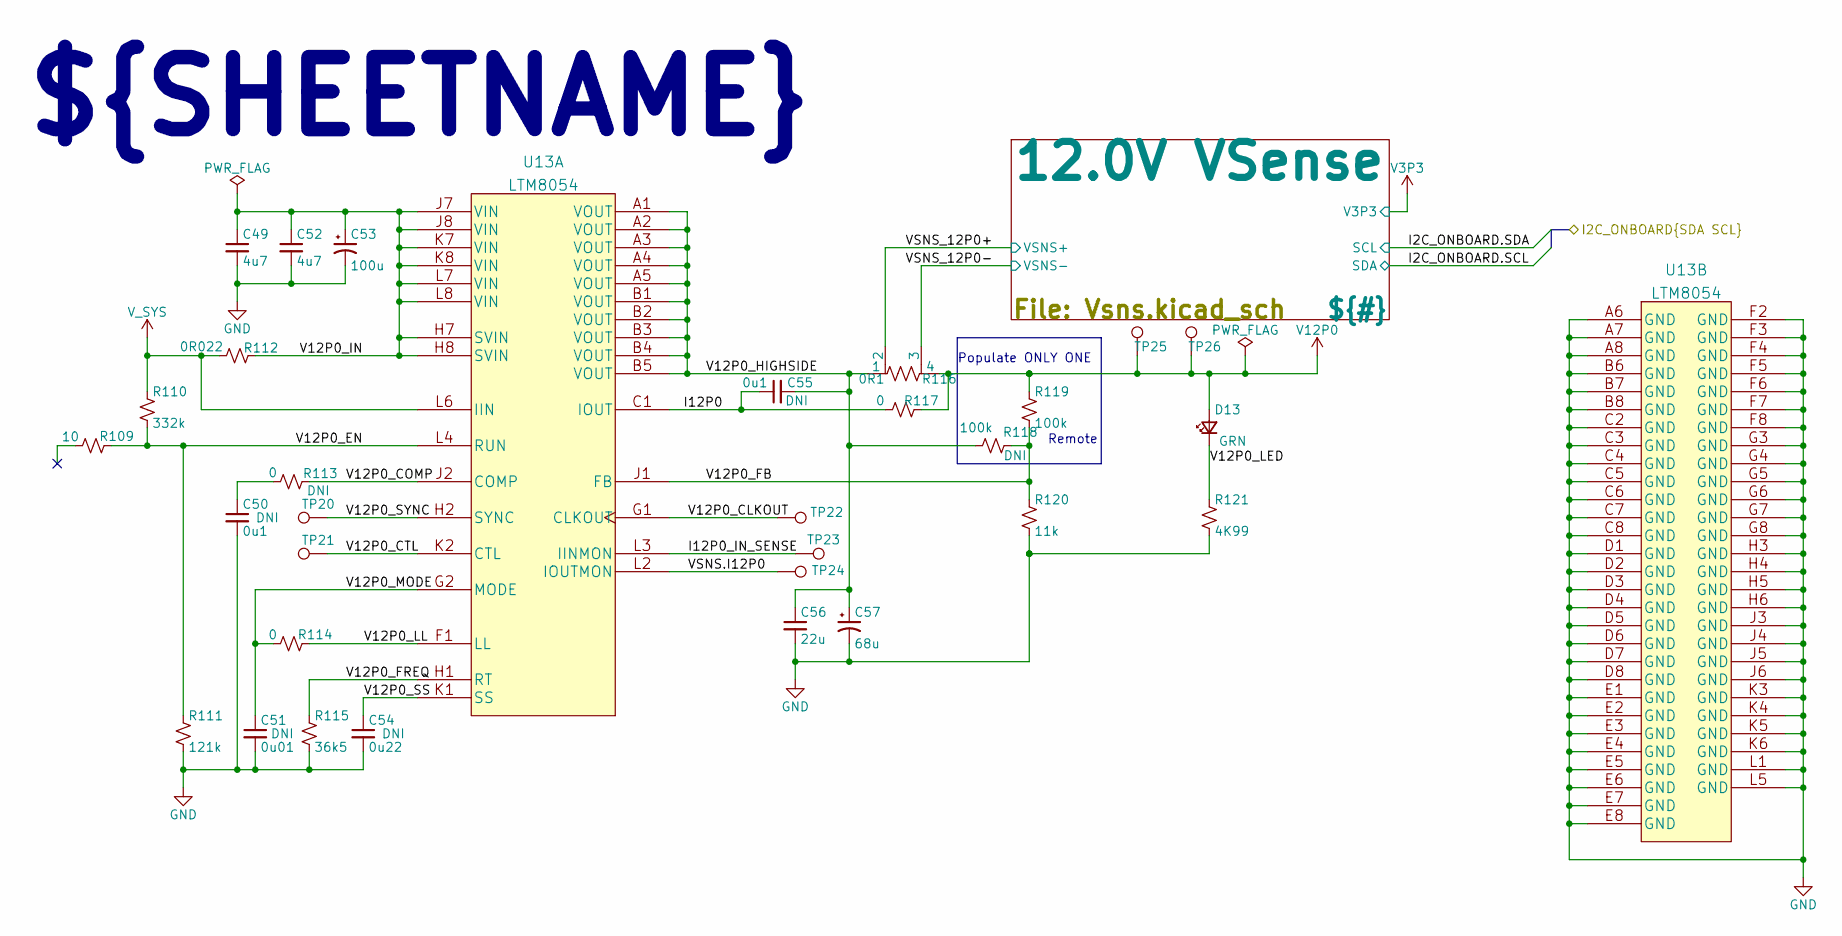
[picture p22: schematic V12P0_SYS.kicad_sch]

Parts:
C49, C52: 4u7; C_1206_3216Metric_Pad1.33x1.80mm_HandSolder; MPN CL31B475KBHNFNE
C50, C55: 0u1; C_0603_1608Metric_Pad1.08x0.95mm_HandSolder; MPN C0603C104J5RACTU
C51: 0u01; C_0603_1608Metric_Pad1.08x0.95mm_HandSolder; MPN CC0603KRX7R7BB103
C53: 100u; CP_Radial_D12.5mm_P5.00mm; MPN UPJ1J101MHD6
C54: 0u22; C_0603_1608Metric_Pad1.08x0.95mm_HandSolder; MPN CL10B224KO8NFNC
C56: 22u; C_2220_5650Metric_Pad1.97x5.40mm_HandSolder; MPN KRM55QR7YA226KH01L
C57: 68u; CP_EIA-7343-31_Kemet-D_Pad2.25x2.55mm_HandSolder; MPN T495D686K020ATE300
D13: GRN; LED_0603_1608Metric_Pad1.05x0.95mm_HandSolder; MPN 150060VS55040
R109: 10; R_0603_1608Metric_Pad0.98x0.95mm_HandSolder; MPN CR0603-FX-10R0ELF
R110: 332k; R_0603_1608Metric_Pad0.98x0.95mm_HandSolder; MPN RT0603FRE07332KL
R111: 121k; R_0603_1608Metric_Pad0.98x0.95mm_HandSolder; MPN RT0603FRE07121KL
R112: 0R022; R_0805_2012Metric_Pad1.20x1.40mm_HandSolder; MPN ERJ-6CWDR022V
R113, R114, R117: 0; R_0603_1608Metric_Pad0.98x0.95mm_HandSolder; MPN RC0603FR-130RL
R115: 36k5; R_0603_1608Metric_Pad0.98x0.95mm_HandSolder; MPN RC0603FR-0736K5L
R116: 0R1; WSL3637
R118, R119: 100k; R_0603_1608Metric_Pad0.98x0.95mm_HandSolder; MPN RC0603FR-10100KL
R120: 11k; R_0603_1608Metric_Pad0.98x0.95mm_HandSolder; MPN RT0603FRE0711KL
R121: 4K99; R_0603_1608Metric_Pad0.98x0.95mm_HandSolder; MPN AC0603FR-134K99L
TP20, TP21, TP22, TP23, TP24, TP25, TP26: TestPoint; TestPoint_Pad_D2.0mm
U13: LTM8054; LTM8054IY-PBF; MPN LTM8054EY#PBF

Connections:
GND: C49.2, C50.2, C51.2, C52.2, C53.2, C54.2, C56.2, C57.2, R111.2, R115.2, R120.2, R121.2, U13.A6 (GND), U13.A7 (GND), U13.A8 (GND), U13.B6 (GND), U13.B7 (GND), U13.B8 (GND), U13.C2 (GND), U13.C3 (GND), U13.C4 (GND), U13.C5 (GND), U13.C6 (GND), U13.C7 (GND), U13.C8 (GND), U13.D1 (GND), U13.D2 (GND), U13.D3 (GND), U13.D4 (GND), U13.D5 (GND), U13.D6 (GND), U13.D7 (GND), U13.D8 (GND), U13.E1 (GND), U13.E2 (GND), U13.E3 (GND), U13.E4 (GND), U13.E5 (GND), U13.E6 (GND), U13.E7 (GND), U13.E8 (GND), U13.F2 (GND), U13.F3 (GND), U13.F4 (GND), U13.F5 (GND), U13.F6 (GND), U13.F7 (GND), U13.F8 (GND), U13.G3 (GND), U13.G4 (GND), U13.G5 (GND), U13.G6 (GND), U13.G7 (GND), U13.G8 (GND), U13.H3 (GND), U13.H4 (GND), U13.H5 (GND), U13.H6 (GND), U13.J3 (GND), U13.J4 (GND), U13.J5 (GND), U13.J6 (GND), U13.K3 (GND), U13.K4 (GND), U13.K5 (GND), U13.K6 (GND), U13.L1 (GND), U13.L5 (GND)
I12P0: C55.1, R117.2, U13.C1 (IOUT)
I12P0_IN_SENSE: TP23.1, U13.L3 (IINMON)
unnamed: C50.1, R113.2
V12P0: D13.2 (A), R116.4, R117.1, R119.1, TP25.1, TP26.1
V12P0_CLKOUT: TP22.1, U13.G1 (CLKOUT)
V12P0_COMP: R113.1, U13.J2 (COMP)
V12P0_CTL: TP21.1, U13.K2 (CTL)
V12P0_EN: R109.1, R110.2, R111.1, U13.L4 (RUN)
V12P0_FB: R118.2, R119.2, R120.1, U13.J1 (FB)
V12P0_FREQ: R115.1, U13.H1 (RT)
V12P0_HIGHSIDE: C55.2, C56.1, C57.1, R116.1, R118.1, U13.A1 (VOUT), U13.A2 (VOUT), U13.A3 (VOUT), U13.A4 (VOUT), U13.A5 (VOUT), U13.B1 (VOUT), U13.B2 (VOUT), U13.B3 (VOUT), U13.B4 (VOUT), U13.B5 (VOUT)
V12P0_IN: C49.1, C52.1, C53.1, R112.1, U13.H7 (SVIN), U13.H8 (SVIN), U13.J7 (VIN), U13.J8 (VIN), U13.K7 (VIN), U13.K8 (VIN), U13.L7 (VIN), U13.L8 (VIN)
V12P0_LED: D13.1 (K), R121.1
V12P0_LL: R114.1, U13.F1 (LL)
V12P0_MODE: C51.1, R114.2, U13.G2 (MODE)
V12P0_SS: C54.1, U13.K1 (SS)
V12P0_SYNC: TP20.1, U13.H2 (SYNC)
VSNS.I12P0: TP24.1, U13.L2 (IOUTMON)
VSNS_12P0+: R116.2
VSNS_12P0-: R116.3
V_SYS: R110.1, R112.2, U13.L6 (IIN)

Notes on the sheet:
${SHEETNAME}
Populate ONLY ONE
Remote
