ruralguru/ClockRadio_Motherboard/VDD_AMP.kicad_sch

## KiCad design VDD_AMP.kicad_sch (2022-05-10)

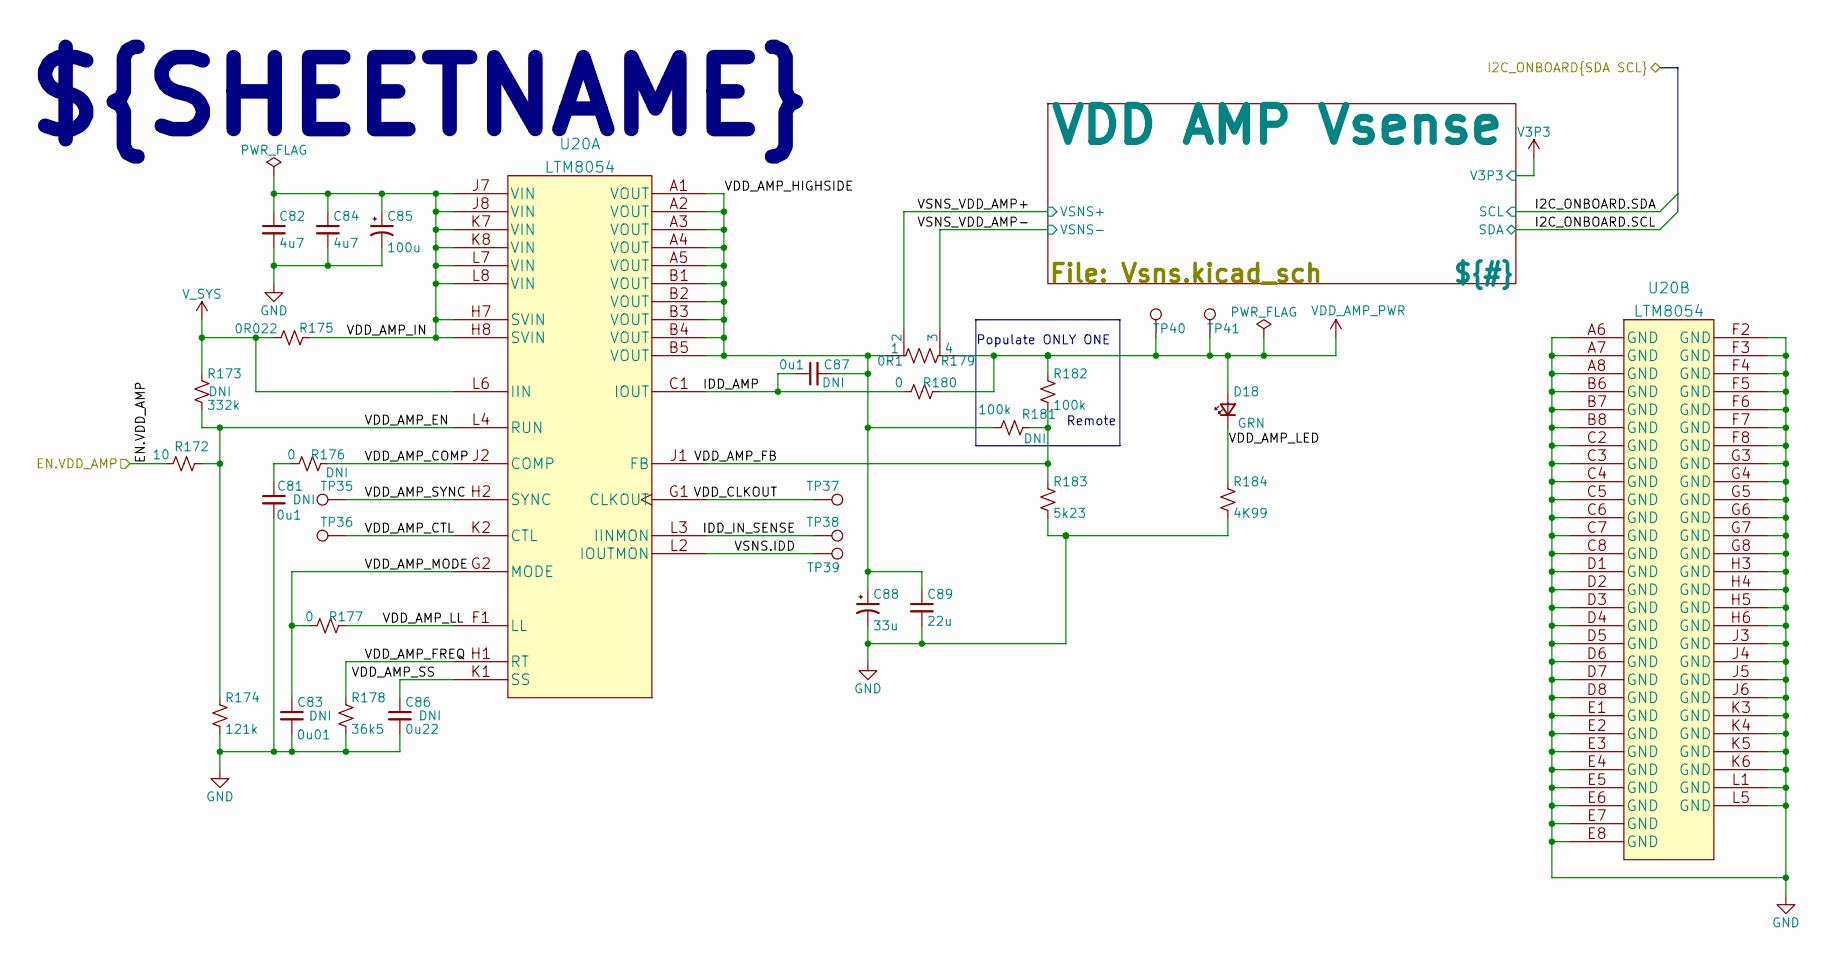
[picture p23: schematic VDD_AMP.kicad_sch]

Parts:
C81, C87: 0u1; C_0603_1608Metric_Pad1.08x0.95mm_HandSolder; MPN C0603C104J5RACTU
C82, C84: 4u7; C_1206_3216Metric_Pad1.33x1.80mm_HandSolder; MPN CL31B475KBHNFNE
C83: 0u01; C_0603_1608Metric_Pad1.08x0.95mm_HandSolder; MPN CC0603KRX7R7BB103
C85: 100u; CP_Radial_D12.5mm_P5.00mm; MPN UPJ1J101MHD6
C86: 0u22; C_0603_1608Metric_Pad1.08x0.95mm_HandSolder; MPN CL10B224KO8NFNC
C88: 33u; CP_EIA-7343-31_Kemet-D_Pad2.25x2.55mm_HandSolder; MPN T495D336K035ATE300
C89: 22u; C_2220_5650Metric_Pad1.97x5.40mm_HandSolder; MPN KRM55QR7YA226KH01L
D18: GRN; LED_0603_1608Metric_Pad1.05x0.95mm_HandSolder; MPN 150060VS55040
R172: 10; R_0603_1608Metric_Pad0.98x0.95mm_HandSolder; MPN CR0603-FX-10R0ELF
R173: 332k; R_0603_1608Metric_Pad0.98x0.95mm_HandSolder; MPN RT0603FRE07332KL
R174: 121k; R_0603_1608Metric_Pad0.98x0.95mm_HandSolder; MPN RT0603FRE07121KL
R175: 0R022; R_0805_2012Metric_Pad1.20x1.40mm_HandSolder; MPN ERJ-6CWDR022V
R176, R177, R180: 0; R_0603_1608Metric_Pad0.98x0.95mm_HandSolder; MPN RC0603FR-130RL
R178: 36k5; R_0603_1608Metric_Pad0.98x0.95mm_HandSolder; MPN RC0603FR-0736K5L
R179: 0R1; WSL3637
R181, R182: 100k; R_0603_1608Metric_Pad0.98x0.95mm_HandSolder; MPN RC0603FR-10100KL
R183: 5k23; R_0603_1608Metric_Pad0.98x0.95mm_HandSolder; MPN RC0603FR-075K23L
R184: 4K99; R_0603_1608Metric_Pad0.98x0.95mm_HandSolder; MPN AC0603FR-134K99L
TP35, TP36, TP37, TP38, TP39, TP40, TP41: TestPoint; TestPoint_Pad_D2.0mm
U20: LTM8054; LTM8054IY-PBF; MPN LTM8054EY#PBF

Connections:
EN.VDD_AMP: R172.2
GND: C81.2, C82.2, C83.2, C84.2, C85.2, C86.2, C88.2, C89.2, R174.2, R178.2, R183.2, R184.2, U20.A6 (GND), U20.A7 (GND), U20.A8 (GND), U20.B6 (GND), U20.B7 (GND), U20.B8 (GND), U20.C2 (GND), U20.C3 (GND), U20.C4 (GND), U20.C5 (GND), U20.C6 (GND), U20.C7 (GND), U20.C8 (GND), U20.D1 (GND), U20.D2 (GND), U20.D3 (GND), U20.D4 (GND), U20.D5 (GND), U20.D6 (GND), U20.D7 (GND), U20.D8 (GND), U20.E1 (GND), U20.E2 (GND), U20.E3 (GND), U20.E4 (GND), U20.E5 (GND), U20.E6 (GND), U20.E7 (GND), U20.E8 (GND), U20.F2 (GND), U20.F3 (GND), U20.F4 (GND), U20.F5 (GND), U20.F6 (GND), U20.F7 (GND), U20.F8 (GND), U20.G3 (GND), U20.G4 (GND), U20.G5 (GND), U20.G6 (GND), U20.G7 (GND), U20.G8 (GND), U20.H3 (GND), U20.H4 (GND), U20.H5 (GND), U20.H6 (GND), U20.J3 (GND), U20.J4 (GND), U20.J5 (GND), U20.J6 (GND), U20.K3 (GND), U20.K4 (GND), U20.K5 (GND), U20.K6 (GND), U20.L1 (GND), U20.L5 (GND)
IDD_AMP: C87.1, R180.2, U20.C1 (IOUT)
IDD_IN_SENSE: TP38.1, U20.L3 (IINMON)
unnamed: C81.1, R176.2
VDD_AMP_COMP: R176.1, U20.J2 (COMP)
VDD_AMP_CTL: TP36.1, U20.K2 (CTL)
VDD_AMP_EN: R172.1, R173.2, R174.1, U20.L4 (RUN)
VDD_AMP_FB: R181.2, R182.2, R183.1, U20.J1 (FB)
VDD_AMP_FREQ: R178.1, U20.H1 (RT)
VDD_AMP_HIGHSIDE: C87.2, C88.1, C89.1, R179.1, R181.1, U20.A1 (VOUT), U20.A2 (VOUT), U20.A3 (VOUT), U20.A4 (VOUT), U20.A5 (VOUT), U20.B1 (VOUT), U20.B2 (VOUT), U20.B3 (VOUT), U20.B4 (VOUT), U20.B5 (VOUT)
VDD_AMP_IN: C82.1, C84.1, C85.1, R175.1, U20.H7 (SVIN), U20.H8 (SVIN), U20.J7 (VIN), U20.J8 (VIN), U20.K7 (VIN), U20.K8 (VIN), U20.L7 (VIN), U20.L8 (VIN)
VDD_AMP_LED: D18.1 (K), R184.1
VDD_AMP_LL: R177.1, U20.F1 (LL)
VDD_AMP_MODE: C83.1, R177.2, U20.G2 (MODE)
VDD_AMP_PWR: D18.2 (A), R179.4, R180.1, R182.1, TP40.1, TP41.1
VDD_AMP_SS: C86.1, U20.K1 (SS)
VDD_AMP_SYNC: TP35.1, U20.H2 (SYNC)
VDD_CLKOUT: TP37.1, U20.G1 (CLKOUT)
VSNS.IDD: TP39.1, U20.L2 (IOUTMON)
VSNS_VDD_AMP+: R179.2
VSNS_VDD_AMP-: R179.3
V_SYS: R173.1, R175.2, U20.L6 (IIN)

Notes on the sheet:
${SHEETNAME}
Populate ONLY ONE
Remote
