ruralguru/ClockRadio_Motherboard/Vsns.kicad_sch

## KiCad design Vsns.kicad_sch (2022-05-10)

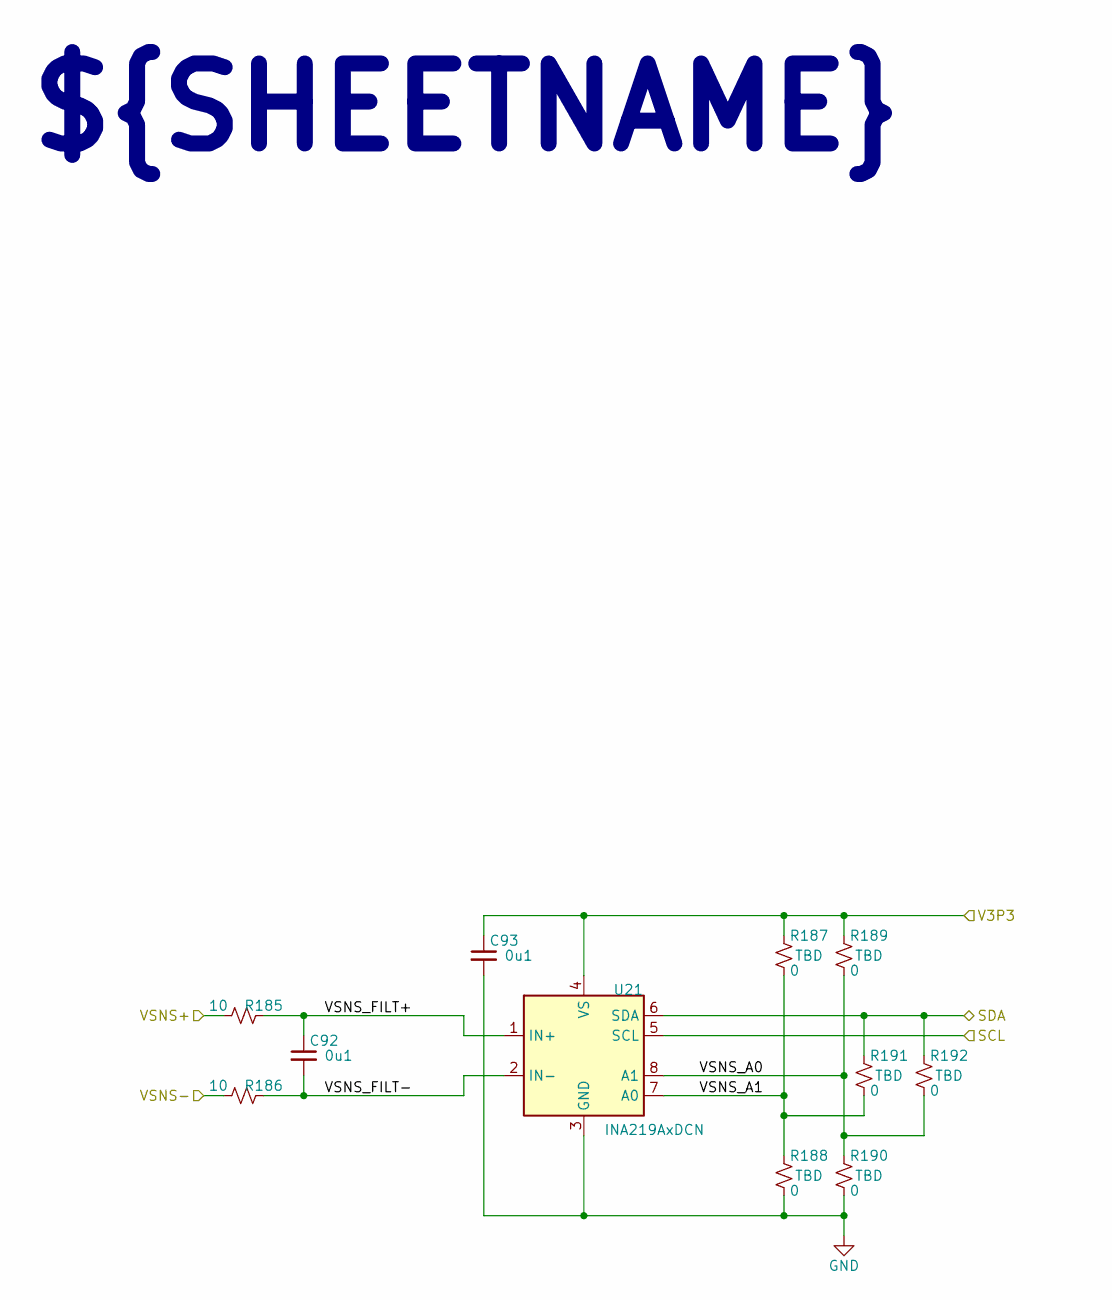
[picture p24: schematic Vsns.kicad_sch]

Parts:
C92, C93: 0u1; C_0603_1608Metric_Pad1.08x0.95mm_HandSolder; MPN C0603C104J5RACTU
R185, R186: 10; R_0603_1608Metric_Pad0.98x0.95mm_HandSolder; MPN CR0603-FX-10R0ELF
R187, R188, R189, R190, R191, R192: 0; R_0603_1608Metric_Pad0.98x0.95mm_HandSolder; MPN RC0603FR-130RL
U21: INA219AxDCN; SOT-23-8; MPN INA219AIDCNR

Connections:
GND: C93.2, R188.2, R190.2, U21.3 (GND)
SCL: U21.5 (SCL)
SDA: R191.1, R192.1, U21.6 (SDA)
V3P3: C93.1, R187.1, R189.1, U21.4 (VS)
VSNS+: R185.2
VSNS-: R186.2
VSNS_A0: R189.2, R190.1, R192.2, U21.8 (A1)
VSNS_A1: R187.2, R188.1, R191.2, U21.7 (A0)
VSNS_FILT+: C92.1, R185.1, U21.1 (IN+)
VSNS_FILT-: C92.2, R186.1, U21.2 (IN-)

Notes on the sheet:
${SHEETNAME}
